ispbillingai/freeispserverbox/concept-prompts/bottombox-render-prompt.md

# FreeISP Bottom Power/Cable Box — Render Prompt (Ubiquiti M2 slanted style)

The wiring/power compartment that bolts UNDER the main enclosure: power-in/out +
internet glands, click-to-close cover (moving) over a fixed base, unused holes cap off.

## ⭐ BEST PROMPT (NanoStation M2 language — the junction-box version below MISSED it)
Photorealistic product render of a slim, elegant cable-and-power management module in
the exact design language of a Ubiquiti NanoStation Loco M2 — a clean minimalist
matte-white device, slim and gently tapered, smooth rounded edges, no visible screws on
the front. It mounts under a smart WiFi hotspot enclosure. Its signature feature is a
SNAP-OFF / SLIDE-OFF cable-management cover (the moving part) running along the lower
face that conceals all the cable routing; with the cover slid half-off it reveals a
recessed channel holding cable glands labelled "POWER IN", "POWER OUT", "INTERNET",
neat terminal blocks and a small rocker switch. Unused gland holes are capped with
flush snap-in blanking plugs. One thin green "FreeISP" accent line. Three-quarter angle
with the cover half-removed so you see BOTH the clean closed M2 look and the hidden
cable channel inside. Soft studio lighting, light-grey gradient background, ultra sharp,
4k, world-class minimalist industrial design exactly like Ubiquiti NanoStation,
professional product photography.

## (older) generic junction-box prompt — missed the slim M2 concept
Photorealistic product render of a premium weatherproof power-and-cable junction
module that mounts UNDERNEATH a smart WiFi hotspot enclosure — a compact modern unit
about 290 × 120 × 50 mm, matte light-grey ABS, in the clean industrial style of
Ubiquiti airMAX / NanoStation M2 gear. The form has a SLANTED, tapered lower face (a
subtle wedge). On the angled bottom face sit several cable glands clearly labelled
"POWER IN", "POWER OUT" and "INTERNET"; two extra unused gland holes are neatly capped
with clean removable blanking plugs (knockouts). A snap-fit CLICK-TO-CLOSE cover — the
moving part — opens on a discreet hinge to reveal the terminal/switch compartment
inside (terminal blocks + a rocker switch), with a fine flush seam line and a
weatherproof gasket where it clicks shut; the fixed base sits below it. Matte finish,
softly rounded edges, one thin green "FreeISP" accent line along the slant.
Three-quarter hero angle showing both the slant and the cover half-open, soft studio
lighting, clean light-grey gradient background, gentle reflections, ultra sharp, 4k,
world-class minimalist industrial design like Ubiquiti, professional product photography.

## VARIANTS
- CLOSED HERO: "...cover fully clicked shut, clean flush seam, all glands capped —
  show the sealed weatherproof look head-on."
- EXPLODED: "...exploded view: fixed base + glands/terminals, the click cover lifting
  off, and the snap-in blanking plugs floating out."

## MECHANISM NOTES (for turning into CAD later)
- FIXED base: holds glands, terminal blocks, switch; bolts up to the enclosure.
- MOVING cover: snap-fit lid on a living hinge; push = clicks shut (hook + catch),
  grip-pull = pops open. (Same snap-latch family as the enclosure access door.)
- Closable holes: each gland position is a knockout with a snap-in blanking plug;
  unused = capped + weatherproof.

## TIPS
- Add: "render the words exactly: POWER IN, POWER OUT, INTERNET, FreeISP."
- Generate 3-4, pick best, send to Claude to build into Fusion CAD.
