ispbillingai/freeispserverbox/concept-prompts/module-current-render-prompt.md

# FreeISP Module (current design) — Render Prompts for ChatGPT/Midjourney

Goal: photoreal render of the CURRENT module so we can describe edits, PLUS a
signature "stylish line" to stand out (clean basic form + one distinctive accent,
the way premium energy/tech brands differentiate).

## MAIN PROMPT (signature glowing accent line)
Photorealistic product render of a premium smart WiFi hotspot control module — a
compact modern device about 135 × 120 × 40 mm, matte light-grey ABS plastic with a
fine soft-touch finish, gently rounded corners and a subtle chamfered top edge. The
clean top face has: a recessed panel framed by a fine engraved seam line; an engraved
"FreeISP" wordmark near the top; a small inset 1.8-inch LCD screen displaying
"ONLINE ● PPPoE 12  Hotspot 34"; two round status LEDs glowing bright green, labelled
POWER and INTERNET; and a tiny engraved spec block in the bottom corner reading
"FIR-HS250 · 12V DC 2A". Crisp fine vertical vent slots along the sides. THE SIGNATURE
DETAIL — one single thin glowing green accent light-line running cleanly across the
front, wrapping subtly around the lower body: a distinctive minimalist light stripe
that sets the brand apart. Three-quarter hero angle, soft cinematic studio lighting,
clean light-grey gradient background, gentle reflections, shallow depth of field,
ultra sharp, 4k, hyper-detailed, world-class minimalist industrial design in the
spirit of Ubiquiti, MikroTik and premium energy-tech brands, professional product
photography.

## ACCENT-LINE VARIANTS (swap the "SIGNATURE DETAIL" sentence)
- GLOW LINE: "one single thin glowing green light-line across the front edge."
- RECESSED GROOVE: "one crisp recessed accent groove with a glossy green inlay
  wrapping the body — a moulded signature line, not lit."
- TWO-TONE SEAM: "a clean two-tone split — matte light-grey top, darker grey base,
  divided by one sharp green pinstripe."
- CORNER WRAP: "a single green accent line that wraps one rounded corner from top
  to base, like a signature ribbon."

## TIPS
- Add: "render the words exactly: FreeISP, POWER, INTERNET, ONLINE — no spelling
  mistakes."
- Colours: "matte light-grey body, bright green accents (logo, LEDs, signature line),
  glossy black screen."
- Generate 3–4, pick the best, send to Claude to translate into the Fusion CAD.
