ispbillingai/freeispserverbox/concept-prompts/module-render-prompt.md

# FreeISP Smart-Module — Image-Render Prompts (for ChatGPT / Midjourney)

Use these for BEAUTY renders only (marketing/pitch). The buildable truth is the
Fusion CAD (`fusion/`). Renders ignore exact mm — they're for the look.

## 1. HERO — the ENCLOSED module (main prompt)
# Note: the module is a SEALED router unit. The TAP pad + screen live on the
# OUTSIDE product face (the RC522 reader sits inside and reads through plastic),
# NOT on the module. So the module itself is clean/sealed.
Photorealistic product render of a premium enclosed mini WiFi router — a small
sealed modern gadget like a MikroTik hEX or Ubiquiti EdgeRouter, about
135 × 120 × 40 mm, matte light-grey ABS plastic with a fine soft-touch texture,
generously rounded corners and a subtle chamfered top edge, clean seamless
one-piece body. A small glowing green "FreeISP" logo on top, and a neat row of
tiny green status indicator LEDs. Fine crisp horizontal vent louvres along both
side walls. A clean recessed row of ports along the front edge. No screen, no
buttons — a clean sealed premium enclosure. Three-quarter hero angle, light-grey
gradient studio background, soft cinematic studio lighting, gentle reflections,
shallow depth of field, ultra sharp, 4k, hyper-detailed, world-class industrial
product design, professional product photography.

## 2. FRONT-ON (matches the CAD top view — best for comparing to Fusion)
Same module as above, photographed perfectly straight-on (flat front view), the
top panel filling the frame, even soft lighting, no perspective distortion, clean
light-grey background, 4k product photography.

## 3. EXPLODED / "holds everything" (shows it's the brain)
The same FreeISP module shown as a clean exploded view: the premium vented top
shell lifting off to reveal a neat internal carrier board with an ESP32, a small
battery, and a buck converter screwed onto standoffs, thin wiring routed tidily,
matte black internals. Studio lighting, light-grey gradient background, 4k,
engineering-beauty product shot.

## Tips
- Add: "no spelling mistakes in the text, render the words exactly: FreeISP,
  POWER, INTERNET, TAP, ONLINE".
- If colours look off, add: "colour scheme: matte light grey body, bright green
  accents (logo + LEDs), glossy black screen".
- Generate 3–4 variations, pick the best, then send it to Claude to match the CAD.
