ispbillingai/freeispserverbox/firmware/DriveProof/summary.txt

DRV STORED row=1 strong=0.000 weak=0.000
DRV STORED row=2 strong=0.000 weak=0.000
DRV STORED row=3 strong=0.000 weak=0.000
DRV STORED row=4 strong=0.000 weak=0.000
DRV STORED row=5 strong=0.000 weak=0.000
DRV STORED row=6 strong=0.000 weak=0.000
DRV SAMPLE row=1 ok=1 s=570.12,680.12,692.88,685.00 w=836.12,868.88,911.12,904.75
DRV TARGET row=2 x=240
DRV SAMPLE row=2 ok=1 s=266.25,457.00,458.38,482.75 w=380.62,411.38,658.75,666.75
DRV TARGET row=3 x=240
DRV SAMPLE row=3 ok=1 s=202.88,205.88,207.75,207.88 w=306.25,312.12,309.12,314.12
DRV TARGET row=4 x=240
DRV SAMPLE row=4 ok=1 s=373.88,376.88,397.12,426.38 w=625.12,624.75,659.62,666.38
DRV TARGET row=5 x=240
DRV SAMPLE row=5 ok=1 s=150.00,150.75,153.50,155.38 w=312.38,319.00,316.50,319.88
DRV TARGET row=6 x=240
DRV SAMPLE row=6 ok=1 s=142.00,142.00,142.00,142.25 w=219.25,230.38,332.50,339.75
DRV RUN COMPLETE
DRV STORED row=1 strong=657.031 weak=880.219
DRV STORED row=2 strong=416.094 weak=529.375
DRV STORED row=3 strong=206.094 weak=310.406
DRV STORED row=4 strong=393.562 weak=643.969
DRV STORED row=5 strong=152.406 weak=316.938
DRV STORED row=6 strong=142.062 weak=280.469
DRV TARGET row=1 x=240
