ispbillingai/freeispserverbox/firmware/ResistanceProof/summary.txt

RES TARGET row=2 x=240
RES SAMPLE row=2 ok=1 u0=2864.38 down=2815.33 u1=2819.92 up=2739.88 u2=2699.33
RES TARGET row=3 x=240
RES SAMPLE row=3 ok=1 u0=2646.08 down=2566.00 u1=2591.88 up=2594.75 u2=2589.71
RES TARGET row=4 x=240
RES SAMPLE row=4 ok=1 u0=2871.83 down=2775.38 u1=2766.46 up=2743.75 u2=2748.21
RES TARGET row=5 x=240
RES SAMPLE row=5 ok=1 u0=2805.83 down=2756.83 u1=2772.21 up=2770.42 u2=2763.04
RES TARGET row=6 x=240
RES SAMPLE row=6 ok=1 u0=3118.00 down=3104.04 u1=3115.46 up=3058.75 u2=3059.83
RES RUN COMPLETE
RES TARGET row=1 x=240
