ispbillingai/freeispserverbox/firmware/FaceUI/home-preview.png

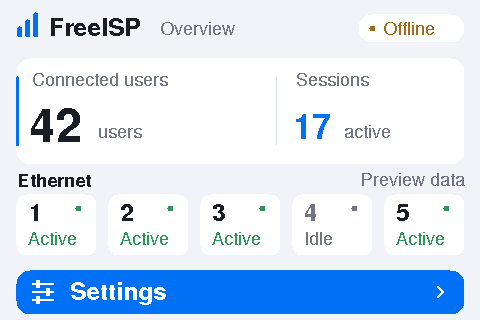
firmware/FaceUI/home-preview.png
