ispbillingai/freeispserverbox/pcb/board.png

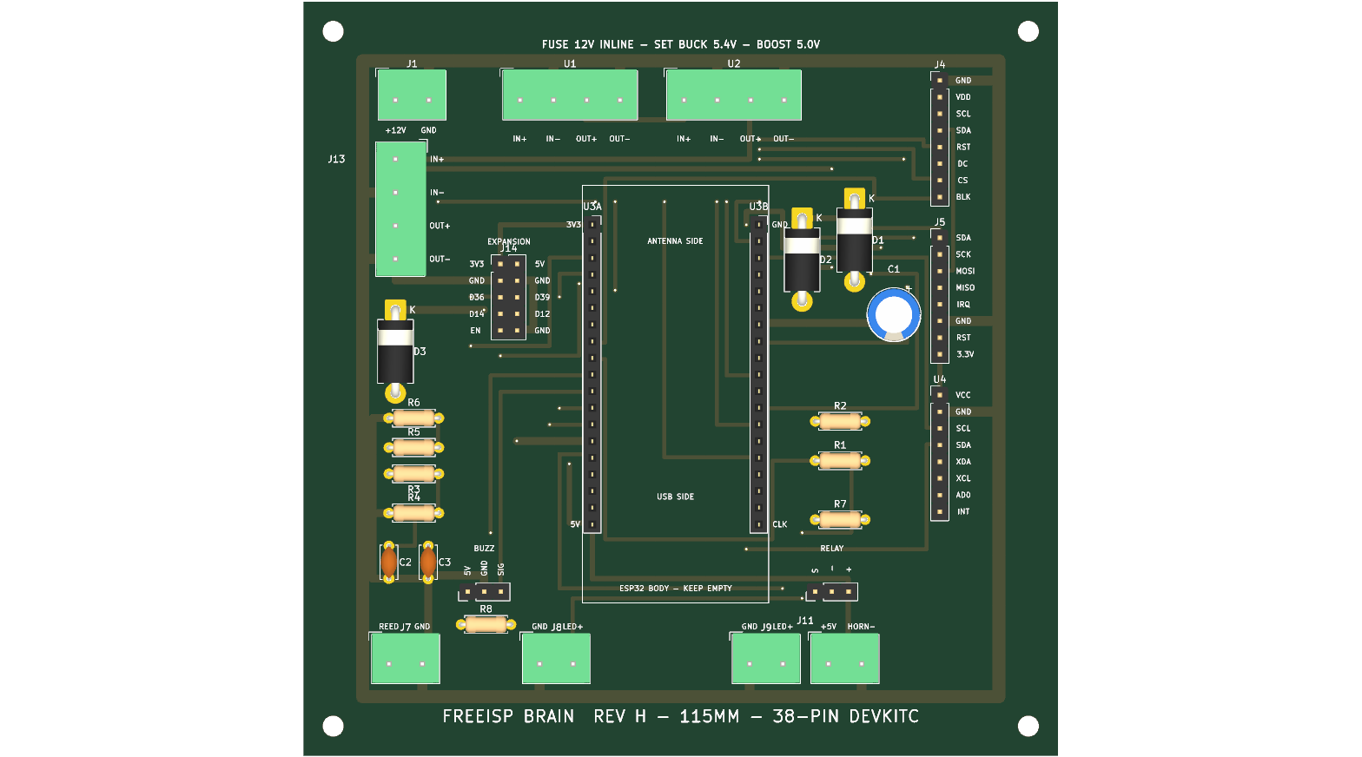
pcb/board.png
