ispbillingai/freeispserverbox/pcb/board_back.png

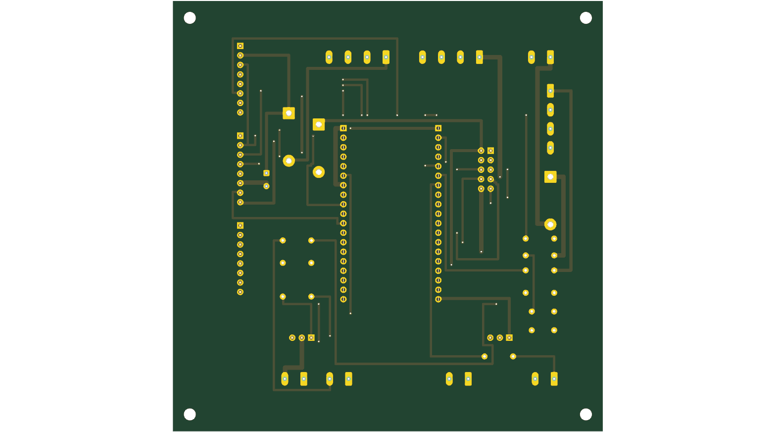
pcb/board_back.png
