ispbillingai/freeispserverbox/pcb/perfboard_layout.png

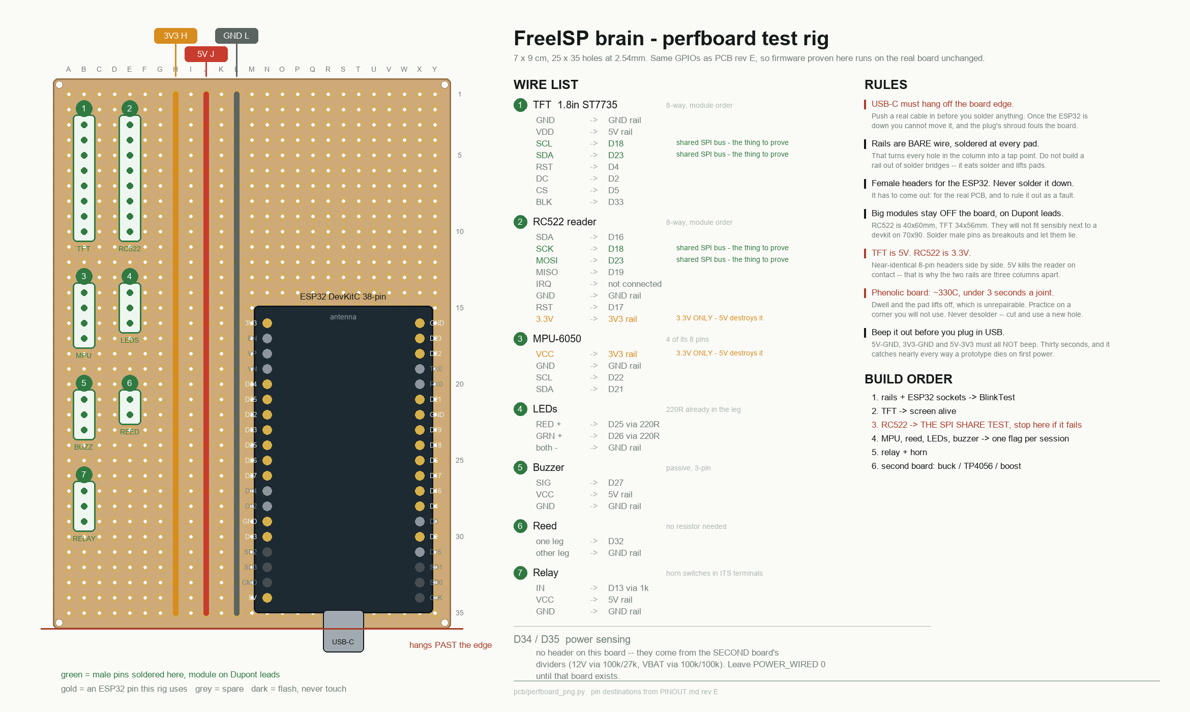
pcb/perfboard_layout.png
