ispbillingai/freeispserverbox/Test Prints/completed.stl

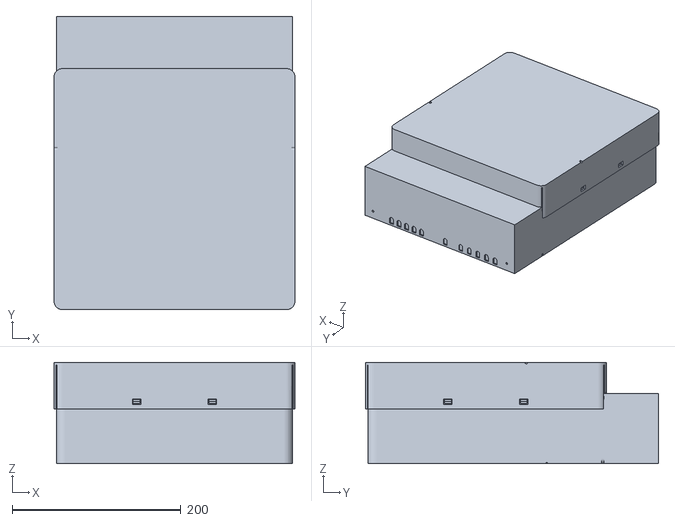
[picture p5: CAD file, 2026-08-18]
Test Prints/completed.stl
286.0 x 348.0 x 120.0
