ispbillingai/freeispserverbox/fir_module_lid.stl

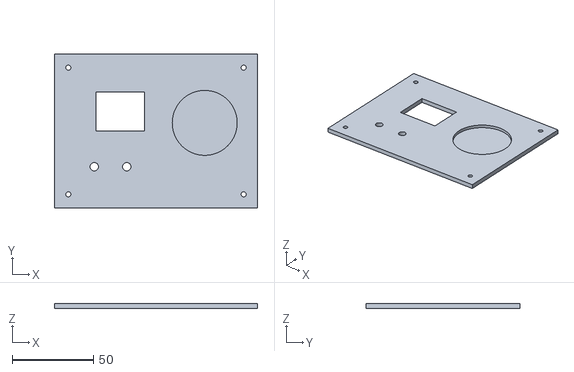
[picture p6: CAD file, 2026-07-08]
fir_module_lid.stl
125.0 x 95.0 x 3.00
