ispbillingai/freeispserverbox/Test Prints/modular final final final.stl

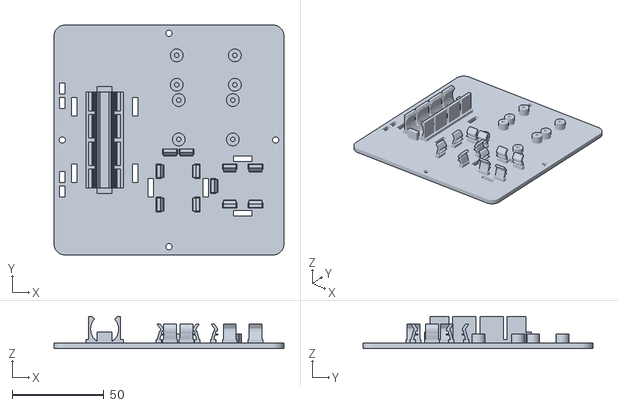
[picture p7: CAD file, 2026-08-18]
Test Prints/modular final final final.stl
125.0 x 125.0 x 17.5
