ispbillingai/freeispserverbox/fir_module_base.stl

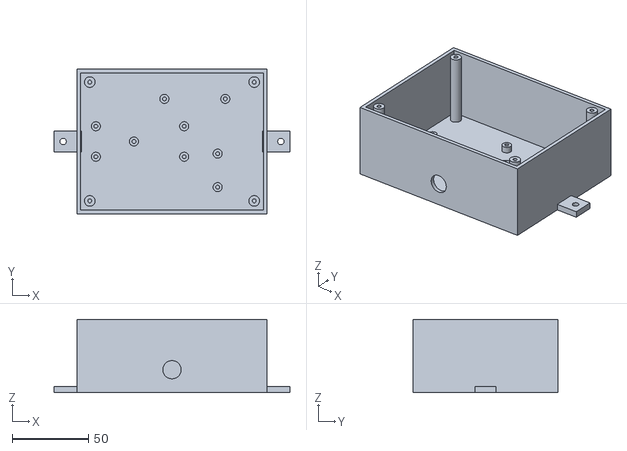
[picture p8: CAD file, 2026-07-08]
fir_module_base.stl
155.0 x 95.0 x 48.0
