ispbillingai/freeispserverbox/Test Prints/brainouter part.stl

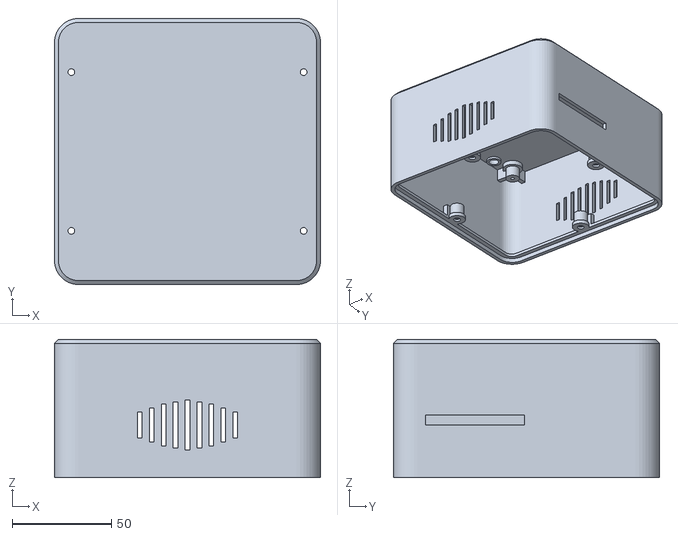
[picture p9: CAD file, 2026-08-18]
Test Prints/brainouter part.stl
134.0 x 134.0 x 69.6
