ispbillingai/freeispserverbox/Test Prints/modularplate.stl

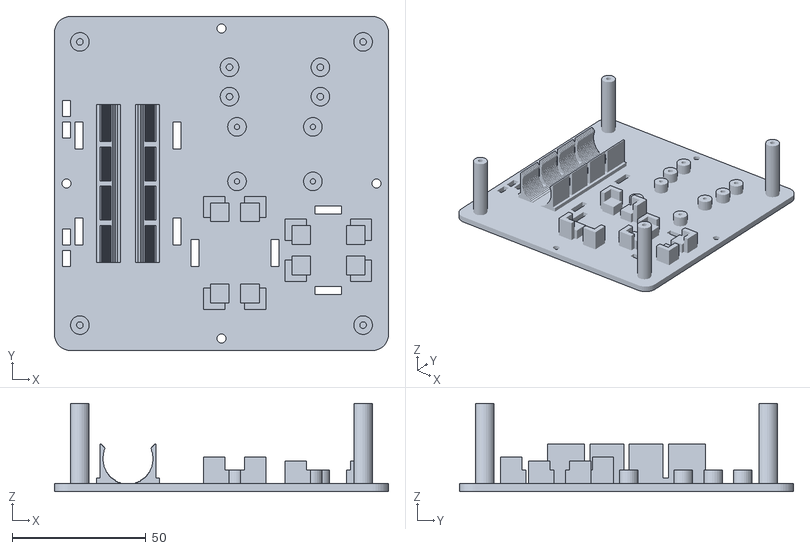
[picture p10: CAD file, 2026-08-18]
Test Prints/modularplate.stl
125.0 x 125.0 x 33.0
