ispbillingai/freeispserverbox/Test Prints/platetopfixedforfitting.stl

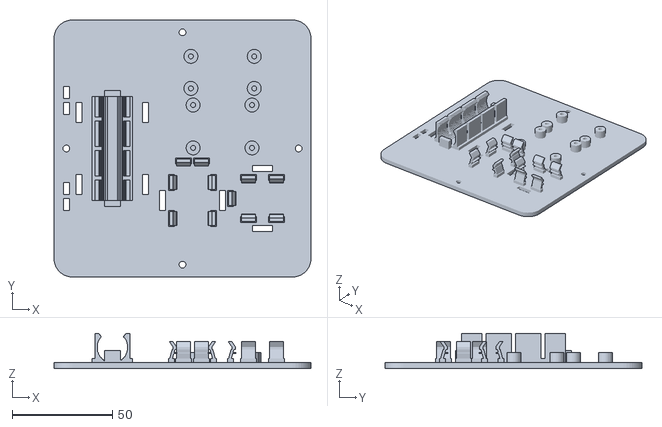
[picture p11: CAD file, 2026-08-18]
Test Prints/platetopfixedforfitting.stl
128.3 x 128.3 x 17.5
