ispbillingai/freeispserverbox/(list of files, cad)

Other CAD files:
Test Prints/final modular plate.stl
Test Prints/Freeispbrain cover plate.stl
Test Prints/completed.f3d
