ispbillingai/freeispserverbox/pcb/assembled.png

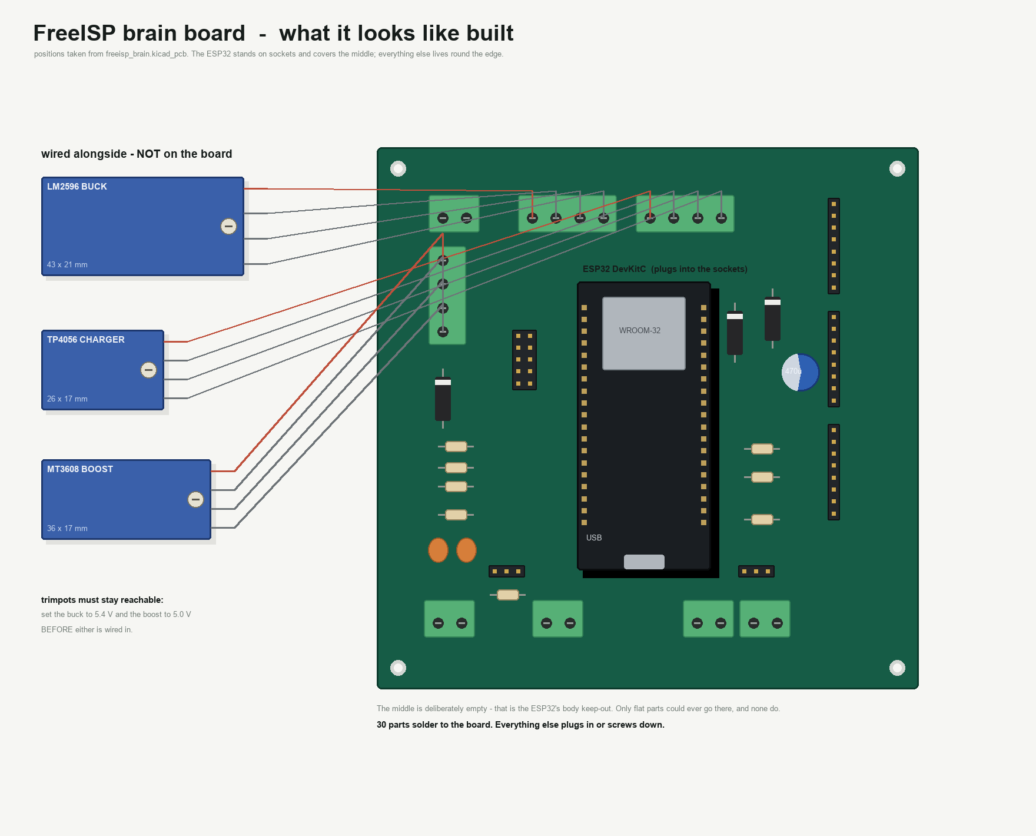
pcb/assembled.png
