ispbillingai/freeispserverbox/pcb/powerchain_wiring.png

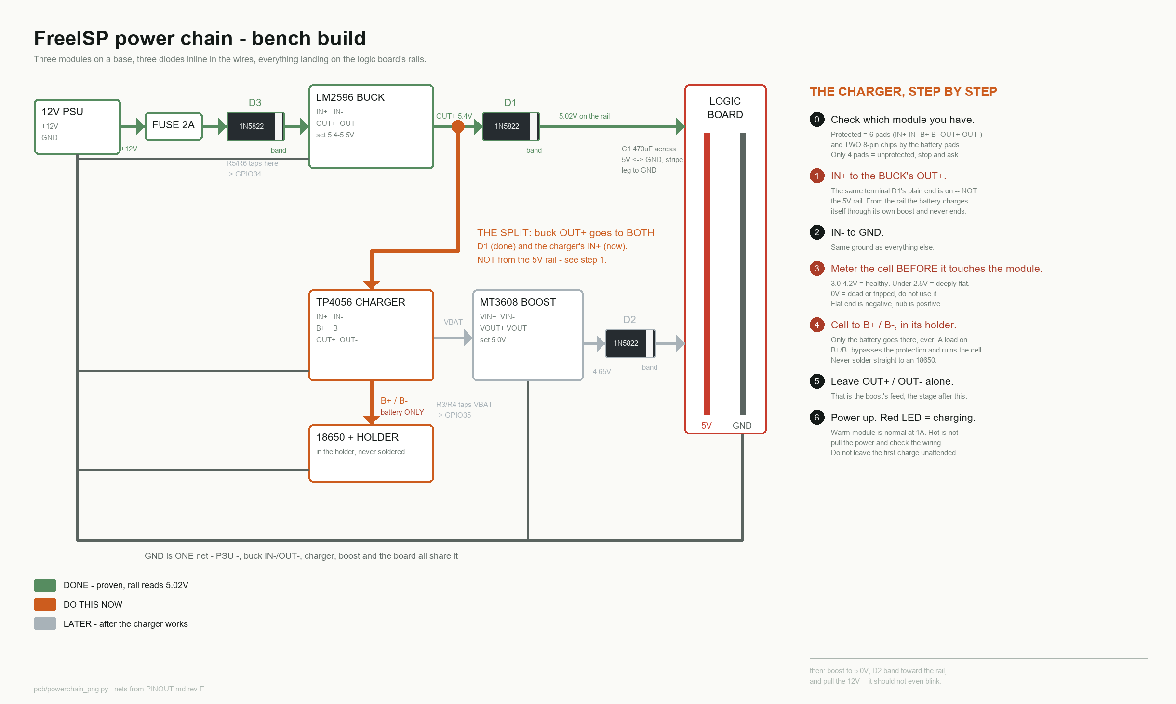
pcb/powerchain_wiring.png
