ispbillingai/freeispserverbox/pcb/wiring_diagram.png

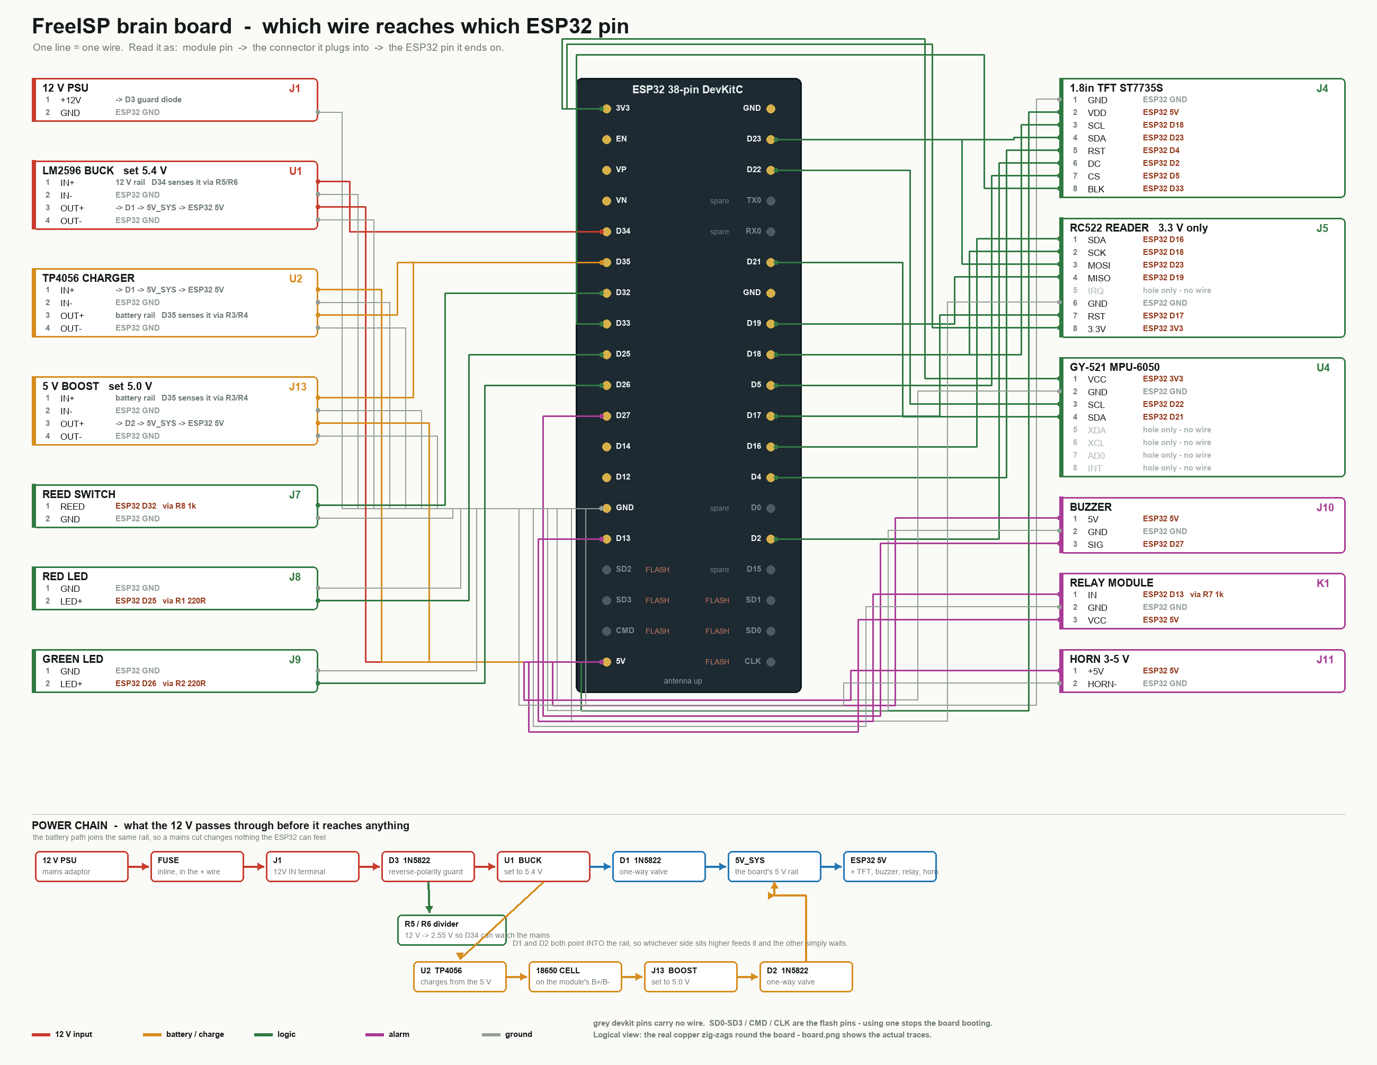
pcb/wiring_diagram.png
