ispbillingai/freeispserverbox/measurements/BOX_measurement_sheet.md

# FreeISP Box — Measurement Sheet (vernier, to 1 mm)

Fill in the blanks and send back. Start with Section A + B (MikroTik) — that's all I need
to design the bottom part. Do C–E when you can.

---------------------------------------------------------------------------
## A. MikroTik RB951 — overall body
- A1  Length (longest side, the port edge runs along this):  ______ mm
- A2  Width / depth (front-to-back):                          ______ mm
- A3  Height / thickness (how tall it sits):                  ______ mm
- A4  Port edge = a LONG side or a SHORT side?                ______

---------------------------------------------------------------------------
## B. MikroTik PORTS  ← the important one
HOW TO MEASURE (do it once, consistently):
  • Stand the 951 with the PORT FACE toward you, ports along the BOTTOM edge.
  • Pick the BOTTOM-LEFT corner of that face = your zero point (0,0).
  • For each port measure TWO numbers:
        X = sideways distance from the left corner to the CENTRE of the port
        Z = height from the bottom up to the CENTRE of the port
  • Also measure each opening's size.

(RB951Ui-2HnD usually has, left-to-right-ish: DC jack, 5x Ethernet, 1x USB, reset.)

| Port | X (mm) | Z (mm) | Opening size (mm) |
|---|---|---|---|
| DC power jack | | | Ø ______ |
| Ethernet 1 (PoE)| | | ____ x ____ |
| Ethernet 2 | | | (same as Eth1) |
| Ethernet 3 | | | |
| Ethernet 4 | | | |
| Ethernet 5 | | | |
| USB | | | ____ x ____ |
| Reset (if open) | | | |

Quick shortcut if the 5 Ethernet ports are evenly spaced:
  - X of the FIRST Ethernet centre: ______
  - centre-to-centre spacing (pitch): ______

---------------------------------------------------------------------------
## C. MikroTik mounting (underside)
- C1  Screw holes or rubber feet on the base?  (yes/no, positions): ______
- C2  Foot / standoff height:                                       ______

---------------------------------------------------------------------------
## D. Clearances (I'll suggest defaults if blank)
- D1  Gap you want around the 951 inside the box:   ______  (default 4 mm)
- D2  Wall thickness:                               ______  (default 2.5 mm)

---------------------------------------------------------------------------
## E. Box overall (decide once all parts are in — you mentioned ~300)
- E1  Internal LENGTH available:  ______
- E2  Internal WIDTH available:   ______
- E3  Internal HEIGHT available:  ______
