ispbillingai/freeispserverbox/firmware/DriveProof/calibrated-summary.txt

DRV STORED row=1 strong=0.000 weak=0.000 ratio=0.00000
DRV STORED row=2 strong=0.000 weak=0.000 ratio=0.00000
DRV STORED row=3 strong=0.000 weak=0.000 ratio=0.00000
DRV STORED row=4 strong=0.000 weak=0.000 ratio=0.00000
DRV STORED row=5 strong=0.000 weak=0.000 ratio=0.00000
DRV STORED row=6 strong=0.000 weak=0.000 ratio=0.00000
DRV SAMPLE row=1 ok=1 clipped=0 atten=0 s=747.75,762.88,781.38,787.75,804.75 w=870.25,895.12,917.62,919.38 q=1.20667,1.21859,1.23493,1.21435
DRV TARGET row=2 x=240
DRV SAMPLE row=2 ok=1 clipped=0 atten=0 s=403.38,503.38,542.75,539.12,536.62 w=490.62,644.88,648.25,652.00 q=1.09651,1.28945,1.24688,1.26442
DRV TARGET row=3 x=240
DRV SAMPLE row=3 ok=1 clipped=0 atten=0 s=559.25,558.50,538.25,473.50,476.62 w=689.38,667.88,639.62,573.88 q=1.29517,1.27321,1.32796,1.25178
DRV TARGET row=4 x=240
DRV SAMPLE row=4 ok=1 clipped=0 atten=0 s=224.00,223.12,226.88,223.88,228.75 w=299.00,300.75,303.00,306.38 q=1.37105,1.37043,1.37925,1.38998
DRV TARGET row=5 x=240
DRV SAMPLE row=5 ok=1 clipped=0 atten=0 s=483.00,484.12,490.88,491.38,491.38 w=692.38,698.00,691.50,705.12 q=1.54648,1.54763,1.51615,1.55321
DRV TARGET row=6 x=240
DRV SAMPLE row=6 ok=1 clipped=0 atten=0 s=204.00,208.00,231.62,231.50,245.50 w=322.25,327.25,358.12,370.75 q=1.62539,1.54257,1.61309,1.62469
DRV RUN COMPLETE
DRV STORED row=1 strong=776.900 weak=900.594 ratio=1.21647
DRV STORED row=2 strong=505.050 weak=608.938 ratio=1.25565
DRV STORED row=3 strong=521.225 weak=642.688 ratio=1.28419
DRV STORED row=4 strong=225.325 weak=302.281 ratio=1.37515
DRV STORED row=5 strong=488.150 weak=696.750 ratio=1.54705
DRV STORED row=6 strong=224.125 weak=344.594 ratio=1.61889
DRV TARGET row=1 x=240
