ispbillingai/freeispserverbox/pcb/fitcheck_1to1.pdf

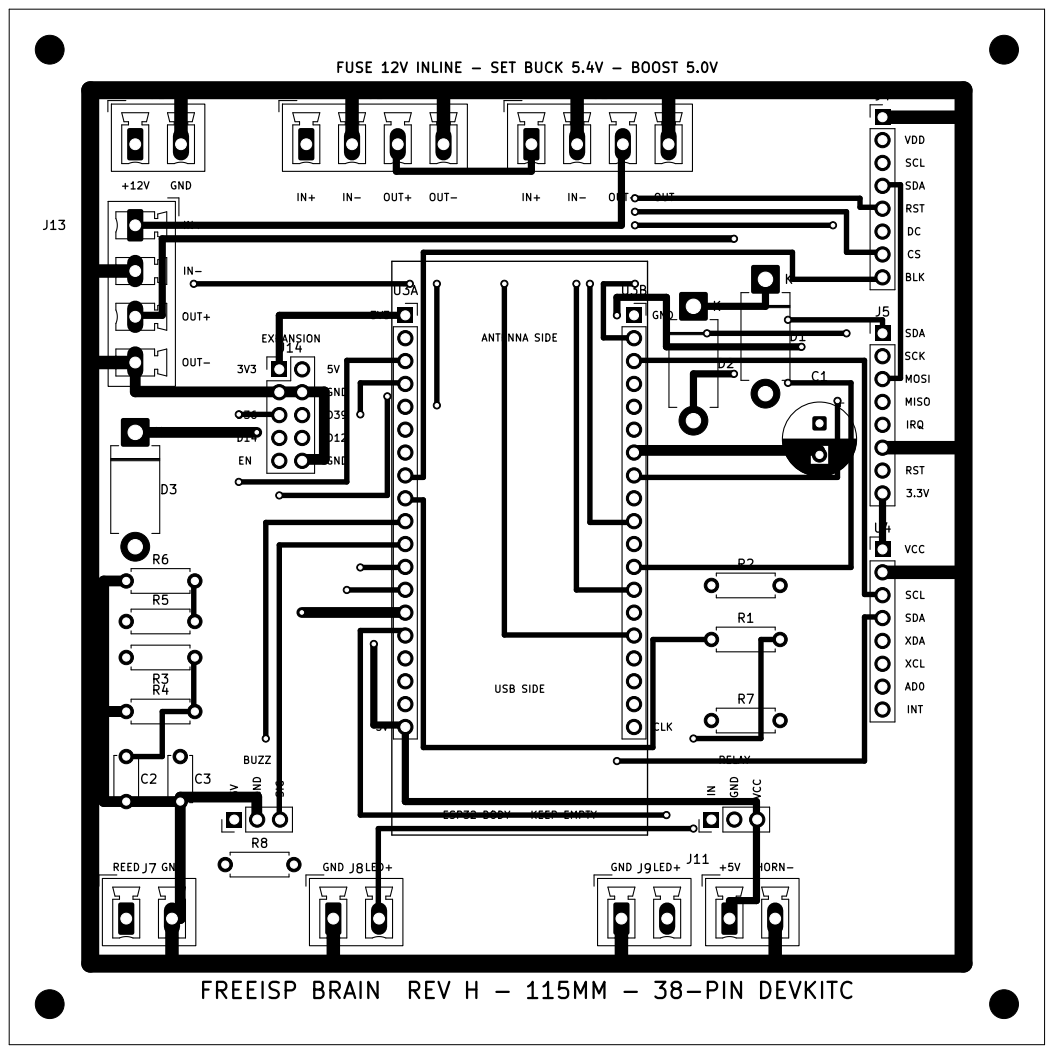
[picture p15: page 1]

VDD
SCL SDA RST DC

ANTENNA SIDE USB SIDE

SDA SCK MOSI MISO

GND
SCL SDA XDA XCL AD0

FREEISP BRAIN REV H - 115MM - 38-PIN DEVKITC
