ispbillingai/freeispserverbox/pcb/freeisp_brain.kicad_pcb

## KiCad design pcb/freeisp_brain.kicad_pcb (2026-08-12)

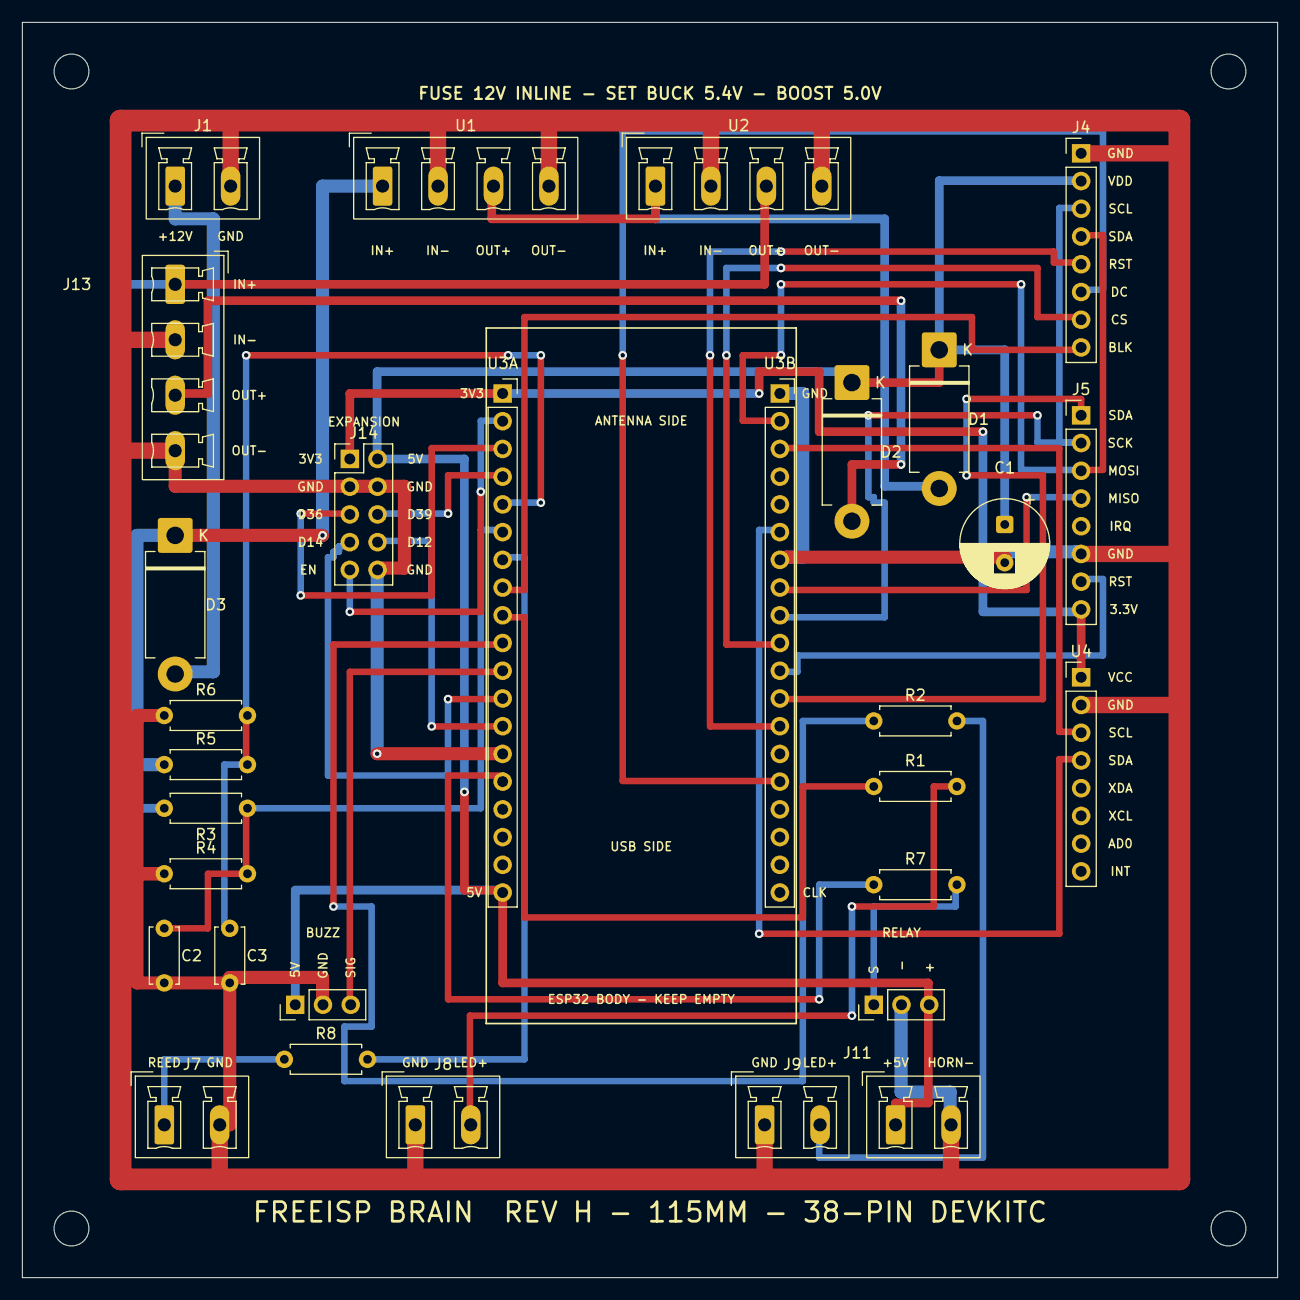
[picture p16: board freeisp_brain.kicad_pcb from above]

Board: 2 copper layers, 115.0 x 115.0 mm, 34 parts (0 on the bottom side), 35 nets.

Parts:
C1: 470u; CP_Radial_D8.0mm_P3.50mm
C2, C3: 100n; C_Disc_D5.0mm_W2.5mm_P5.00mm
D1, D2, D3: 1N5822; D_DO-201AD_P12.70mm_Horizontal
H1, H2, H3, H4: M3; MountingHole_3.2mm_M3
J1: 12V IN; PhoenixContact_MCV_1,5_2-G-5.08_1x02_P5.08mm_Vertical
J4: TFT; PinHeader_1x08_P2.54mm_Vertical
J5: RC522; PinHeader_1x08_P2.54mm_Vertical
J7: REED; PhoenixContact_MCV_1,5_2-G-5.08_1x02_P5.08mm_Vertical
J8: LED R; PhoenixContact_MCV_1,5_2-G-5.08_1x02_P5.08mm_Vertical
J9: LED G; PhoenixContact_MCV_1,5_2-G-5.08_1x02_P5.08mm_Vertical
J10: BUZZER; PinHeader_1x03_P2.54mm_Vertical
J11: HORN; PhoenixContact_MCV_1,5_2-G-5.08_1x02_P5.08mm_Vertical
J13: BOOST IN+ IN- OUT+ OUT-; PhoenixContact_MCV_1,5_4-G-5.08_1x04_P5.08mm_Vertical
J14: EXPANSION; PinHeader_2x05_P2.54mm_Vertical
K1: HORN RLY; PinHeader_1x03_P2.54mm_Vertical
R1, R2: 220R; R_Axial_DIN0207_L6.3mm_D2.5mm_P7.62mm_Horizontal
R3, R4, R5: 100k; R_Axial_DIN0207_L6.3mm_D2.5mm_P7.62mm_Horizontal
R6: 27k; R_Axial_DIN0207_L6.3mm_D2.5mm_P7.62mm_Horizontal
R7, R8: 1k; R_Axial_DIN0207_L6.3mm_D2.5mm_P7.62mm_Horizontal
U1: BUCK IN+ IN- OUT+ OUT-; PhoenixContact_MCV_1,5_4-G-5.08_1x04_P5.08mm_Vertical
U2: CHARGER IN+ IN- OUT+ OUT-; PhoenixContact_MCV_1,5_4-G-5.08_1x04_P5.08mm_Vertical
U3A: ESP32 L; PinSocket_1x19_P2.54mm_Vertical
U3B: ESP32 R; PinSocket_1x19_P2.54mm_Vertical
U4: MPU-6050; PinHeader_1x08_P2.54mm_Vertical

Connections:
+3V3: J5.8, J14.1, U3A.1, U4.1
+5V: D1.2, U1.3, U2.1
+5V_BAT: D2.2, J13.3
+5V_SYS: C1.1, D1.1, D2.1, J4.2, J10.1, J11.1, J14.2, K1.3, U3A.19
+12V: D3.1, R5.1, U1.1
+12V_IN: D3.2, J1.1
BUZZ: J10.3, U3A.11
EXP_D12: J14.8, U3A.13
EXP_D14: J14.7, U3A.12
EXP_D36: J14.5, U3A.3
EXP_D39: J14.6, U3A.4
EXP_EN: J14.9, U3A.2
GND: C1.2, C2.2, C3.2, J1.2, J4.1, J5.6, J7.2, J8.1, J9.1, J10.2, J11.2, J13.2, J13.4, J14.3, J14.4, J14.10, K1.2, R4.1, R6.1, U1.2, U1.4, U2.2, U2.4, U3A.14, U3B.1, U3B.7, U4.2
HORN_DRV: K1.1, R7.2
HORN_IN: R7.1, U3A.15
LED_G: R2.1, U3A.10
LED_G_A: J9.2, R2.2
LED_R: R1.1, U3A.9
LED_R_A: J8.2, R1.2
MISO: J5.4, U3B.8
MOSI: J4.4, J5.3, U3B.2
RC_RST: J5.7, U3B.11
RC_SS: J5.1, U3B.12
REED: R8.2, U3A.7
REED_F: J7.1, R8.1
SCK: J4.3, J5.2, U3B.9
SCL: U3B.3, U4.3
SDA: U3B.6, U4.4
SENSE_BATT: C2.1, R3.2, R4.2, U3A.6
SENSE_MAINS: C3.1, R5.2, R6.2, U3A.5
TFT_BLK: J4.8, U3A.8
TFT_CS: J4.7, U3B.10
TFT_DC: J4.6, U3B.15
TFT_RST: J4.5, U3B.13
VBAT: J13.1, R3.1, U2.3
