ispbillingai/freeispserverbox/pcb/build.py

"""Generate the FreeISP brain board as a standalone KiCad PCB.

Single copper layer, 100 x 100 mm, home-etchable. Stock KiCad footprints are
loaded from the installed library and embedded with placement + net data, so
pad geometry is KiCad's own rather than hand-rolled.

What this writes:  placement, nets, board outline, mounting holes, the
perimeter ground ring and its stubs, and the fused 12 V hops.
What it leaves:    signal routing -- that is done interactively in KiCad,
                   where the router enforces clearance properly.

    python build.py
"""

import json
import math
import os
import uuid as _uuid
import router
import sexp

FPLIB = r"F:\kicad\share\kicad\footprints"
OUT = os.path.join(os.path.dirname(os.path.abspath(__file__)), "freeisp_brain.kicad_pcb")

# board origin on the page: design (0,0) maps here
OX, OY = 60.0, 40.0
# 115mm: Francis's call ("11.5 so everything fits well and is not cramped")
# after the 38-pin devkit's body overhang showed up on the paper test.
# Leaves PCBWay's 100mm cheap tier (~$5 -> ~$15-25 for 5) -- accepted.
BW = BH = 115.0

RING = 9.0           # ground ring inset from the board edge
W_GND = 2.0          # perimeter ring, out in open copper
W_PWR = 1.5
W_HV = 2.5           # offered for the long 12 V horn run
# Stubs leave pads on 2.54 mm pitch, so they must stay narrow enough to clear
# the neighbouring pin: 1.9 mm pad + 0.6 mm clearance leaves 1.98 mm of room.
W_STUB = 1.5
# Fab rules, not etching rules. PCBWay's cheap tier does 0.15 mm; 0.25 mm is
# a comfortable margin and buys real routing room over the 0.6 mm we needed
# when the board was going to be made with chemicals in a tray.
CLEARANCE = 0.45
TRACK_MIN = 0.4

# Library pad sizes are right for a fab -- their drilling is accurate to about
# 0.05 mm, so there is nothing to compensate for. 0 means "leave as drawn".
PAD_P254 = 0
PAD_P508 = 0
PAD_RES = 0

LIB_SOCKET = "Connector_PinSocket_2.54mm"
LIB_HEADER = "Connector_PinHeader_2.54mm"
LIB_TERM = "Connector_Phoenix_MC_HighVoltage"
LIB_RES = "Resistor_THT"
LIB_DIODE = "Diode_THT"
LIB_CAP = "Capacitor_THT"
LIB_HOLE = "MountingHole"

FP_SOCKET19 = "PinSocket_1x19_P2.54mm_Vertical"
FP_TERM2 = "PhoenixContact_MCV_1,5_2-G-5.08_1x02_P5.08mm_Vertical"
FP_TERM4 = "PhoenixContact_MCV_1,5_4-G-5.08_1x04_P5.08mm_Vertical"
FP_RES = "R_Axial_DIN0207_L6.3mm_D2.5mm_P7.62mm_Horizontal"
FP_DIODE = "D_DO-201AD_P12.70mm_Horizontal"
FP_CAP_EL = "CP_Radial_D8.0mm_P3.50mm"
FP_CAP_D = "C_Disc_D5.0mm_W2.5mm_P5.00mm"
FP_HOLE = "MountingHole_3.2mm_M3"


def hdr(n):
    return f"PinHeader_1x0{n}_P2.54mm_Vertical"


# ---------------------------------------------------------------- nets
NETS = [
    "", "GND", "+5V", "+5V_BAT", "+5V_SYS", "+3V3", "+12V", "+12V_IN", "VBAT",
    "SENSE_BATT", "SENSE_MAINS", "REED", "REED_F", "LED_R", "LED_R_A", "LED_G",
    "LED_G_A", "BUZZ", "HORN_IN", "HORN_DRV", "MOSI", "MISO", "SCK", "TFT_CS",
    "TFT_DC", "TFT_RST", "TFT_BLK", "RC_SS", "RC_RST", "SDA", "SCL",
    # brought out to the expansion header for whatever comes later
    "EXP_D36", "EXP_D39", "EXP_D14", "EXP_D12", "EXP_EN",
]
NET_ID = {name: i for i, name in enumerate(NETS)}

# ---------------------------------------------------------------- parts
# ref: (lib, footprint, x, y, rot, value, {pad_number: net})
#
# ESP32 rows: 38-PIN DevKitC order (Francis counted 19 pins per side,
# 2026-07-30 -- NOT the 30-pin V1 the first draft assumed). Antenna up:
#   U3A (left):  3V3 EN VP VN 34 35 32 33 25 26 27 14 12 GND 13 SD2 SD3 CMD 5V
#   U3B (right): GND 23 22 TX0 RX0 21 GND 19 18 5 17 16 4 0 2 15 SD1 SD0 CLK
# SD0-SD3/CMD/CLK are the FLASH pins (GPIO6-11) -- they exist as holes and
# must stay unconnected forever. Row spacing DEFAULTS to 25.4mm (DevKitC
# standard) -- Francis verifies with the vernier + paper test before order.
ESP_ROW = 25.4
U3A_NETS = {
    1: "+3V3",       # 3V3 is top-LEFT on the 38-pin board
    5: "SENSE_MAINS",   # GPIO34
    6: "SENSE_BATT",    # GPIO35
    7: "REED",          # GPIO32
    8: "TFT_BLK",       # GPIO33
    9: "LED_R",         # GPIO25
    10: "LED_G",        # GPIO26
    11: "BUZZ",         # GPIO27
    14: "GND",
    15: "HORN_IN",      # GPIO13
    19: "+5V_SYS",      # 5V/VIN, bottom-left -- eats from whichever diode wins
    # --- spares brought out to J14, so a later idea needs no new board ---
    2: "EXP_EN",        # reset: a button to GND reboots the box
    3: "EXP_D36",       # VP  - input ONLY, ADC1, no internal pull-up
    4: "EXP_D39",       # VN  - input ONLY, ADC1, no internal pull-up
    12: "EXP_D14",      # a full GPIO with an internal pull-up: best for buttons
    13: "EXP_D12",      # strapping pin - must be LOW at boot
}
U3B_NETS = {
    1: "GND",
    2: "MOSI",          # GPIO23
    3: "SCL",           # GPIO22
    6: "SDA",           # GPIO21
    7: "GND",
    8: "MISO",          # GPIO19
    9: "SCK",           # GPIO18
    10: "TFT_CS",       # GPIO5
    11: "RC_RST",       # GPIO17
    12: "RC_SS",        # GPIO16
    13: "TFT_RST",      # GPIO4
    15: "TFT_DC",       # GPIO2
}

PARTS = {
    # --- power in, top row. The buck and charger are wire-pad modules, not
    # pluggable headers, so they bolt alongside and land on screw terminals.
    # Fuse the 12 V feed inline in the wire (silkscreened as a reminder).
    # +12V first to match PSU labelling (review M2). D3 downstream makes a
    # reversed hookup harmless instead of fatal to the buck.
    "J1":  (LIB_TERM, FP_TERM2, 14, 15, 0, "12V IN",
            {1: "+12V_IN", 2: "GND"}),
    "D3":  (LIB_DIODE, FP_DIODE, 14, 47, 270, "1N5822",
            {1: "+12V", 2: "+12V_IN"}),   # series reverse-polarity protection
    "U1":  (LIB_TERM, FP_TERM4, 33, 15, 0, "BUCK  IN+ IN- OUT+ OUT-",
            {1: "+12V", 2: "GND", 3: "+5V", 4: "GND"}),
    # Protected TP4056: the LOAD hangs on the module's OUT+/OUT- (behind the
    # DW01 protection FETs). The battery wires to the module's own B+/B- pads
    # directly and never touches this board. Labelling the terminal B+/B-
    # would instruct an unprotected discharge path.
    "U2":  (LIB_TERM, FP_TERM4, 58, 15, 0, "CHARGER  IN+ IN- OUT+ OUT-",
            {1: "+5V", 2: "GND", 3: "VBAT", 4: "GND"}),

    # --- backup power: step-up + the diode-OR where the two 5V rails meet.
    # Mains alive: buck 5V wins through D1 (charger tops the cell up).
    # Mains cut: boost 5V takes over through D2. No code, no switching.
    # Charger IN+ stays on the BUCK rail on purpose -- feeding it from
    # 5V_SYS would let the battery charge itself through the boost.
    # vertical down the left edge (rot 270 runs the pads downward)
    "J13": (LIB_TERM, FP_TERM4, 14, 24, 270, "BOOST  IN+ IN- OUT+ OUT-",
            {1: "VBAT", 2: "GND", 3: "+5V_BAT", 4: "GND"}),
    "D1":  (LIB_DIODE, FP_DIODE, 84, 30, 270, "1N5822",
            {1: "+5V_SYS", 2: "+5V"}),        # pad 1 = cathode (band UP)
    # vertical, right of U3B -- the 19-pin socket ate its old horizontal spot
    "D2":  (LIB_DIODE, FP_DIODE, 76, 33, 270, "1N5822",
            {1: "+5V_SYS", 2: "+5V_BAT"}),    # cathode/band UP

    # --- the brain: 38-pin DevKitC in two 19-pin sockets ---
    "U3A": (LIB_SOCKET, FP_SOCKET19, 44, 34, 0, "ESP32 L", U3A_NETS),
    "U3B": (LIB_SOCKET, FP_SOCKET19, 44 + ESP_ROW, 34, 0, "ESP32 R", U3B_NETS),

    # --- peripherals. Pin ORDER is the module's own silkscreen order, and
    # every physical pin gets a hole even where we do not use the signal.
    # TFT (blue ST7735S): GND VDD SCL SDA RST DC CS BLK
    # All three stack down the right edge. U4 was briefly in the channel
    # between the ESP32 rows -- that channel is a dead end (a pin row cannot
    # be crossed), so every trace to it had to come the long way round and
    # curl past U4's own unused pins. Six nets ended up knotted in there.
    "J4":  (LIB_HEADER, hdr(8), 97, 12, 0, "TFT",
            {1: "GND", 2: "+5V_SYS", 3: "SCK", 4: "MOSI", 5: "TFT_RST",
             6: "TFT_DC", 7: "TFT_CS", 8: "TFT_BLK"}),
    # RC522: SDA SCK MOSI MISO IRQ GND RST 3.3V  (IRQ unused but present)
    "J5":  (LIB_HEADER, hdr(8), 97, 36, 0, "RC522",
            {1: "RC_SS", 2: "SCK", 3: "MOSI", 4: "MISO",
             6: "GND", 7: "RC_RST", 8: "+3V3"}),
    # GY-521: VCC GND SCL SDA XDA XCL AD0 INT  (last four unused but present)
    "U4":  (LIB_HEADER, hdr(8), 97, 60, 0, "MPU-6050",
            {1: "+3V3", 2: "GND", 3: "SCL", 4: "SDA"}),

    # --- passives ---
    # 12V mains-presence divider lives ON the board (review C1): the +12V
    # rail, never a field wire, feeds it. 12V * 27/127 = 2.55V at GPIO34.
    "R5":  (LIB_RES, FP_RES, 13, 68, 0, "100k", {1: "+12V", 2: "SENSE_MAINS"}),
    "R6":  (LIB_RES, FP_RES, 13, 63.5, 0, "27k", {1: "GND", 2: "SENSE_MAINS"}),
    "R3":  (LIB_RES, FP_RES, 13, 72, 0, "100k", {1: "VBAT", 2: "SENSE_BATT"}),
    "R4":  (LIB_RES, FP_RES, 13, 78, 0, "100k", {1: "GND", 2: "SENSE_BATT"}),
    # x=36: clear of the 19-pin socket's courtyard, which now reaches y75.5
    "R2":  (LIB_RES, FP_RES, 78, 64, 0, "220R", {1: "LED_G", 2: "LED_G_A"}),
    "R1":  (LIB_RES, FP_RES, 78, 70, 0, "220R", {1: "LED_R", 2: "LED_R_A"}),
    "R8":  (LIB_RES, FP_RES, 24, 95, 0, "1k", {1: "REED_F", 2: "REED"}),
    "R7":  (LIB_RES, FP_RES, 78, 79, 0, "1k", {1: "HORN_IN", 2: "HORN_DRV"}),
    # ADC smoothing (100n at each divider node) + bulk on the diode-OR rail.
    # Discs sit in the channel under the ESP32 -- LOW parts only there.
    "C2":  (LIB_CAP, FP_CAP_D, 13, 83, 270, "100n", {1: "SENSE_BATT", 2: "GND"}),
    "C3":  (LIB_CAP, FP_CAP_D, 19, 83, 270, "100n", {1: "SENSE_MAINS", 2: "GND"}),
    "C1":  (LIB_CAP, FP_CAP_EL, 90, 46, 270, "470u", {1: "+5V_SYS", 2: "GND"}),

    # --- field terminals, bottom row (J12 sense header DELETED, review C1/m5:
    # both sense sources are on-board nets; a field pin invited 12V into a
    # 3.3V-max input-only GPIO) ---
    # The strip below the ESP32's USB end (x ~48-65 past y92) is KEPT EMPTY:
    # the USB plug overmold + cable must reach the soldered-in devkit for
    # reflashing. J9 moved right of the path; J10/K1 moved up beside R8/R7.
    "J7":  (LIB_TERM, FP_TERM2, 13, 101, 0, "REED", {1: "REED_F", 2: "GND"}),
    "J8":  (LIB_TERM, FP_TERM2, 36, 101, 0, "LED R", {1: "GND", 2: "LED_R_A"}),
    "J9":  (LIB_TERM, FP_TERM2, 68, 101, 0, "LED G", {1: "GND", 2: "LED_G_A"}),
    # buzzer + relay live on 5V_SYS: the alarm must sound with the mains cut.
    # Raised off the bottom row so header pins + wires clear the USB cable.
    "J10": (LIB_HEADER, hdr(3), 25, 90, 90, "BUZZER",
            {1: "+5V_SYS", 2: "GND", 3: "BUZZ"}),
    # R7 in the drive line stops the relay board's opto back-feeding GPIO13;
    # K1 now sits directly below R7 on the horn side, clear of the USB path
    "K1":  (LIB_HEADER, hdr(3), 78, 90, 90, "HORN RLY",
            {1: "HORN_DRV", 2: "GND", 3: "+5V_SYS"}),
    # Horn loop (review C2 -- the old HORN_RET pad connected to NOTHING):
    # J11 5V -> relay COM, relay NO -> horn +, horn - -> J11 HORN- -> GND.
    # Francis's horn is 3-5V, NOT 12V -- so it feeds from 5V_SYS: it keeps
    # sounding on battery after a mains cut, and can never see 12V.
    "J11": (LIB_TERM, FP_TERM2, 80, 101, 0, "HORN",
            {1: "+5V_SYS", 2: "GND"}),

    # --- EXPANSION: every spare pin plus power and ground, so a button,
    # sensor or anything else can be added later without a new board.
    # TX0/RX0 are deliberately NOT here - they are the USB serial port.
    "J14": (LIB_HEADER, "PinHeader_2x05_P2.54mm_Vertical", 30, 40, 0,
            "EXPANSION",
            {1: "+3V3",    2: "+5V_SYS",
             3: "GND",     4: "GND",
             5: "EXP_D36", 6: "EXP_D39",
             7: "EXP_D14", 8: "EXP_D12",
             9: "EXP_EN", 10: "GND"}),

    # --- mechanical ---
    "H1":  (LIB_HOLE, FP_HOLE, 4.5, 4.5, 0, "M3", {}),
    "H2":  (LIB_HOLE, FP_HOLE, 110.5, 4.5, 0, "M3", {}),
    "H3":  (LIB_HOLE, FP_HOLE, 4.5, 110.5, 0, "M3", {}),
    "H4":  (LIB_HOLE, FP_HOLE, 110.5, 110.5, 0, "M3", {}),
}


def uid():
    return sexp.q(str(_uuid.uuid4()))


def load_fp(lib, name):
    path = os.path.join(FPLIB, lib + ".pretty", name + ".kicad_mod")
    with open(path, encoding="utf-8") as fh:
        return sexp.parse(fh.read())


def set_at(node, x, y, rot=0):
    at = sexp.find(node, "at")
    vals = ["at", f"{x:.4f}", f"{y:.4f}"] + ([f"{rot:.0f}"] if rot else [])
    if at is None:
        node.insert(1, vals)
    else:
        at[:] = vals


def place(ref, spec):
    lib, name, dx, dy, rot, value, netmap = spec
    fp = load_fp(lib, name)

    # identify as a library footprint and position it on the page
    fp[1] = sexp.q(f"{lib}:{name}")
    for key in ("version", "generator", "generator_version"):
        node = sexp.find(fp, key)
        if node is not None:
            fp.remove(node)

    layer = sexp.find(fp, "layer")
    idx = fp.index(layer) + 1 if layer else 2
    fp.insert(idx, ["at", f"{OX + dx:.4f}", f"{OY + dy:.4f}"] + ([f"{rot:.0f}"] if rot else []))
    fp.insert(idx + 1, ["uuid", uid()])

    # a few reference texts land on neighbours at their library default spot;
    # these overrides are in FOOTPRINT-LOCAL coords (they rotate with the part)
    ref_at = {"D1": (6.35, -3.6), "D2": (6.35, -3.6), "J13": (0.0, 9.0),
              "J11": (-3.5, -6.6), "R3": (3.81, 2.4), "C1": (-5.2, 0.0)}.get(ref)

    # reference + value text
    for prop in sexp.find_all(fp, "property"):
        pname = sexp.unq(prop[1])
        if pname == "Reference":
            prop[2] = sexp.q(ref)
            # mounting-hole refs run off the edge; the bottom 2.54 mm headers
            # have no room -- their function headings are drawn instead
            if lib == LIB_HOLE or ref in ("J10", "J12", "K1"):
                prop.append(["hide", "yes"])
            if ref_at is not None:
                pat = sexp.find(prop, "at")
                pat[1], pat[2] = f"{ref_at[0]:.2f}", f"{ref_at[1]:.2f}"
        elif pname == "Value":
            prop[2] = sexp.q(value)
        if sexp.find(prop, "uuid") is None:
            prop.append(["uuid", uid()])

    # nets + etch-friendly pad sizes, capped by the footprint's own pitch
    if lib == LIB_RES:
        grow = PAD_RES
    elif lib == LIB_TERM:
        grow = PAD_P508
    else:
        grow = PAD_P254

    for pad in sexp.find_all(fp, "pad"):
        num = sexp.unq(pad[1])
        if pad[2] != "np_thru_hole":
            size = sexp.find(pad, "size")
            if size is not None:
                # oblong pads stay oblong -- only grow an axis, never shrink
                w, h = float(size[1]), float(size[2])
                size[1] = f"{max(w, grow):.4f}"
                size[2] = f"{max(h, grow):.4f}"
            net = netmap.get(int(num)) if num.isdigit() else None
            if net:
                pad.append(["net", str(NET_ID[net]), sexp.q(net)])
        if sexp.find(pad, "uuid") is None:
            pad.append(["uuid", uid()])

    return fp


def pad_grow(lib):
    if lib == LIB_RES:
        return PAD_RES
    if lib == LIB_TERM:
        return PAD_P508
    return PAD_P254


def pad_positions(spec):
    """Absolute pad centres in design coordinates, matching what place() emits.

    KiCad rotates a footprint counter-clockwise with Y running down, so a pad
    at local (lx, ly) lands at (px + lx.cos + ly.sin, py - lx.sin + ly.cos).
    """
    lib, name, dx, dy, rot, _value, netmap = spec
    fp = load_fp(lib, name)
    grow = pad_grow(lib)
    th = math.radians(rot)
    cos_t, sin_t = math.cos(th), math.sin(th)

    out = []
    for pad in sexp.find_all(fp, "pad"):
        if pad[2] == "np_thru_hole":
            continue
        num = sexp.unq(pad[1])
        at = sexp.find(pad, "at")
        lx, ly = float(at[1]), float(at[2])
        size = sexp.find(pad, "size")
        w = max(float(size[1]), grow)
        h = max(float(size[2]), grow)
        net = netmap.get(int(num)) if num.isdigit() else None
        out.append({
            "num": num,
            "x": dx + lx * cos_t + ly * sin_t,
            "y": dy - lx * sin_t + ly * cos_t,
            "half": max(w, h) / 2.0,
            "net": net,
        })
    return out


def seg(x1, y1, x2, y2, net, width, layer="F.Cu"):
    return [
        "segment",
        ["start", f"{OX + x1:.4f}", f"{OY + y1:.4f}"],
        ["end", f"{OX + x2:.4f}", f"{OY + y2:.4f}"],
        ["width", f"{width}"],
        ["layer", sexp.q(layer)],
        ["net", str(NET_ID[net])],
        ["uuid", uid()],
    ]


def edge(x1, y1, x2, y2):
    return [
        "gr_line",
        ["start", f"{OX + x1:.4f}", f"{OY + y1:.4f}"],
        ["end", f"{OX + x2:.4f}", f"{OY + y2:.4f}"],
        ["stroke", ["width", "0.1"], ["type", "default"]],
        ["layer", sexp.q("Edge.Cuts")],
        ["uuid", uid()],
    ]


def sline(x1, y1, x2, y2):
    return [
        "gr_line",
        ["start", f"{OX + x1:.4f}", f"{OY + y1:.4f}"],
        ["end", f"{OX + x2:.4f}", f"{OY + y2:.4f}"],
        ["stroke", ["width", "0.15"], ["type", "default"]],
        ["layer", sexp.q("F.SilkS")],
        ["uuid", uid()],
    ]


def uline(x1, y1, x2, y2, w=0.2, layer="User.Drawings"):
    return [
        "gr_line",
        ["start", f"{OX + x1:.4f}", f"{OY + y1:.4f}"],
        ["end", f"{OX + x2:.4f}", f"{OY + y2:.4f}"],
        ["stroke", ["width", f"{w}"], ["type", "default"]],
        ["layer", sexp.q(layer)],
        ["uuid", uid()],
    ]


def text(s, x, y, size=1.5, rot=0, layer="F.SilkS"):
    thick = min(0.25, size * 0.18)
    return [
        "gr_text", sexp.q(s),
        ["at", f"{OX + x:.4f}", f"{OY + y:.4f}"] + ([f"{rot}"] if rot else []),
        ["layer", sexp.q(layer)],
        ["uuid", uid()],
        ["effects", ["font", ["size", f"{size}", f"{size}"], ["thickness", f"{thick:.2f}"]]],
    ]


# Every connector pin named on the silkscreen, using the NAME PRINTED ON THE
# MODULE it wires to -- so Francis confirms board-against-part, not
# board-against-my-notes. (label, x, y, rot)
PIN_SILK = [
    # J1 12V in (below pads) -- +12V first, matching PSU convention
    ("+12V", 14, 19.6, 0), ("GND", 19.08, 19.6, 0),
    # U1 buck terminal (below pads)
    ("IN+", 33, 20.9, 0), ("IN-", 38.08, 20.9, 0),
    ("OUT+", 43.16, 20.9, 0), ("OUT-", 48.24, 20.9, 0),
    # U2 charger terminal (below pads) -- OUT pads, NOT B+/B- (protection!)
    ("IN+", 58, 20.9, 0), ("IN-", 63.08, 20.9, 0),
    ("OUT+", 68.16, 20.9, 0), ("OUT-", 73.24, 20.9, 0),
    # J13 boost terminal, vertical: labels right of each pad, clear of the
    # body silk (which reaches x=18.85 after the 270 rotation)
    ("IN+", 20.4, 24, 0), ("IN-", 20.4, 29.08, 0),
    ("OUT+", 20.8, 34.16, 0), ("OUT-", 20.8, 39.24, 0),
    # ESP32 orientation -- match these four corners to the devkit silkscreen.
    # 38-pin DevKitC: 3V3 top-left, 5V bottom-left, GND top-right, CLK
    # bottom-right (sockets anchor at (32,28); 19 pins end at y=73.72)
    ("3V3", 41.2, 34, 0), ("5V", 41.4, 79.72, 0),
    ("GND", 72.6, 34, 0), ("CLK", 72.6, 79.72, 0),
    ("ANTENNA SIDE", 56.7, 36.5, 0), ("USB SIDE", 56.7, 75.5, 0),
    # J4 TFT (right of pads; names = blue ST7735S silkscreen)
    ("GND", 100.6, 12, 0), ("VDD", 100.6, 14.54, 0), ("SCL", 100.6, 17.08, 0),
    ("SDA", 100.6, 19.62, 0), ("RST", 100.6, 22.16, 0), ("DC", 100.5, 24.70, 0),
    ("CS", 100.5, 27.24, 0), ("BLK", 100.6, 29.78, 0),
    # J5 RC522
    ("SDA", 100.6, 36, 0), ("SCK", 100.6, 38.54, 0), ("MOSI", 100.9, 41.08, 0),
    ("MISO", 100.9, 43.62, 0), ("IRQ", 100.6, 46.16, 0), ("GND", 100.6, 48.70, 0),
    ("RST", 100.6, 51.24, 0), ("3.3V", 100.9, 53.78, 0),
    # U4 GY-521 MPU-6050
    ("VCC", 100.6, 60, 0), ("GND", 100.6, 62.54, 0), ("SCL", 100.6, 65.08, 0),
    ("SDA", 100.6, 67.62, 0), ("XDA", 100.6, 70.16, 0), ("XCL", 100.6, 72.70, 0),
    ("AD0", 100.6, 75.24, 0), ("INT", 100.6, 77.78, 0),
    # bottom row terminals: body silk climbs to y=81.15 (measured from the
    # footprint), so labels sit at 80.3
    ("REED", 13, 95.3, 0), ("GND", 18.08, 95.3, 0),
    ("GND", 36, 95.3, 0), ("LED+", 41.08, 95.3, 0),
    ("GND", 68, 95.3, 0), ("LED+", 73.08, 95.3, 0),
    ("+5V", 80, 95.3, 0), ("HORN-", 85.08, 95.3, 0),
    # function headings for the ref-hidden buzzer/relay headers (now up
    # beside R8 and R7, out of the USB cable path)
    ("BUZZ", 27.54, 83.4, 0), ("RELAY", 80.54, 83.4, 0),
    # J14 expansion: odd pins label to the left, even pins to the right
    ("3V3", 26.4, 40, 0), ("5V", 36.0, 40, 0),
    ("GND", 26.4, 42.54, 0), ("GND", 36.4, 42.54, 0),
    ("D36", 26.4, 45.08, 0), ("D39", 36.4, 45.08, 0),
    ("D14", 26.4, 47.62, 0), ("D12", 36.4, 47.62, 0),
    ("EN", 26.2, 50.16, 0), ("GND", 36.4, 50.16, 0),
    ("EXPANSION", 31.3, 36.6, 0),
    # buzzer/relay headers, vertical labels (2.54 pitch too tight horizontal)
    ("5V", 25, 86.8, 90), ("GND", 27.54, 86.4, 90), ("SIG", 30.08, 86.6, 90),
    # Francis's relay (Tongling JQC-3FF-S-Z) prints S + - , not IN GND VCC.
    # The silk exists to be held next to the module and matched word for word,
    # so it follows the module in hand rather than the generic naming.
    ("S", 78, 86.8, 90), ("-", 80.54, 86.4, 90), ("+", 83.08, 86.6, 90),
]


# Routed power is kept modest: these rails carry a relay coil and a buzzer,
# not the horn, so 0.8 mm is ample and leaves lanes for the signals.
NET_WIDTH = {
    "GND": 1.2, "+5V": 0.8, "+5V_BAT": 0.8, "+5V_SYS": 0.8, "+3V3": 0.8,
    "+12V": 1.2, "+12V_IN": 1.2, "VBAT": 0.8,
}
W_SIGNAL = 0.6


def _key(x, y):
    return (round(x * 100), round(y * 100))


def _on_segment(px, py, x1, y1, x2, y2, tol=0.15):
    return router.Router._seg_dist(px, py, x1, y1, x2, y2) <= tol


def auto_route(tracks, strategy, priority=frozenset()):
    """Route every net that is not already connected.

    Two etched layers: F.Cu is tried first, and anything that cannot get
    through falls to B.Cu. Both are real copper and obstruct each other.
    All pads are through-hole, so a connection can live entirely on either
    layer and no vias are needed.
    """
    # Every pad is an obstacle, including the ESP32 pins we do not use --
    # an unconnected pin is still copper and a track across it is a short.
    all_pads = []
    for ref in sorted(PARTS):
        for p in pad_positions(PARTS[ref]):
            p["ref"] = ref
            all_pads.append(p)
    pads = [p for p in all_pads if p["net"]]

    rt = router.Router(BW, BH)
    for p in all_pads:
        rt.add_pad(p["x"], p["y"], p["half"], p["net"])
    for t in tracks:
        rt.add_track(t["x1"], t["y1"], t["x2"], t["y2"], t["w"], t["net"],
                     t["layer"])

    # ---- union-find seeded with what the base copper already joins ----
    parent = {}

    def find(k):
        parent.setdefault(k, k)
        while parent[k] != k:
            parent[k] = parent[parent[k]]
            k = parent[k]
        return k

    def union(a, b):
        ra, rb = find(a), find(b)
        if ra != rb:
            parent[ra] = rb

    def seed():
        parent.clear()
        for t in tracks:
            union(_key(t["x1"], t["y1"]), _key(t["x2"], t["y2"]))
        # a stub landing mid-ring shares copper with it
        for t in tracks:
            for px, py in ((t["x1"], t["y1"]), (t["x2"], t["y2"])):
                for u in tracks:
                    if u is t or u["net"] != t["net"]:
                        continue
                    if _on_segment(px, py, u["x1"], u["y1"], u["x2"], u["y2"]):
                        union(_key(px, py), _key(u["x1"], u["y1"]))
        for p in pads:
            for t in tracks:
                if t["net"] != p["net"]:
                    continue
                if _on_segment(p["x"], p["y"], t["x1"], t["y1"], t["x2"], t["y2"]):
                    union(_key(p["x"], p["y"]), _key(t["x1"], t["y1"]))

    by_net = {}
    for p in pads:
        by_net.setdefault(p["net"], []).append(p)

    edges = []
    for net, group in by_net.items():
        if len(group) < 2:
            continue
        pts = [(p["x"], p["y"]) for p in group]
        for i, j in router.mst_edges(pts):
            span = abs(pts[i][0] - pts[j][0]) + abs(pts[i][1] - pts[j][1])
            edges.append((span, net, group[i], group[j]))

    # Routing order changes the result a lot and no heuristic wins every time,
    # so build() tries each and keeps whichever needs the fewest links.
    if strategy == "short":
        edges.sort(key=lambda e: e[0])
    elif strategy == "long":
        edges.sort(key=lambda e: -e[0])
    else:  # power rails first, then shortest
        edges.sort(key=lambda e: (e[1] not in NET_WIDTH, e[0]))
    # nets that failed a previous round jump the queue before congestion forms
    if priority:
        edges.sort(key=lambda e: e[1] not in priority)

    vias = []
    failed = []
    for _span, net, pa, pb in edges:
        seed()
        a = (pa["x"], pa["y"])
        b = (pb["x"], pb["y"])
        if find(_key(*a)) == find(_key(*b)):
            continue

        width = NET_WIDTH.get(net, W_SIGNAL)
        path = rt.route(net, a, b, width / 2.0)
        if path is None:
            failed.append((net, pa["ref"], pb["ref"]))
            continue

        for k in range(len(path) - 1):
            x1, y1, l1 = path[k]
            x2, y2, l2 = path[k + 1]
            if l1 != l2:
                # the path stays put and changes layer: that is a via
                vias.append({"x": x1, "y": y1, "net": net})
                rt.add_pad(x1, y1, router.VIA_D / 2.0, net)
                continue
            tracks.append({"x1": x1, "y1": y1, "x2": x2, "y2": y2,
                           "w": width, "net": net, "layer": l1})
            rt.add_track(x1, y1, x2, y2, width, net, l1)

    return vias, failed


def write_project():
    """Project file carrying the home-etching design rules, so DRC checks
    against 0.6 mm rather than KiCad's 0.2 mm fab defaults."""
    pro = {
        "board": {
            "design_settings": {
                "rules": {
                    "min_clearance": CLEARANCE,
                    "min_track_width": TRACK_MIN,
                    # 0.3 mm drill / 0.25 mm hole-to-hole sits inside every
                    # fab's cheap tier; the old 0.8 was a hand-drilling limit.
                    "min_through_hole_diameter": 0.3,
                    "min_hole_to_hole": 0.25,
                    "min_copper_edge_clearance": 0.5,
                    "min_text_height": 0.8,
                    "min_text_thickness": 0.08,
                },
                "track_widths": [0.0, TRACK_MIN, W_PWR, W_GND, W_HV],
            },
        },
        "net_settings": {
            "classes": [{
                "name": "Default",
                "clearance": CLEARANCE,
                "track_width": TRACK_MIN,
                "via_diameter": 0.8,
                "via_drill": 0.4,
                "priority": 2147483647,
            }],
        },
        "meta": {"filename": "freeisp_brain.kicad_pro", "version": 3},
    }
    path = OUT.replace(".kicad_pcb", ".kicad_pro")
    with open(path, "w", encoding="utf-8") as fh:
        json.dump(pro, fh, indent=2)
    print(f"wrote {path}")

    # Both layers are etched now, so the wire-link exemption is gone.
    dru = OUT.replace(".kicad_pcb", ".kicad_dru")
    if os.path.exists(dru):
        os.remove(dru)


def build():
    pcb = [
        "kicad_pcb",
        ["version", "20241229"],
        ["generator", sexp.q("freeisp-build.py")],
        ["generator_version", sexp.q("9.0")],
        ["general", ["thickness", "1.6"], ["legacy_teardrops", "no"]],
        ["paper", sexp.q("A4")],
        ["layers",
         ["0", sexp.q("F.Cu"), "signal"],
         ["2", sexp.q("B.Cu"), "signal"],
         ["5", sexp.q("F.SilkS"), "user", sexp.q("F.Silkscreen")],
         ["7", sexp.q("B.SilkS"), "user", sexp.q("B.Silkscreen")],
         ["1", sexp.q("F.Mask"), "user"],
         ["3", sexp.q("B.Mask"), "user"],
         ["9", sexp.q("F.Adhes"), "user", sexp.q("F.Adhesive")],
         ["11", sexp.q("B.Adhes"), "user", sexp.q("B.Adhesive")],
         ["13", sexp.q("F.Paste"), "user"],
         ["15", sexp.q("B.Paste"), "user"],
         ["17", sexp.q("Dwgs.User"), "user", sexp.q("User.Drawings")],
         ["45", sexp.q("User.1"), "user"],
         ["19", sexp.q("Cmts.User"), "user", sexp.q("User.Comments")],
         ["21", sexp.q("Eco1.User"), "user", sexp.q("User.Eco1")],
         ["23", sexp.q("Eco2.User"), "user", sexp.q("User.Eco2")],
         ["25", sexp.q("Edge.Cuts"), "user"],
         ["27", sexp.q("Margin"), "user"],
         ["31", sexp.q("F.CrtYd"), "user", sexp.q("F.Courtyard")],
         ["29", sexp.q("B.CrtYd"), "user", sexp.q("B.Courtyard")],
         ["35", sexp.q("F.Fab"), "user"],
         ["33", sexp.q("B.Fab"), "user"],
         ],
        ["setup",
         ["pad_to_mask_clearance", "0.05"],
         ["allow_soldermask_bridges_in_footprints", "no"],
         ],
    ]

    for i, name in enumerate(NETS):
        pcb.append(["net", str(i), sexp.q(name)])

    for ref in sorted(PARTS):
        pcb.append(place(ref, PARTS[ref]))

    # board outline
    lo, hi = 0.0, BW
    pcb += [edge(lo, lo, hi, lo), edge(hi, lo, hi, hi),
            edge(hi, hi, lo, hi), edge(lo, hi, lo, lo)]

    # ---- base copper: laid out by hand, then handed to the router as fixed ----
    tracks = []

    def base(x1, y1, x2, y2, net, width):
        tracks.append({"x1": x1, "y1": y1, "x2": x2, "y2": y2,
                       "w": width, "net": net, "layer": "F.Cu"})

    a, b = RING, BW - RING
    for s in [(a, a, b, a), (b, a, b, b), (b, b, a, b), (a, b, a, a)]:
        base(*s, "GND", W_GND)

    # ground stubs: top row up, bottom row down, right headers across
    for x in (19.08, 38.08, 48.24, 63.08, 73.24):
        base(x, 15, x, a, "GND", W_STUB)
    for x in (18.08, 36, 68, 85.08):
        base(x, 101, x, b, "GND", W_STUB)
    for y in (12, 48.70, 62.54):        # J4 pin1, J5 pin6, U4 pin2
        base(97, y, b, y, "GND", W_STUB)
    for y in (29.08, 39.24):            # J13 boost IN-/OUT- to the left ring
        base(14, y, a, y, "GND", W_STUB)
    # (the old J1->buck 12V hop is gone: the feed now goes through D3)

    base_tracks = list(tracks)
    n_base = len(tracks)

    best = None
    for strategy in ("power", "short", "long"):
        pri = frozenset()
        for attempt in range(7):
            trial = [dict(t) for t in base_tracks]
            vias, failed = auto_route(trial, strategy, pri)
            score = len(failed) * 1000 + len(vias)
            print(f"  strategy {strategy:<6} try {attempt + 1} -> "
                  f"{len(vias)} vias, {len(failed)} unrouted")
            if best is None or score < best[0]:
                best = (score, trial, vias, failed, strategy)
            if not failed:
                break
            new_pri = pri | {net for net, _a, _b in failed}
            if new_pri == pri:
                break
            pri = new_pri
        if best[3] == []:
            break

    _, tracks, vias, failed, strategy = best
    print(f"  using '{strategy}'")

    for t in tracks:
        pcb.append(seg(t["x1"], t["y1"], t["x2"], t["y2"],
                       t["net"], t["w"], t["layer"]))
    for v in vias:
        pcb.append([
            "via",
            ["at", f"{OX + v['x']:.4f}", f"{OY + v['y']:.4f}"],
            ["size", f"{router.VIA_D}"],
            ["drill", f"{router.VIA_DRILL}"],
            ["layers", sexp.q("F.Cu"), sexp.q("B.Cu")],
            ["net", str(NET_ID[v["net"]])],
            ["uuid", uid()],
        ])

    # ---- silkscreen ----
    # Kept clear of the part silk: the ring gap at the bottom is the only
    # open strip wide enough for text.
    pcb.append(text("FREEISP BRAIN  REV H - 115MM - 38-PIN DEVKITC", 57.5, 109, 1.8))
    # The two set-points ARE the diode-OR priority mechanism: buck 0.4V above
    # boost means D1 always wins on mains and D2 is cleanly reverse-biased.
    # Printed on the board so the values cannot get lost in a document.
    pcb.append(text("FUSE 12V INLINE - SET BUCK 5.4V - BOOST 5.0V", 57.5, 6.5, 1.1))
    for s, lx, ly, rot in PIN_SILK:
        pcb.append(text(s, lx, ly, 0.8, rot))

    # ---- PRINT CALIBRATION, on User.Drawings so it is never fabricated ----
    # A scaled print puts the first few pins in their holes and then drifts:
    # 1% over the 45.72mm pin row is 0.46mm, which misses by pin 19.
    U = "Dwgs.User"
    RY = 124.0
    pcb.append(uline(7.5, RY, 107.5, RY, 0.35, U))
    for i in range(11):
        x = 7.5 + i * 10
        h = 3.2 if i % 5 == 0 else 1.8
        pcb.append(uline(x, RY, x, RY - h, 0.3, U))
        if i % 5 == 0:
            pcb.append(text(f"{i * 10}", x, RY - h - 2.4, 2.2, 0, U))
    pcb.append(text("100.00 mm  -  MEASURE THIS LINE FIRST", 57.5, RY + 5.0, 2.6, 0, U))
    pcb.append(text("not exactly 100 mm? the printer scaled the page - reprint at "
                    "100% / Actual Size, scaling OFF", 57.5, RY + 9.4, 1.9, 0, U))

    # the two dimensions the ESP32 actually depends on
    pcb.append(uline(26, 34, 26, 79.72, 0.3, U))
    for yy in (34, 79.72):
        pcb.append(uline(24.6, yy, 27.4, yy, 0.3, U))
    pcb.append(text("45.72 mm  pin 1 to pin 19", 23.4, 56.9, 2.0, 90, U))
    pcb.append(uline(44, 24.5, 69.4, 24.5, 0.3, U))
    for xx in (44, 69.4):
        pcb.append(uline(xx, 23.1, xx, 25.9, 0.3, U))
    pcb.append(text("25.40 mm  row to row", 56.7, 22.2, 2.0, 0, U))

    # ---- devkit BODY outline: the board is bigger than its pins. Overhangs
    # are estimates off the paper-test photo (antenna ~7mm, USB end ~12mm
    # incl. the Type-C) -- VERIFY on the printed sheet. Nothing taller than
    # the 8.5mm socket seat may live inside this rectangle.
    bx0, bx1 = 42.5, 70.9
    by0, by1 = 34 - 6.0, 79.72 + 12.0
    for s in [(bx0, by0, bx1, by0), (bx1, by0, bx1, by1),
              (bx1, by1, bx0, by1), (bx0, by1, bx0, by0)]:
        pcb.append(sline(*s))
    pcb.append(text("ESP32 BODY - KEEP EMPTY", 56.7, 89.5, 0.8))

    with open(OUT, "w", encoding="utf-8") as fh:
        fh.write(sexp.dumps(pcb) + "\n")

    print(f"wrote {OUT}")
    print(f"  {len(PARTS)} footprints, {len(NETS) - 1} nets")
    print(f"  {n_base} base segments, {len(tracks) - n_base} routed segments")
    print(f"  {len(vias)} vias")
    if failed:
        print(f"  !! {len(failed)} UNROUTED:")
        for net, ra, rb in failed:
            print(f"      {net:<12} {ra} -> {rb}")
    write_project()


if __name__ == "__main__":
    build()
