ispbillingai/freeispserverbox/firmware/ReedTest/ReedTest.ino

/*
  ReedTest.ino — prove the door sensor, and work out which kind it is.

  Reed switches come both ways round: most close their contacts when the
  magnet comes near (normally-open), but some open them instead. Get it
  backwards and the box thinks the door is hanging open while it is shut.
  Rather than guess, this WATCHES the pin and you tell it once which
  state is "door closed". It then prints the exact config line to use.

  Buzzer + MPU can stay wired, they are ignored here. No screen, no WiFi.

  ------------------------------------------------------------------
  WIRING
  ------------------------------------------------------------------
  BARE GLASS REED (two wires, no PCB) - the usual kind:
      one leg -> GPIO 32
      other leg -> GND
      No resistor. The ESP32's internal pull-up does the work.

  3-PIN REED MODULE (small PCB with an LED on it):
      VCC -> 3V3      GND -> GND      DO (or OUT) -> GPIO 32

  NO REED YET? A plain jumper wire works as a fake door:
      wire in = door CLOSED, pull it out = door OPEN.

  BUZZER (optional, for feedback without a screen):
      I/O -> GPIO 27,  VCC -> 5V,  GND -> GND
  ------------------------------------------------------------------

  HOW TO USE IT
  1. Upload, open Serial Monitor @115200.
  2. It prints the live pin state as you move the magnet. Watch it flip.
  3. Hold the magnet where it will sit when the DOOR IS SHUT, then type
     'c' + Enter. That is the calibration - it now knows which way round
     your sensor is, and prints the line for the real firmware.
  4. After that: take the magnet away and it rings IMMEDIATELY and
     CONTINUOUSLY - no grace, no gaps - until the magnet comes back.

  THE SOUND: the two notes alternate with NO silence between them, so it
  is one unbroken wail rather than beep-beep-beep. Want a single flat
  tone instead? Set SOLID_TONE to 1 below.

  NOTE: the real firmware still gives you a 15s grace chirp before it
  screams (GRACE_MS in LiveDashboardNext), so you can open the box
  yourself without waking the street. This bench sketch is deliberately
  instant so you do not have to wait around to hear it.
*/

#define PIN_REED  32
#define PIN_BUZZ  27

const uint32_t DEBOUNCE_MS = 60;

// 0 = alternating two-note wail (louder to the ear, harder to ignore)
// 1 = one flat unbroken tone at TONE_B_HZ
#define SOLID_TONE 0

const uint32_t SWAP_MS   = 300;     // how fast the two notes alternate
const uint16_t TONE_A_HZ = 2000;
const uint16_t TONE_B_HZ = 4250;    // this buzzer's loudest note

// Pre-set for a normally-open reed (the bare glass kind): magnet near
// closes the contacts, which the internal pull-up shows as LOW. That is
// the FreeISP case - lid on = magnet near = LOW = closed. No calibration
// needed. Press 'c' only if you ever fit a reed that works the other way.
int      closedLevel = LOW;
int      lastRaw     = -1;
int      stableRaw   = -1;
uint32_t changedAt   = 0;
bool     doorOpen    = false;
bool     seenLow = false, seenHigh = false;

uint32_t swapAt = 0;
bool     sirenAlt = false;

void quiet() {
  noTone(PIN_BUZZ);
  pinMode(PIN_BUZZ, OUTPUT);
  digitalWrite(PIN_BUZZ, LOW);
}

// start ringing NOW and never stop until quiet() is called
void ringOn() {
#if SOLID_TONE
  tone(PIN_BUZZ, TONE_B_HZ);        // one flat unbroken note
#else
  sirenAlt = !sirenAlt;
  tone(PIN_BUZZ, sirenAlt ? TONE_A_HZ : TONE_B_HZ);
#endif
  swapAt = millis();
}

void chirp(uint16_t hz, uint16_t ms) {
  tone(PIN_BUZZ, hz);
  delay(ms);
  quiet();
}

void showCalibration() {
  Serial.println();
  Serial.println("**********************************************");
  Serial.printf ("  CALIBRATED: door CLOSED = pin reads %s\n",
                 closedLevel == LOW ? "LOW" : "HIGH");
  Serial.println();
  Serial.println("  Put this in LiveDashboardNext.ino:");
  Serial.printf ("     #define REED_CLOSED_LEVEL  %s\n",
                 closedLevel == LOW ? "LOW" : "HIGH");
  if (closedLevel == LOW)
    Serial.println("  (that is already the default - nothing to change)");
  else
    Serial.println("  (the default is LOW, so this one DOES need changing)");
  Serial.println("**********************************************");
  Serial.println();
  Serial.println("Now take the magnet away to trigger the alarm.");
  Serial.println();
}

void setup() {
  Serial.begin(115200);
  delay(300);
  Serial.println();
  Serial.println("==========================================");
  Serial.println(" ReedTest - which way round is your reed?");
  Serial.printf ("  reed on GPIO %d, buzzer on GPIO %d\n", PIN_REED, PIN_BUZZ);
  Serial.println("==========================================");
  Serial.println();
  Serial.println("Assuming: magnet NEAR (lid ON)  = pin LOW  = CLOSED");
  Serial.println("          magnet GONE (lid OFF) = pin HIGH = OPEN -> RINGS");
  Serial.println("Take the magnet away and it should ring straight away.");
  Serial.println("('c' + Enter re-calibrates, only needed for an odd reed)");
  Serial.println();

  pinMode(PIN_BUZZ, OUTPUT);
  quiet();
  pinMode(PIN_REED, INPUT_PULLUP);

  lastRaw = stableRaw = digitalRead(PIN_REED);
  changedAt = millis();
  doorOpen = (stableRaw != closedLevel);
  Serial.printf("start: pin reads %s -> lid is %s\n",
                stableRaw == LOW ? "LOW" : "HIGH",
                doorOpen ? "OFF (ringing)" : "ON (quiet)");
  if (doorOpen) ringOn();          // boots straight into the alarm if open
}

void loop() {
  uint32_t now = millis();

  // ---- calibrate on demand ----
  if (Serial.available()) {
    char c = Serial.read();
    if (c == 'c' || c == 'C') {
      closedLevel = stableRaw;
      doorOpen = false;
      quiet();
      showCalibration();
      chirp(TONE_B_HZ, 120);
    }
  }

  // ---- debounce the pin ----
  int raw = digitalRead(PIN_REED);
  if (raw != lastRaw) {
    lastRaw = raw;
    changedAt = now;
  } else if (now - changedAt > DEBOUNCE_MS && raw != stableRaw) {
    stableRaw = raw;
    if (raw == LOW) seenLow = true; else seenHigh = true;

    Serial.printf("[%6lus] pin -> %s\n", now / 1000, raw == LOW ? "LOW " : "HIGH");

    bool nowOpen = (raw != closedLevel);
    if (nowOpen != doorOpen) {
      doorOpen = nowOpen;
      if (doorOpen) {
        ringOn();                       // instant, no grace
        Serial.println("   !! LID OFF - RINGING (will not stop until it is back)");
      } else {
        quiet();
        Serial.println("   OK LID ON - quiet, box secure");
      }
    }
  }

  if (closedLevel < 0 || !doorOpen) return;

  // ---- keep it ringing. The sound NEVER stops while the door is open:
  // we only swap which note is playing, we never go silent between them.
#if !SOLID_TONE
  if (now - swapAt >= SWAP_MS) {
    swapAt = now;
    sirenAlt = !sirenAlt;
    tone(PIN_BUZZ, sirenAlt ? TONE_A_HZ : TONE_B_HZ);
  }
#endif
}
