ispbillingai/freeispserverbox/(commit log)

2026-07-08 Initial commit: FreeISP box CAD scripts, firmware, and BenchAlarm step 1
    - fusion/: all Fusion 360 enclosure scripts (shell v19, bottom lid, cover, checks)
    - firmware/: all bench bring-up sketches incl. working DemoDashboard
    - firmware/BenchAlarm: NEW step-1 build sketch = screen + reed switch + LEDs + buzzer
    - Test Prints/, measurements, project plan
    [Module base.f3d, Module base.stl, Overhang.stl, box.stl, finaldownplate.stl, finalfir_modulegadget.stl, fir_module_base.stl, fir_module_lid.stl]
2026-07-08 Add LiveDashboard: WiFi + real MikroTik REST data on screen, no new wiring
    - STATUS page: WiFi state/IP/RSSI + router link health + plain-English errors
    - PORTS page: real ether1-5 up/down + live rx/tx Mbps from RouterOS v7 REST
    - TRAFFIC page: scrolling DL/UL graph of ether1
    - secrets.example.h template (real secrets.h is gitignored)
    - WIFI_PS_NONE fix for MikroTik AP doze-drop; WiFi self-heal reconnect
    [LiveDashboard.ino, secrets.example.h]
2026-07-08 LiveDashboard: scan and list all visible WiFi networks before connecting
    Diagnoses the no-attempt-in-router-log failure: prints every SSID with
    channel, signal and security type, and flags the target if missing.
    [HelloScreen.ino, LiveDashboard.ino]
2026-07-08 LiveDashboard: support open networks + allow WPA1 APs
    Scan revealed the router broadcasts WPA1-only, which core 3.x refuses
    by default (setMinSecurity fix). Empty WIFI_PASS now joins as open.
    [HelloScreen.ino, LiveDashboard.ino]
2026-07-08 LiveDashboard: REST poll via GET + timeouts + reply-peek diagnostics
    Read timeouts on /rest with the hotspot active: switch POST print to
    documented GET with proplist, 3s connect / 8s read timeout, and log
    elapsed ms plus the first 120 chars of any non-200 reply (a hotspot
    login page becomes visible instead of a silent timeout).
2026-07-08 LiveDashboard: log ESP32 MAC on connect (for hotspot bypass binding)
    [HelloScreen.ino, LiveDashboard.ino]
2026-07-08 LiveDashboard: MT_HOST auto mode - poll the WiFi gateway router
    ESP32 got 192.168.89.x from its AP while polling hard-coded
    192.168.88.1 on another subnet. auto resolves to WiFi.gatewayIP()
    so the box always talks to the router it is actually connected to.
    Logs now name the polled host.
    [LiveDashboard.ino, secrets.example.h]
2026-07-08 LiveDashboard v2: full live dashboard - users, ports, traffic, system
    - HOME: hotspot active-users count (big), router UP/DOWN, RouterOS uptime
    - PORTS: real ether1-5 up/down + live Mbps (unchanged)
    - TRAFFIC: scrolling DL/UL graph, 160-pt history
    - SYSTEM: CPU bar, memory bar, board + version, box IP/RSSI
    - shared restGet() with timeouts, reply-peek logging, staggered polling
2026-07-08 LiveDashboard: auto-scaling graph Y-axis + separate hotspot/pppoe counts
    - TRAFFIC: left axis shows top/half/0 in Mbps; scale snaps to friendly
    steps (1/2/5/10/20/50/100...) and grows/shrinks with on-screen peak
    - HOME: two big counters - HOTSPOT (cyan) and PPPOE (green) actives,
    from /rest/ip/hotspot/active and /rest/ppp/active
    [HelloScreen.ino, LiveDashboard.ino]
2026-07-08 LiveDashboard: remote screen on/off via router system note
    First remote command channel, zero server: box polls
    /rest/system/note every 3s; note "screen=off"/"screen=on" toggles
    panel sleep + backlight (TFT_BLK on GPIO 33 if BLK wire is moved).
    Data polling continues while dark.
2026-07-28 LiveDashboard v3: door alarm merged into the one main program
    - reed GPIO32, red LED 25, green LED 26, buzzer 27; boot self-test
    (both LEDs + chirp) verifies each newly wired part
    - local-first alarm: red ALARM banner + red LED + beeping siren the
    instant the door opens, before any network talk; overrides screen-off
    - new SECURITY page (door state, open count, siren)
    - door change fires an instant heartbeat; box.php fleet table gains
    door + opens columns (OPEN shown red)
    - alarm polling runs every loop pass, never blocked by REST calls
    [LiveDashboard.ino]
2026-07-28 ALARM_WIRED switch (default 0) + archive known-good v2
    Uploading v3 with no reed wired booted into the ALARM banner and
    looked like the dashboard broke. ALARM_WIRED=0 now compiles out all
    alarm hardware paths - identical behavior to the proven v2 - until
    the parts are physically wired. Known-good v2 archived under
    firmware/KnownGood/ for quick rollback.
2026-07-28 Alarm configuration block + graded alarm state machine (LiveDashboardNext only)
    The sacred LiveDashboard.ino is untouched (verified identical to
    firmware/KnownGood). All of this lands in LiveDashboardNext.ino and is
    still compiled out by default (ALARM_WIRED 0).
    One ALARM CONFIG block at the top now holds every alarm setting:
    ALARM_WIRED, ALARM_ARMED_AT_BOOT, REED_CLOSED_LEVEL,
    BUZZER_ACTIVE_HIGH, DEBOUNCE_MS, GRACE_MS, CHIRP_ON/GAP_MS,
    BEEP_MS, SIREN_MAX_MS, ALARM_BEAT_ON_CHANGE
    Behaviour that config now drives:
    - state machine SECURE / GRACE / SIREN / SILENT instead of one beep flag
    - 15s grace chirp before the full siren (time to close it or disarm)
    - siren auto-stops after 3 min;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
    [LiveDashboardNext.ino]
2026-07-28 BuzzTest: 20-line sketch to prove the buzzer and identify which type it is
    Francis has a 3-pin blue buzzer module and needs to hear it before the
    alarm goes any further. The full dashboard can't test it (ALARM_WIRED 0
    compiles the buzzer out, and flipping to 1 needs the reed wired first),
    so this is a standalone bench tool - no screen, no WiFi, no reed.
    Runs three tests in a loop on GPIO 27 and names each on serial:
    A - pin HIGH -> active buzzer, BUZZER_ACTIVE_HIGH 1
    B - pin LOW -> active-low module, BUZZER_ACTIVE_HIGH 0
    C - 2kHz tone -> passive buzzer, needs a tone not a level
    Whichever test makes noise tells us how to set the alarm config, in one
    bench round-trip instead of g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
    [BuzzTest.ino]
2026-07-28 Passive buzzer support: drive the alarm with tone(), two-note siren
    BuzzTest on the bench: tests A and B (steady HIGH / steady LOW) gave one
    click and then silence, test C (2kHz tone) sang. That is a PASSIVE buzzer
    - no oscillator inside, so a DC level only moves the disc once.
    - new BUZZER_PASSIVE flag (1 = tone(), 0 = level for active buzzers AND
    for the 12V horn on a relay later - a relay cannot take a tone)
    - buzz() is still the single place that knows how noise is made; the
    state machine never changed
    - being passive means we choose the pitch, so: grace chirps at 2500Hz,
    and the siren ALTERNATES 2000/3100Hz so it wails like an alarm instead
    of beeping like a microwave
    - noTone(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
    [LiveDashboardNext.ino]
2026-07-28 SirenTest: sweep to find the buzzer's resonant peak, then wail on it
    Francis asked for the loudest possible wail for testing. A passive piezo
    has a resonant frequency where it is far louder for the same voltage, and
    every buzzer's peak differs - so this sweeps 1000-5000Hz in 250Hz steps,
    holding and naming each note on serial, and his ears pick the winner.
    Part 2 then demos the finished alarm sound at the current presets: the
    two-tone yelp and a rising sweep siren.
    Once he reports the loudest frequency, TONE_SIREN_A_HZ / TONE_SIREN_B_HZ
    in LiveDashboardNext get set to it.
    Also documents the non-code volume wins: VCC on 5V instead of 3V3, get
    the buzzer out of the breadboard, and never cov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
    [SirenTest.ino]
2026-07-28 Siren tuned to the bench buzzer: wail 2000Hz / 4250Hz
    Bench sweep result: 4250Hz was clearly loudest = this buzzer's resonant
    peak. So the siren's high note sits on it and the low note stays 2000Hz -
    the gap between them is what makes it wail rather than beep. The grace
    chirp deliberately uses the quiet 2000Hz note; a warning should not be as
    violent as the alarm itself.
    Applied to both LiveDashboardNext (the real alarm) and SirenTest (so the
    demo now plays the final sound).
    Compile-verified.
    [LiveDashboardNext.ino, SirenTest.ino]
2026-07-28 Motion sensing: MPU-6050 "torn off the wall" -> instant siren
    Implements the plan Section 8 line "armed + torn off mount / violent
    motion -> SIREN instantly (skip grace)". Behind MOTION_WIRED 0, same
    wired-flag rule as the alarm, so his uploads cannot regress.
    No library. The MPU-6050 is talked to directly over I2C - all we need is
    which way is down and how hard it is being shaken, which is six bytes out
    of one register. Nothing for him to install, nothing to go stale.
    Two independent triggers, both skipping the grace period:
    - JOLT: |acceleration - 1.0g| > 0.35g = a real impact
    - TILT: hanging more than 25 deg off the baseline it learned at boot, and
    still there 1.5s later, so a knock o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
    [LiveDashboardNext.ino]
2026-07-28 MotionTest: MPU-6050 + buzzer on the bench, no screen or WiFi
    He has pulled the TFT off to work on just the buzzer and the motion
    sensor, so this is the isolated bench version - same sensor code, same
    0.35g / 25deg / 1.5s thresholds and the same 2000/4250Hz wail as
    LiveDashboardNext, but standalone.
    Prints g and tilt about 3x a second so the thresholds can be judged
    against real handling instead of guessed. Wails 4s on a trigger, says
    which trigger fired and the numbers that did it, then re-learns.
    'l' + Enter on the Serial Monitor re-learns the baseline, matching the
    motion=learn command in the real firmware.
    Also spells out in the no-sensor error that unsoldered header pins look
    exactly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
    [MotionTest.ino]
2026-07-29 Note for the final build: motion siren runs 2 min, stoppable online
    Francis's decisions, recorded in the alarm config block where whoever
    builds it will look:
    - a MOTION alarm gets its OWN timer and sounds 2 minutes continuously,
    separate from the door siren's 3 min. Being torn off the wall earns a
    longer alarm than a lid being lifted. Implementation named in the note
    (MOTION_SIREN_MS, used by pollBuzzer when alarmReason is MOTION).
    - it must be stoppable online. That half already works - siren=off from
    the server or the router note silences any alarm, motion included. The
    note records the real limit: server commands ride the heartbeat, so a
    remote stop lands within HEART_MS (20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
2026-07-29 ReedTest: prove the door sensor and detect which way round it is
    Last bench part before ALARM_WIRED 1. Reed switches come normally-open
    and normally-closed, and his may be a bare glass tube or a 3-pin module -
    whichever it is decides REED_CLOSED_LEVEL, and getting it backwards means
    the box reads a shut door as open and alarms at boot. That exact mistake
    already burned him once, so this measures instead of guessing.
    Watches the pin live; he holds the magnet where a SHUT door would hold it
    and types 'c'; it captures that level and prints the exact #define to use,
    saying whether it differs from the current default.
    After calibrating it behaves like the real door alarm - grace chirp then
    the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
    [ReedTest.ino]
2026-07-29 ReedTest: door open now rings instantly and continuously until shut
    Francis asked for it to ring continuously on open. Two changes:
    - no grace on the bench: the magnet leaving starts the siren immediately
    - the sound never breaks. The two notes alternate every 300ms but we only
    SWAP the tone, never go silent between them, so it is one unbroken wail
    instead of beep-silence-beep. SOLID_TONE 1 gives a single flat note at
    4250Hz instead, if he prefers that.
    It rings until the magnet comes back - no timeout on the bench, so he can
    hear exactly what it sounds like sustained.
    The real firmware keeps its 15s grace chirp on purpose so he can open his
    own box without waking the street; that s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
    [ReedTest.ino]
2026-07-29 ReedTest: no calibration step - it just works out of the box
    Francis's lid lifts off completely, so there is nothing to calibrate:
    magnet near = lid on, magnet gone = lid off. His reed is the bare glass
    normally-open type, so magnet-near reads LOW - which is already
    REED_CLOSED_LEVEL LOW in the firmware. Nothing to change there.
    But the sketch REFUSED to alarm until calibrated, so he could not hear
    it at all. That was my flaw, not his. Now:
    - closedLevel is pre-set to LOW for a normally-open reed
    - it works the moment it boots, no serial input needed
    - it also reads the lid state AT BOOT and starts ringing immediately if
    the lid is already off, instead of waiting for a transition
    - messa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
2026-07-29 CardTest: prove the RC522 and collect his card UIDs
    Next of the bought-but-unwired parts. Before any card-disarm logic can
    exist we need the actual UIDs of his cards and keyfobs, because the box
    will only obey numbers on its list - that IS the security.
    Reads any card presented and prints the UID in a paste-ready form, plus
    the card type. Ignores a card left sitting on the reader (2s repeat
    guard) so the log stays readable. Chirps the loud 4250Hz twice on a read
    so he gets feedback without a screen.
    Boot check reads VersionReg and explains that 0x00/0xFF means "no reply"
    - wiring or unsoldered header - rather than a dead chip, which is the
    mistake that cost two days on the TFT.
    Wiring sha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
    [CardTest.ino]
2026-07-29 CardTest: move RC522 to GPIO 16/17, away from the GPIO 12 trap
    He hit an endless "invalid header: 0xffffffff" boot loop right after
    wiring the RC522, and pushed back that the pins should not be the cause.
    He is right that 13/14 are electrically fine - no strapping function.
    But they neighbour GPIO 12, and GPIO 12 held HIGH at boot tells the ESP32
    its flash runs at 1.8V. The flash then stops answering and the bootloader
    loops on exactly that message. One jumper in the wrong row does it, and
    the failure appeared the moment a new module went onto those rows.
    Rather than argue the odds, moved SS to 16 and RST to 17 - nowhere near
    that cluster, so the mistake becomes impossible. Both are free o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
    [CardTest.ino]
2026-07-29 CardDisarm: reed + card + buzzer - lid off rings, card silences it
    Exactly the test he asked for, and the first time the anti-theft story
    works end to end: take the magnet away and it rings continuously, tap a
    card and it stops.
    The important part is that the card does NOT switch the alarm off
    forever - it buys a QUIET PERIOD. A technician gets time to work and the
    box re-arms itself with nobody having to remember. That is his 1-hour
    rule; the bench build uses 30s so the expiry can actually be watched, and
    if the lid is still off when it expires the siren comes back.
    Putting the lid back on ends the quiet period early - shutting the box
    means you are done.
    ACCEPT_ANY_CARD 1 for now since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
    [CardDisarm.ino]
2026-07-29 CardDisarm: max antenna gain + RF field watchdog
    Reader reports version 0x92 so SPI is perfect, but no card is ever seen.
    That combination points at the radio, not the wiring: clone RC522s
    frequently boot with receiver gain at minimum, so the chip answers us
    happily while its field is too weak to wake a card.
    - PCD_SetAntennaGain(RxGain_max) plus an antenna off/on kick at startup
    - every 3s, read TxControlReg and report whether the RF field is actually
    on, turning it back on if a flaky clone has dropped it
    The 3s line also gives him proof it is still polling, instead of silence
    that could mean anything.
    Compile-verified.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
    [CardDisarm.ino]
2026-07-29 CardDisarm: card reading works - record first UID, quieten the watchdog
    Antenna gain was the fix. Confirmed on the bench: reader was reporting
    version 0x92 the whole time while seeing no cards, because the clone
    booted with receiver gain at minimum. Lesson worth keeping: on these
    boards "reader alive" and "reader working" are different things, and the
    version register cannot tell them apart.
    - first real card recorded: 67 91 8F 63
    - the 3s reader chatter now only speaks up when the RF field has actually
    dropped, and re-asserts gain when it does. A log that talks constantly
    hides the lines that matter.
    Still ACCEPT_ANY_CARD 1 until he has tapped the rest of his cards.
    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
    [CardDisarm.ino]
2026-07-29 CardDisarm: recover from a card the reader cannot finish reading
    Francis found a real one: after presenting an unrelated card, his OWN
    card stopped working until reboot. On a deployed box that strands a
    technician at site with a screaming alarm and a card that does nothing.
    Cause: PICC_IsNewCardPresent() succeeds but PICC_ReadCardSerial() fails
    for a card of a different family (or one moved away mid-read), and the
    old code returned immediately - leaving the RC522 stuck mid-conversation
    so every subsequent card, including the right one, was ignored.
    Fix: always close the conversation on failure (PICC_HaltA +
    PCD_StopCrypto1), and after 3 consecutive failures do a full PCD_Init
    with gain and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
    [CardDisarm.ino]
2026-07-29 CardDisarm: add the white card to the list, label which UID is which
    Not a bug - the whitelist doing its job. 67 91 8F 63 is the blue KEYFOB
    (the one recorded earlier); F3 97 01 3A is the white CARD, which had
    never been listed, so it was correctly REJECTED while the siren kept
    going. It "worked the first time" only because ACCEPT_ANY_CARD was still
    1 back then.
    Both kit credentials are now listed and labelled, since a bare hex string
    tells nobody which physical thing it is - and that matters the day one
    needs revoking.
    Incidentally this also exercised the recovery fix: two rejected reads
    followed by a good one, with the reader still responding.
    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
    [CardDisarm.ino]
2026-07-29 CardDisarm: box learns its own 2 cards, stored in flash - one firmware for all
    The boxes are SOLD OVERSEAS and each ships with its own 2 cards. That
    kills the compiled-in list: customer A's card must never open customer
    B's box, and a firmware per box does not scale past a handful.
    So the cards move out of the program and into the ESP32's own NVS flash:
    - ONE binary flashes EVERY box. No per-box build, no config file.
    - A box with no cards stored boots into ENROL mode and pairs the first
    CARDS_PER_BOX (2) cards tapped, beeping to confirm each and playing a
    distinct two-note flourish when the box is paired and armed.
    - The pairing survives power cuts, reboots and firmware updates.
    - MAX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
    [CardDisarm.ino]
2026-07-29 Final-build note: customer can switch alarms off entirely from their account
    Francis's decision. Some sites do not want an alarm at all, so the account
    needs a real on/off per box, not just a silence-this-event button.
    alarm=disarm already does the job and persists as a state, so the work is
    server-side. Note records the two things that will bite if missed:
    1. the box must remember "disarmed" across a reboot (NVS) - otherwise a
    power cut silently re-arms a box the customer deliberately switched off
    2. the dashboard must show DISARMED loudly - a customer who forgets they
    turned it off will report the alarm as broken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
    [LiveDashboardNext.ino]
2026-07-29 Final-build note: the disarmed state must be visible, with time left and a count
    Francis: the screen should show the disarmed/quiet state and how many
    times it has happened when an event occurs.
    Recorded as: a card tap, an account switch or a remote siren=off must all
    be VISIBLE rather than silent -
    - SECURITY page shows DISARMED / QUIET with the remaining time counting
    down, so anyone looking knows it is off and for how much longer. A box
    that LOOKS armed but is not is the worst possible state.
    - a count of disarms sits next to the existing "times opened", so a box
    being silenced over and over is obvious at a glance
    - both ride the heartbeat, so the account shows the same thing and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
2026-07-29 Note: the card quiet period must silence MOTION too, not just the door
    Francis: the card should also disarm the MPU, because a tap means a
    technician is there.
    He is right and it would have been a real field bug. Someone who taps a
    card is about to handle the box - open it, move it, pull cables. A quiet
    period covering only the reed would let the motion sensor fire the moment
    they lean on it, and the card would look broken.
    Recorded alongside the planned CARD_QUIET_MS: while quiet runs, pollMotion
    must not raise an alarm either, and the tilt baseline should be re-learned
    when the quiet ENDS, since the box may legitimately be at a new angle by
    then. alarmArmed already suppresses both; the c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
    [LiveDashboardNext.ino]
2026-07-30 KiCad brain board: generated, placed, ground-routed, DRC clean
    Single-layer 100x100mm carrier for the ESP32 and everything in the module.
    build.py loads stock KiCad footprints from the installed library and embeds
    them with placement and net data, so pad geometry is KiCad's own rather than
    hand-rolled. It also writes the project file carrying the home-etching design
    rules, so DRC checks against 0.6mm instead of KiCad's 0.2mm fab defaults.
    Already done: placement, 27 nets, board outline, 4x M3 mounting holes, the
    perimeter ground ring, stubs to every ground pin, and the fused 12V hops.
    Left to do in KiCad: the 24 signal traces, plus the wire links they need.
    Verified with kicad-cli: 0 DRC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
    [freeisp_brain.kicad_pcb]
2026-07-30 Route the brain board: 0 DRC errors, 0 unconnected
    router.py is a grid maze router with real clearance inflation - every
    obstacle is grown by (my_half + clearance + their_half) and any cell whose
    centre falls inside is blocked, so KiCad's DRC agrees with it.
    It routes F.Cu first and falls back to a wire link where the single layer
    genuinely cannot get through. Three orderings are tried (power-first,
    shortest-first, longest-first) and whichever needs fewest links wins;
    shortest-first currently wins at 19 links and 190 etched segments.
    B.Cu is never etched - tracks there are insulated wires soldered across the
    component side. Because such wires cross freely, links are not obstacles to
    each o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
    [freeisp_brain.kicad_pcb]
2026-07-30 Ignore KiCad lock files
2026-07-30 Two layers: 0 errors, 0 unconnected, 17 vias, no wire links
    Francis chose two layers - same price at PCBWay and it removes the 19 hand
    soldered wires entirely. The router now searches (cell, layer, heading) with
    a via penalty, so a path can change layer mid-route instead of being stuck on
    one side. Through-hole pads already join the layers, so a path may start and
    end on either without a via.
    Real footprint errors found and fixed - DRC checks geometry, not whether a
    footprint matches a part, so all of these passed clean before:
    - J5 RC522 had 7 pins. The module has 8; IRQ is unused but still has a leg.
    - U4 MPU-6050 had 4 pins. The GY-521 has 8.
    - J4 TFT had VCC and GND swapped against the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
    [freeisp_brain.kicad_pcb]
2026-07-30 Backup power on the board: boost terminal + 1N5822 diode-OR, rev D
    Francis asked for the step-down, the step-up and the diodes that join them
    all accounted for on the board. Done:
    - J13 BOOST terminal (IN+ IN- OUT+ OUT-): battery -> 5V step-up module,
    bolted alongside like the buck and charger.
    - D1/D2 1N5822 Schottky diode-OR where the two 5V rails meet. Mains alive:
    buck wins through D1. Mains cut: boost takes over through D2. The
    changeover is physics, not code.
    - New 5V_SYS net after the diodes feeds ESP32 VIN, TFT, buzzer and horn
    relay - everything that must keep working when a thief cuts the power.
    - Charger IN+ deliberately stays on the buck rail: fed from 5V_SYS the
    batte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
    [freeisp_brain.kicad_pcb]
2026-07-30 Triple-verified sweep: audit.py + DRC + renders, every pin named on silk
    Francis asked for a full sweep with everything confirmed three times and
    every pin named so he can verify. Three independent checks, all passing:
    1. audit.py (NEW) - parses the board file KiCad reads, not the generator's
    own data, so a generator bug cannot hide itself. Checks every pair of
    different-net copper for crossings/clearance ("wires intermarrying") and
    that every net's pads form one connected island. CLEAN on both.
    2. kicad-cli DRC: 0 errors, 0 unconnected.
    3. Front + back renders inspected; pin map cross-checked against the bench-
    proven firmware defines (all 16 pins match LiveDashboardNext/CardDi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
    [freeisp_brain.kicad_pcb]
2026-07-30 Rev E: fix both critical review findings + all majors, re-verified clean
    Francis caught C1 himself and demanded an independent reviewer; the review
    (fresh-eyes agent, adversarial brief) confirmed it and found C2:
    C1 J12 "MAINS" was a bare field pin wired straight into GPIO34 (3.3V max,
    input-only, no clamp) - a factory-printed invitation to destroy the
    chip. FIXED: J12 deleted entirely. Mains presence is sensed on-board
    from the +12V rail through R5/R6 (100k/27k -> 2.55V) + C3 100n. No
    terminal above 3.3V can reach a GPIO any more.
    C2 J11's horn return (HORN_RET) was a single-pad net connected to NOTHING
    - the horn could never sound, and both my audit (skips <2-pad ne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
    [freeisp_brain.kicad_pcb]
2026-07-30 Horn moved to 5V_SYS: works on battery, can never see 12V
    Francis checked his actual horn: it is a 3-5V type, not the 12V unit in the
    old BOM. That resolves the reviewer's battery-mode concern the right way
    round - as built, J11 would have fed the 3-5V horn raw 12V and destroyed
    it on first trigger.
    J11 pin 1 is now +5V_SYS (silk "+5V"): the horn rides the diode-OR rail,
    so it keeps sounding on battery after a mains cut, and 12V can no longer
    reach it. The 12V net now feeds only the buck and the sense divider.
    PINOUT updated: explicit note that the PCB does not switch the horn (K1 is
    control pins only; the relay module's COM/NO screw terminals do the
    switching - Francis's reading, confirme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
    [freeisp_brain.kicad_pcb]
2026-07-30 Charger terminal is OUT+/OUT- not B+/B-; set-points on silk; silk clean
    From Francis's wiring verdict, one item was a board error not an assembly
    note: the protected TP4056's load must hang on OUT+/OUT- (behind the DW01
    FETs). The U2 terminal was silk-labelled B+/B- - instructing an unprotected
    discharge path. Relabelled OUT+/OUT-; the 18650 wires straight to the
    module's own B+/B- pads and never touches the board. Nets unchanged.
    Also:
    - Buck/boost set-points now printed on the board's top edge ("SET BUCK
    5.4V - BOOST 5.0V") - the 0.4V offset IS the diode-OR priority mechanism
    Francis asked about, and the values can no longer get lost in a doc.
    - J11 reference moved out of the U4/HORN-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
    [freeisp_brain.kicad_pcb]
2026-07-30 trace.py: functional netlist verification against first-principles intent
    Third check alongside audit.py (geometry) and DRC (rules): the EXPECTED
    table is written from the firmware pin defines and the modules' own
    pinouts - deliberately NOT imported from build.py - so the board file and
    the intent are independent sources that must agree.
    Verifies all 30 nets pad-for-pad (97 connections) and that 13 pins that
    must be empty ARE empty (TX0/RX0, strapping GPIO12, RC522 IRQ, MPU
    XDA/XCL/AD0/INT...). Current board: TRACE PASS on every one.
2026-07-30 Rev F: the real board is the 38-pin DevKitC, not the 30-pin V1
    Francis counted his devkit: 19 pins per side. The whole board was drawn for
    the 30-pin DevKit V1 - caught by asking the question BEFORE ordering, which
    is exactly what the paper-test gate exists for. His photo of the board
    sitting on the rev-D print also confirms the standard DevKitC pin order
    (GND 23 22 TX RX 21 GND 19 18 5... readable on the module silkscreen).
    Changes:
    - Sockets are 1x19 (48.3mm), anchored at y=28; pin maps U3A/U3B fully
    remapped to the DevKitC order. Same GPIOs, new positions: 3V3 is now
    top-LEFT, 5V bottom-left, GND top-right.
    - Six FLASH pins (SD0-SD3, CMD, CLK = GPIO6-11) now exist as holes and are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
    [freeisp_brain.kicad_pcb]
2026-07-30 Rev G: 115x115mm per Francis + devkit body keep-out on silk
    His "11.5" was the board size - 11.5cm, so everything fits without
    cramping around the 38-pin devkit's body overhang seen on the paper test.
    Bottom row dropped to y=101 and the peripheral headers moved to x=97, so
    the USB/Type-C overhang now has ~15mm of clear air before the first tall
    part. The devkit's true body (with estimated 6mm antenna / 12mm USB
    overhangs - verify on paper) is drawn on the silkscreen as an "ESP32 BODY
    - LOW PARTS ONLY" box; only flat parts (discs, resistors) live inside it.
    Row spacing: not yet measured, Francis delegated the call - staying at
    25.4mm (DevKitC standard, consistent with his photo). The paper t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
    [freeisp_brain.kicad_pcb]
2026-07-30 Rev H: ESP32 keep-out emptied, block moved right into the free space
    Francis's call, both parts of it:
    - NOTHING under the devkit body. The keep-out box is now genuinely empty;
    C2/C3 moved beside their own dividers on the left, R8 next to the reed
    terminal it protects, R1/R2/R7 into a column on the right.
    - The ESP32 block moved RIGHT (not left - he corrected me, the space is on
    the right) and down, so the board area is actually used.
    - D1/D2/C1 regrouped as a power corner right of U3B.
    Cost, accepted: 19 -> 25 vias, since traces now route around the keep-out
    instead of under it. Vias are free at a fab; a resistor pressed against the
    devkit's underside is not.
    Router improvement that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
    [freeisp_brain.kicad_pcb]
2026-07-30 wiring_diagram.png: external hookup sheet generated from the fab file
    Francis wants to eyeball every incoming wire before releasing the board for
    printing. wiring_png.py parses freeisp_brain.kicad_pcb - the same file that
    goes to PCBWay - so the pin names and nets on the sheet cannot drift from
    what is actually manufactured. Regenerate it after any build.py change.
    Board in the middle with the devkit and its keep-out drawn; every external
    module around it, each pin numbered, named as the MODULE prints it, and
    mapped to the net it lands on. Unused pins (RC522 IRQ, MPU XDA/XCL/AD0/INT)
    are explicitly greyed "not connected" so a missing wire never looks like an
    omission. Colour = what the wire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
    [wiring_png.py]
2026-07-30 Wiring diagram: show the actual ESP32 pin each wire reaches
    Francis asked why J4/U4 carry names like GND/VDD/SCL while the ESP32 shows
    numbers - the diagram stopped at the net name and never closed the loop to
    the GPIO. Two naming systems, no bridge between them.
    Now each row reads: pin no. | name PRINTED ON THE MODULE | net | ESP32 pin,
    so "TFT pin 3 SCL -> SCK -> ESP32 D18" is one line. Devkit pin names come
    from the board file's pad-to-net data, not a hand table.
    Also draws the devkit with all 38 of its real pin names (3V3 EN VP VN D34..
    / GND D23 D22 TX0..), gold where a wire lands and grey where none does, so
    the 15 empty pins are visibly deliberate. Nets that never touch a GPIO now
    e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
2026-07-30 Wiring diagram: one line per wire, landing on its real hole
    Francis: "i need to see which wire is entering into which pin". The bundled
    version showed one line per connector; this draws every wire separately and
    ends it on the actual pad, using the real pad coordinates from
    freeisp_brain.kicad_pcb (footprint placement + rotation applied), so the
    board in the middle is to scale and a line cannot point at the wrong hole.
    Each connector is outlined and named on the board itself, so a wire can be
    followed from the module, across, to the labelled connector it enters. Every
    other pad is drawn too - small dots for the parts already soldered on - so
    nothing looks missing. Rows with a hole but no wi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
    [wiring_png.py]
2026-07-30 Wiring diagram: logical view, module pin straight to its ESP32 pin
    Francis: "you were unable to connect to the actual esp32 pin". Correct - the
    lines stopped at the connector. My first fix drew the real copper paths and
    was unreadable spaghetti, which is honestly what PCB routing looks like, so
    that was the wrong tool for a diagram whose job is clarity.
    Redrawn as a LOGICAL view: the devkit sits in the middle with all 38 pins
    named, and each wire runs as one clean line from the module pin to the exact
    ESP32 pin it ends on. board.png still shows the true copper.
    Every unused devkit pin is greyed and says why - "spare", or "FLASH" in red
    for SD0-SD3/CMD/CLK, where a wire would stop the board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
    [wiring_png.py]
2026-07-30 Clearance 0.25 -> 0.45mm; confirm no pad has foreign copper on it
    Francis circled an ESP32 pad where two things appeared to enter. Checked it
    properly rather than by eye: counted every track terminating on every ESP32
    pad and compared nets.
    Result: NO pad anywhere has copper of a different net touching it. The only
    pad carrying more than one track is a GND pin (three tracks, all GND - the
    ring meeting its stub, which is correct). What looks like a second wire
    entering is a trace PASSING BY - SENSE_BATT on top and LED_R underneath run
    alongside that pin column.
    Raised clearance to 0.45mm since it turned out free: same 249 segments, same
    25 vias, so pure manufacturing margin. Honest note: it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
    [freeisp_brain.kicad_pcb]
2026-07-30 Wiring diagram bug: cross-column wires never reached their pin
    Francis: "why doesn't it have a pin at 5?" - because the drawing was wrong,
    not the board. Every wire from a right-hand module was terminated at the
    RIGHT edge of the chip, but several of those pins live on the LEFT column:
    relay IN -> D13, buzzer SIG -> D27, TFT BLK -> D33, and all the 5V / 3V3
    feeds. Those lines ended in mid-air beside the wrong pins.
    Fixed: when the target pin is on the opposite column the line now routes
    round the chip - whichever end is nearer - and arrives on the side the pin
    is actually on, with a dot marking the landing.
    Also stopped needless trips: GND, 5V and 3V3 appear on BOTH columns, so a
    wire now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
    [wiring_png.py]
2026-07-30 Wiring diagram: add the POWER CHAIN strip
    Francis asked to see the power supply as a journey - "definitely it's 12 V
    and then it goes through something before reaching the board" - rather than
    as rows in a table.
    New band across the bottom follows the 12 V the whole way:
    12 V PSU -> inline FUSE -> J1 -> D3 guard -> U1 BUCK 5.4 V -> D1 -> 5V_SYS
    -> ESP32 5 V (and TFT, buzzer, relay, horn)
    with the two branches drawn where they really join: R5/R6 tapping the 12 V
    so D34 can watch the mains, and the battery path (TP4056 -> 18650 -> boost
    5.0 V -> D2) merging into the SAME 5V_SYS rail. Notes why the two diodes
    both point into the rail, so the higher side feeds it and the other waits -
    which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
    [wiring_png.py]
2026-07-30 Print calibration on the fit-check sheet: ruler + the two key dimensions
    Francis's paper test had ~6 pins landing then the rest drifting off, and he
    measured the printed outline at 9.56cm where the board was 10.00cm - his
    printer shrank the page to 95.6%. Over the 45.72mm pin row that is 2.0mm of
    accumulated error, which is exactly the symptom.
    Verified the design is not at fault: every pad gap on all five connectors is
    exactly 2.54000mm, ESP32 pin1->pin19 spans 45.7200mm, rows are 25.4000mm
    apart, outline is 115.000mm square.
    Added to the fit-check plot, on Dwgs.User so the fab never makes it:
    - a 100mm ruler with 10mm ticks, labelled "MEASURE THIS LINE FIRST"
    - the ESP32's two critical d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
    [freeisp_brain.kicad_pcb]
2026-07-30 export_gerbers.py: PCBWay-ready zip, with a guard against stray artwork
    Exports F.Cu, B.Cu, both silkscreens, both masks, Edge.Cuts plus separate
    PTH/NPTH Excellon drills, and zips them.
    The guard matters: Dwgs.User is deliberately NOT exported, because the
    print-calibration ruler lives there and must never be etched onto a real
    board. The script then re-reads every generated .gbr, extracts the actual
    draw coordinates and fails the run if anything falls outside the 115mm
    outline - so a future layer mistake cannot quietly reach the fab.
    This run: outline 115.000 x 115.000mm, 143 plated holes, 4 unplated (the M3
    mounts), no off-board content, 12 files, 57 kB.
    gerbers/ is gitignored - regene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
    [export_gerbers.py]
2026-07-30 J14 expansion header: every spare pin brought out for later
    Francis's call, and a good one - cheap now, impossible after the boards are
    made: "we can always have extra pins, something can come up... for example
    we can decide to add buttons, you never know, so we can always reprogram
    later and have a provision."
    2x5 header beside the ESP32 carrying 3V3, 5V_SYS, three GNDs and the five
    usable spare pins: D36 and D39 (input-only, ADC1), D14 (full GPIO with an
    internal pull-up - the right pin for a button), D12 (works, but a strapping
    pin) and EN (reset button to ground).
    TX0/RX0 stay off it deliberately - they are the USB serial port, and loading
    them breaks programming and the serial monitor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
    [freeisp_brain.kicad_pcb]
2026-07-30 export_gerbers.py: prove every pad is drilled, not just that files exist
    Francis: "I hope the gerber files has the latest expansion". Verified all ten
    J14 pads are present - drilled in the Excellon file and with copper drawn at
    them on both layers - and then made that check permanent rather than a
    one-off answer.
    The script now reads every pad out of the board file, applies footprint
    placement and rotation, and confirms a matching hole exists in the drill
    output (negating Y, which is the drill/gerber convention). A stale export is
    the nastiest silent failure available here: the zip looks complete, the file
    count is right, and a whole connector is simply absent. Now it fails the run.
    This e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
    [export_gerbers.py]
2026-07-30 Drop drill maps from the fab package
    PCBWay's Gerber viewer filed two of our files under "other: drawing" and
    "unknown". Traced them: the "drawing" pair are the *-drl_map.gbr drill maps
    - human-readable legends of drill symbols and a size table, not fabrication
    data. "unknown" is the .gbrjob X2 metadata, which is standard and harmless.
    Removed the drill maps. They add nothing a fab needs and introduce exactly
    the ambiguity you do not want an operator resolving by guesswork - a drill
    map mistaken for artwork would etch a legend table onto the board.
    Package is now the classic unambiguous set: 7 gerbers (2 copper, 2 silk,
    2 mask, outline) + 2 Excellon drills + the job file. 45 kB, 10 files.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
    [export_gerbers.py]
2026-07-31 bom.py: BOM + CPL, and the line between soldered and plugged-in parts
    Francis asked whether PCBWay assembly could source everything including the
    ESP32. It cannot, and the reason is structural: the ESP32, TFT, RC522, MPU,
    relay, buzzer, buck, charger and boost all PLUG IN. The board carries their
    sockets and terminals, so an assembly quote covers the empty connectors and
    passives only - 30 through-hole parts - and never touches a module.
    BOM.csv lists exactly those 30 in 19 shop-friendly lines (screw terminals
    with their 5.08mm pitch, sockets described as cut from a 40-pin strip,
    Schottky alternates named). CPL.csv is the centroid file in PCBWay's format,
    board-relative with the origin at t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
    [BOM.csv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]
2026-07-31 assembled.png: what the board looks like once it is built
    Francis wanted to see it populated before ordering. Part bodies and
    positions are read from freeisp_brain.kicad_pcb, so this is the real layout
    rather than an impression: green screw terminals, black headers with gold
    pins, the resistors and diodes with their cathode bands, the 470uF can, and
    the ESP32 standing on its sockets over the middle of the board.
    The three wire-in modules are drawn beside it at true size (LM2596 43x21,
    TP4056 26x17, MT3608 36x17) with wires running to their terminals, since
    that is how the assembly actually sits - none of them touch the PCB.
    Also makes his observation visible: the middle is empty by design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
2026-07-31 FIR_ModulePlate redrawn as an electronics tray for the real PCB
    The old plate was 130x115 carrying five loose boards on standoffs - ESP32,
    buck, charger, MPU, battery. Obsolete: there is now a real 115x115mm PCB
    which already carries the ESP32, the MPU and every passive. A 115mm board
    cannot fit a 130x115 plate with anything beside it, so this is a redraw, not
    an edit.
    Now a flat 150x180 tray holding: the PCB on 4 posts at its true 106mm M3
    pattern (6mm tall, to clear the through-hole solder joints underneath), and
    the four things that never touch the PCB - LM2596 buck and TP4056 charger
    above it, 5V boost and the 18650 holder down the left. Each module sits
    beside the terminal it feeds, so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
2026-07-31 Tray down to 125x125: the modules go UNDER the PCB, not beside it
    Francis, on the 150x180 first draft: "this is too big actually a whole
    180mm?" - he was right, and the draft was lazy. Spreading four modules out
    sideways when they only need 26% of the area under a 115x115 board is pure
    wasted plate.
    Raising the PCB on 26mm posts puts all four in space that was already empty:
    battery down the left, buck top-right, boost and charger along the bottom.
    Nothing clashes, nothing fouls a PCB post. Tray is now 125x125 - 42% less
    area than the draft, and barely bigger than the board it carries.
    The trade is height: 52mm to the top of the ESP32, and the buck/boost
    trimpots are now under the board, s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
2026-07-31 Wire up the parts the board already had but the firmware ignored
    Rev E put four things on the brain board that no code ever touched. The
    horn could not sound, the card reader did not exist, and the box could
    not tell you it had lost mains. That is fixed.
    - HORN RELAY (GPIO13): the loud one, on its own pin. Steady for the whole
    siren while the buzzer keeps the rhythm - a relay clacking 600 times in
    three minutes buys nothing, and a continuous horn is louder. Silent
    during the grace period, because a polite warning is not a 100dB horn.
    The old "set BUZZER_PASSIVE to 0 for the horn" note was stale advice
    from before the relay had its own pin; doing that would have killed the
    buzzer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
    [HelloScreen.ino, LiveDashboardNext.ino, secrets.example.h]
2026-07-31 perfboard_layout.png: where every part goes on the 7x9cm test rig
    Drawn for "easy to fix", not for looks - it is a throwaway rig for proving
    the parts work together before the real boards land, not a small copy of
    rev E. The PCB is 115x115; this board is 70x90 and cannot hold that
    layout, and hand-copying it would be a day of soldering thrown away.
    Pin destinations are lifted from PINOUT.md rev E on purpose, so firmware
    proven on the rig runs on the real board unchanged.
    What the drawing settles:
    - three bare-wire rails down columns H (3V3), J (5V) and L (GND), soldered
    at every pad so any hole in the column becomes a tap point
    - the ESP32 placed so the USB-C connector hangs PAST the boa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
    [perfboard_png.py]
2026-08-01 bom.py: the boost is no longer TO BUY, but it is undersized
    Francis has 2x MT3608. They are the right kind of part for J13 and fine for
    bench work, so the "TO BUY" was stale.
    Recording the caveat with it rather than just ticking it off: the MT3608's
    2A is a SWITCH rating. From a 3.7V cell that is roughly 1A out at 5V, and on
    battery this module carries the ESP32's WiFi bursts, the TFT, the relay coil
    AND the sounding horn at the same time. PINOUT.md asks for a genuine >=2A
    step-up for exactly that reason. Expect the rail to sag when the horn fires
    on battery, and budget a bigger boost before the real build.
    [bom.py]
2026-08-02 powerchain_wiring.png: the bench power chain, staged
    The PCB drawings show the finished board. This one is for what Francis is
    actually building right now: three modules on a base, three diodes inline in
    the wires, everything landing on the logic board's 5V and GND rails. Same
    nets as rev E, built with heatshrink instead of copper.
    Colour-coded by stage so the drawing says where he is rather than just what
    the design is: the mains half is DONE (12V through the buck and D1, rail
    measured at 5.02V), the charger and cell are NOW, the boost and D2 and the
    sense dividers are LATER.
    The thing the drawing exists to make unmissable is THE SPLIT: the buck's
    OUT+ feeds two places, D1 and the charger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
2026-08-02 Note the battery-percentage screen, with the four ways it lies
    Francis wants a percentage on the screen instead of raw volts - it is what
    anyone standing at the box understands, and it belongs in the heartbeat so
    the account can say "this box is on 40% battery".
    Recording it next to the power code with the traps, because the obvious
    implementation is wrong in four separate ways: a Li-ion cell sits between
    3.6 and 3.8V for over half its capacity so a linear map sticks at 50% for
    hours then falls off a cliff; voltage sags under load so reading it while
    the horn sounds makes a healthy cell look flat; the TP4056 lifts the cell
    to 4.2V so it reads full while charging; and raw ADC noise makes the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
    [HelloScreen.ino, LiveDashboardNext.ino]
2026-08-05 CardTest: force the antenna gain, or it never reads a card
    CardTest reported "reader is alive" from the version register and then read
    nothing, ever. That reads as broken wiring and is not - it is the same clone
    behaviour already worked around in CardDisarm and in the dashboard firmware:
    the RC522 boots with its receiver turned right down, so SPI answers
    perfectly while the RF field is too weak to wake a card lying on the pad.
    Alive is not working. The version register only proves the SPI wiring; it
    says nothing about whether the radio can reach a card.
    Added the same three lines the other two sketches already had - gain to max,
    then antenna off/on so the new setting takes - plus a log lin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
    [CardTest.ino]
2026-08-12 PCB: clear the USB cable path below the soldered-in ESP32
    J10 buzzer and K1 relay headers move up beside R8/R7, J9 slides
    right into K1's old spot (its body sat under the plug overmold),
    J11 nudges 2mm right. Stubs + silk follow. DRC clean, audit pass,
    gerbers + renders + BOM/CPL regenerated.
    [freeisp_brain.kicad_pcb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]
2026-08-12 HelloScreen: the ALARM banner rotates instead of freezing the screen
    Door open + armed used to lock the red banner on until the door
    closed, hiding every dashboard page. The banner is now an extra
    page in the 5s rotation while the alarm is raised, with a live
    state + elapsed timer on it. Alarm sound/LED/heartbeat unchanged.
2026-08-12 README: the silk names parts for the designer, not the builder
    Assembling rev H, "K1" meant nothing at the bench -- the header that
    matters is the one printed RELAY. Record the rename list for the next
    revision, and put the rail voltage on the two identical 8-pin headers so
    TFT (5V) and RC522 (3V3) cannot be swapped by eye.
2026-08-12 Relay header silk reads S + - , the words on Francis's actual relay
    His Tongling JQC-3FF-S-Z prints S + - . The board printed IN GND VCC,
    so matching the module meant translating in your head at the bench --
    exactly what the silk exists to avoid. The pins and nets are unchanged;
    only the three words moved to the ones on the part in hand.
    Gerbers re-exported. DRC still 0 errors, 0 unconnected.
    [freeisp_brain.kicad_pcb]
2026-08-12 POWER_WIRED=1: the rev-H board is assembled, let GPIO34/35 speak
    The dividers have been copper since rev E and firmware since the same
    review -- only this flag kept the ADCs silent. Compiled at 90% flash.
    Copied to HelloScreen (the sketch Francis uploads from).
2026-08-12 Bench round 2: motion on, card quiet 5 min, router stops narrating
    - MOTION_WIRED=1: the MPU is plugged into the rev-H board's U4
    - CARD_QUIET_MS 1h -> 5min (Francis's call: service window, not a nap)
    - REST_REPEAT_MS 60s -> 30min: his bench router deliberately blocks the
    box, so a line a minute per fetcher was four lines a minute of known
    news drowning the monitor. STATUS still shows ROUTER !! + fail count.
    Compiled at 90% flash. Copied to HelloScreen.
    [HelloScreen.ino, LiveDashboardNext.ino]
2026-08-12 Restore HelloScreen: it was ahead, and I copied the older file over it
    HelloScreen is the sketch Francis uploads, so it had run ahead of
    LiveDashboardNext -- ALARM_WIRED=1, RFID_WIRED=1, and the alarm banner
    that rotates instead of freezing the screen. Copying LiveDashboardNext
    onto it reverted all three: the box came up reporting no reed and no
    reader on hardware that has both.
    Rebuilt from 7906027 (the last good HelloScreen) and re-applied the four
    bench changes on top. LiveDashboardNext now copied FROM HelloScreen, so
    the two match with HelloScreen as the source of truth.
    Both compile at 91% flash.
    [HelloScreen.ino, LiveDashboardNext.ino]
2026-08-12 An unreachable router was eating card taps: back off, don't hammer
    CardTest reads both of Francis's cards instantly; the dashboard would
    not pair the second one. The reader was never the problem -- the loop
    was. restGet BLOCKS for up to 8s per call and four fetchers poll every
    2-10s, so with the router deliberately blocked on his bench the box
    spent more time stuck in socket timeouts than running. pollCards() only
    runs between those calls, so a tap landing in the gap is never seen.
    Two changes, both about keeping loop() free:
    - timeouts 3s/8s -> 1.5s/2.5s. This shares a thread with the reed and
    the reader; a router slower than that is down as far as the box cares
    - after 3 consecuti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
    [LiveDashboardNext.ino]
2026-08-13 HelloScreen: HORN_WIRED 1 - the relay is wired, enable GPIO13
    The horn stayed silent through every alarm because the flag was
    still 0, so setup() never made the pin an output and horn() was
    compiled out. Relay polarity still needs confirming with siren=test.
2026-08-13 live-3.2: the ten hardening fixes from the six-dimension review
    Every fix was independently confirmed against the code by the review's
    verify pass. In one release because they interlock:
    - motion rollover: line-1002 unsigned compare silently killed jolt+tilt
    after 49.7 days uptime; now the signed idiom the file already preaches
    - task watchdog: 30s panic-reboot; a wedged loop() was a dead alarm on a
    wall that still looked armed. Fed once per loop pass, released for OTA
    - stale note replay: the router note ran EVERY 3s forever, so one
    forgotten note="siren=off" silenced every future alarm within 3s of
    raising. Now executed once, on change
    - motion alarm clearable: card quiet expiring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
    [HelloScreen.ino, LiveDashboardNext.ino]
2026-08-13 ModulePlate rev B: per-module mounting + wire tunnels + relay
    Buck (2 holes) and relay (4 holes, newly on the tray) get raised
    screw bosses; boost and TP4056 (no holes) get corner pedestals +
    brackets + zip tie. Everything but the 18650 stands 5mm up so the
    harness runs underneath. Two extra ties go over the cell itself.
    Tie posts all move to -X; +X stays clear for the J4/J5 ribbons.
    Posts 26->30 (box cavity +4mm). Hole positions are GUESSES - vernier.
2026-08-13 ModulePlate rev C: measured relay + 18650, cradle, drop-in fit
    Relay is 34x26 (terminals overhang to 46, kept in free air on +X).
    Brackets get 0.7mm/side - modules sit in, the tie holds them.
    The 18650 holder (59x18 measured) gets a three-sided snug cradle,
    wire end open, plus the two over-cell ties so nothing can fall.
2026-08-13 ModulePlate rev D: half-round saddle for a BARE cell, no holder
    Francis is using the cell alone, not a plastic holder, so the
    rectangular pocket was wrong - it would touch a round cell on two
    edges only. Now a half-round saddle beds it along its whole length,
    cut as 32 slices sized at their wider edge so it can never bind.
    Both ends open: + button one end, can the other, leads leave both.
    Channel is exactly half-deep, so it drops in; the two ties hold it.
2026-08-13 PINOUT: document the master switch - a DPST, not a single pole
    Two sources merge at the diode-OR, so breaking the 12V only looks
    like a mains cut and the battery takes over. The switch has to
    break BOTH OUT+ leads (buck and boost) - both are existing screw
    terminal wires, so no board change. Mount it inside the alarmed
    door: an outside switch is the thiefs off button for the alarm.
2026-08-13 ModulePlate rev E: the cell CLIPS in instead of resting in a half-pipe
    Francis caught it on the render - rev D was exactly half-deep, so
    nothing held the cell until the ties went on and it could lift
    straight out. The walls now carry 3mm past the centre line, closing
    the mouth to 17.6mm against an 18mm cell. To keep that a push and
    not a fight the walls are thinned to 1.5mm above the centre so they
    flex the 0.2mm each that is needed, and a flared funnel on top
    guides the cell in rather than catching its edge.
2026-08-13 ModulePlate rev F: saddle closes to 74%, buck bolts are diagonal
    Francis measured the buck holes ~35-36mm DIAGONALLY apart, so the
    stacked pair was wrong. Four bosses are drawn at (+-17, +-5.5) -
    diagonal 35.7 - because a 180-degree turn maps each diagonal onto
    itself, so picking the wrong one could not be recovered; two take
    screws, two just support.
    The saddle now wraps 4mm past centre (74% enclosed) instead of 3.
    That is 1.2mm of interference, which only stays a light push
    because the walls are slotted into four fingers a side: 11.3mm
    free length bending 0.6mm = 0.85% strain, well inside PETG.
2026-08-13 live-3.4: horn back on, screen controllable from the panel, modern chrome
    HORN_WIRED back to 1. Francis set it in 02d25b4 because the relay is
    actually wired, and my live-3.2 sync copied LiveDashboardNext over
    HelloScreen and silently reverted it -- the same clobber as before, so
    the horn stayed dead through every alarm. The flag now carries a comment
    saying not to reset it, and the sync direction is recorded in memory.
    REMOTE SCREEN CONTROL. The screen is the product's face, so the owner
    tunes it from the fleet page like a phone. New commands, all persisted
    in NVS and all mirrored back in the heartbeat so the panel shows what
    the box is really doing:
    page=0..4 hold one page page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
    [HelloScreen.ino, LiveDashboardNext.ino]
2026-08-13 live-4.0: an update that cannot brick the box, and three features to sell it
    ANTI-BRICK OTA. ESP32 flash holds two app slots; a pull update writes the
    spare and leaves the old build intact. Now the box uses that. Before
    flashing it sets "pending" in NVS, and the new build boots ON TRIAL: it
    has 3 minutes to get a heartbeat ACCEPTED by the server -- which proves
    radio, TLS, JSON, credentials and server all work in this build. Succeed
    and the flag clears. Fail, or crash-loop through 3 boots without ever
    getting there, and the box flips esp_ota_set_boot_partition back to the
    build it came from and reboots into it. A firmware that cannot phone home
    is indistinguishable from a brick to the person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
    [HelloScreen.ino, LiveDashboardNext.ino]
2026-08-13 ModulePlate rev G: fix two blockers a render could never show
    A five-lens audit with adversarial verification raised 51 findings;
    16 survived refutation. Two were blockers:
    1. Every corner bracket was a FLOATING body. The pedestal outer face
    and the bracket inner face both landed at cx +- (w/2 + SLACK) -
    flush to the micron, zero shared volume AND zero shared area - so
    the JOIN had nothing to fuse to and the Ls hung 5mm above bare
    plate. Boost and TP4056 had no lateral retention at all. The
    brackets now grow from the plate face, RAISE + wall tall.
    2. Every PCB post pilot was a SEALED void: cut PLATE_TOP..+29.5
    inside a post spanning PLATE_TOP..+30, capping it with 0.5mm o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
2026-08-13 ModulePlate rev H: engrave the module names into the plate
    Two modules bosses look identical in a render - Francis could not
    tell the bucks four from the relays four, and the diagonals are
    35.7 vs 35.0mm so even measuring does not separate them. The plate
    now says which is which, and carries the 5.4V / 5.0V set-points
    like the PCB silkscreen does. Each label sits inside its own
    module footprint, verified clear of every boss, bracket and slot.
    Every label is independently try/except guarded - a Fusion build
    that cannot do sketch text loses a name, never the tray.
2026-08-13 live-4.1: report the page on the glass, run every queued command at once
    Two fixes the bench found the moment the remote was used for real.
    The box never said which page it was displaying, so the panel's mirror
    rotated on its own browser timer and showed TRAFFIC while the box was
    held on PORTS. It now reports `page` every beat and the mirror follows
    the glass instead of guessing.
    And the server could only hand back one command per heartbeat, so a
    control that queues its command plus poll=fast needed two beats -- 40
    seconds -- to take effect. That single fact is what made the remote feel
    broken. 4.1 reads a `cmds` array and runs all of them in one reply, and
    still understands the old single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
    [HelloScreen.ino, LiveDashboardNext.ino]
2026-08-13 Keep the backlight PWM out of the buzzer's way
    The box is crash-looping with PANIC, and only ever while the siren is
    sounding -- it boots, the siren resumes, and it panics within seconds.
    Two things are new in 4.0 and both run only during a siren: the backlight
    moved to LEDC PWM, and HORN_WIRED went 0->1. This addresses the first.
    tone() also allocates LEDC channels and re-allocates on every call, and a
    motion siren calls it every 120ms; letting both pick channels dynamically
    means they can land on the same one. The backlight is now pinned to
    channel 7 with ledcAttachChannel, and applyBright() refuses to touch the
    LEDC peripheral while a tone is playing.
    Defensive, not confirmed: the seria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
    [HelloScreen.ino, LiveDashboardNext.ino]
2026-08-14 ModulePlate rev I: measured fits, and the boards press in now
    - cell corrected to 14.5x52 (a 14500, not an 18650): saddle re-tuned
    to a real 0.64mm press fit, plus an end stop with a lead notch so it
    cannot slide out lengthwise
    - relay holes spread 0.5mm outward both ways (were tight on the part)
    - buck re-measured 43.2x21.4, holes recomputed from Francis's
    edge-to-circumference measurements (assumes 3.0mm board holes)
    - TP4056 envelope 28.2 long (includes the side extrusion) and gets a
    self-locking emboss: the board clicks under it before it rests
    - boost VIN+/VOUT+ ends compressed 1.5mm total
    - all corner brackets grow stepped wedge grip bands: wide mouth, then
    the face steps pas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
2026-08-14 ModulePlate: a wedge that actually looks like a wedge
    Francis called it out on the render - the two offset grip bands read
    as straight walls. The bracket inner faces now taper continuously:
    a staircase of thin slices from the plain face at the top lip down
    to full reach at the seat, every step ledge facing up so the
    flat-printed plate still has zero overhang.
2026-08-14 ModulePlate rev J: real snap fingers, and a saddle that closes
    Francis on the rev-I render: the walls are straight, there is no
    emboss, no wedge at all, and the thickness is big making it rigid -
    you can't even push something in.
    He was right on every count. The L-corners are deleted: a right angle
    is a stiffener, so no taper cut into one could ever flex, and the
    taper I had cut was a 0.2mm staircase invisible at any scale.
    Each 'corners' module now gets four free-standing 1.3mm flex fingers,
    one per side, shaped the way he described - a mouth that flares 1.8mm
    open at the top, funnels the board down, and an emboss that juts
    0.55mm past the board edge so the board shoves it aside and it sp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
2026-08-14 ModulePlate rev Q: eight wedges on the boost, and a funnel that fits
    Boost goes from four wedges to eight, two per side, as Francis asked.
    One 7mm band was holding a 36mm edge, which lets the board pivot about
    that single point; two bands 18mm apart cannot.
    Cell funnel fixed. It was driven from a 13.5mm top opening, which made
    the widest point of the funnel 1.0mm NARROWER than the 14.5mm cell -
    so there was no lead-in at all: the cell landed on the funnel's sharp
    outer rim and each wall had to spread 0.5mm before it could even
    enter. The throat is now the design input at 10.5mm, so the closure
    Francis wanted is untouched, and the funnel is derived to always open
    1.0mm clear of the cell. Ram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
2026-08-14 Put the cell entrance back to 13.5mm, as specified
    Francis asked for a 13.5mm entrance on a 14.5mm cell. I overrode it to
    15.5 on the reasoning that a lead-in must be wider than the part it
    guides, and he rejected that - correctly. The cell is a round rigid
    cylinder, so its own curvature is the wedge: it rides its own radius
    apart on the way in, needing 0.5mm of spread per wall against the
    2.0mm those same walls already give at the throat. The narrow entrance
    is the retention, not an obstacle to it.
    Comment now says not to open it up again, and why.
    Boost's eight wedges and the finger-fusing check stay.
2026-08-16 Bolt the horn to the cap, and give the switch's plug somewhere to go
    The horn stops being a preview. FIR_Shell now cuts the real mount into the
    deep cap: three 6.5mm through-holes on the measured 50/50/38.5 triangle, each
    with a 14mm pad embedded 0.5mm into the roof so a bolt pulls against 6mm of
    material instead of 3mm, plus a 12.5mm PG7 gland at 43mm radius - under the
    104mm body, clear of the 69mm flange, dropping its lead beside the brain case
    rather than onto it. The cap prints roof-down and is flipped left/right on
    assembly, so the horn's X is mirrored exactly once; the four brain bosses
    never caught that because their pattern is symmetric.
    The Tenda's DC jack is on its right-hand end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
2026-08-16 Bring the horn inside: shift the brain case 47mm and let the sound out the front
    The horn was modelled as a 104mm drum standing upright on the cap. It is a
    flared siren horn on a swivel foot lying on its side - owner-measured 102 x 105
    x 102 with the tightening bolts off the back - so every clearance computed
    against the old shape was void. Rebuilt around the real part, inside the box
    where he wants it.
    It does not fit as the box was laid out. Searched the cavity against every
    device and every piece of tub hardware, all three orientations, on a 0.5mm
    grid: there is no 102 x 120 x 102 void anywhere. The brain case hangs across
    the middle from Z36.6 down, leaving 70mm of full-height width bes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
2026-08-16 Move the switch clear of its own plug, and close the vents again
    ShellCheck died on its last line: the horn rework left HORN_CY in the final
    messageBox after the constant was gone. The model built perfectly and then
    threw. My harness called the build_* functions directly and never ran run(),
    so it never touched that line - it now executes the real run() entry point for
    every script in both trees, which is the only check that would have caught it.
    The switch moves inboard as asked, so the barrel plug goes in from the side:
    POE_CX -85 -> -71, giving its jack face 25.0mm of air instead of 11.0. That
    also means its position finally belongs in one place. POE_CX, the envelope, the
    68.8 x 11.5 por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
2026-08-16 Assembly diagnosis: fix the two real faults it found
    Full pre-assembly audit computed from the built geometry: every screw vs the
    hole it must find, thread engagement per joint, driver access per step,
    install sweeps, service access, and an honest inventory of every opening in
    the outer envelope.
    All fastener patterns align - BottomLid's six M3 land on tub pilots through
    the mirror mapping, the cap's six side holes hit the Z72 wall pilots, the
    mirrored cap bosses coincide with the case roof holes, cover lock screws hit
    the shelf bosses. Two real faults surfaced and are fixed:
    - The horn's M4x10 would have run 1mm past its pilot, leaving 1mm of floor
    under the tip. Pads are now 6mm with 7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
2026-08-16 Horn foot: two reachable bolts and a peg; water scope settled as top-tight
    The foot triangle flips apex-forward. The two base holes land 13mm behind the
    horn body on the extension side, where a driver comes straight down with the
    horn still on its bracket; the apex hole, under the body where no tool fits,
    drops over a printed 5.5mm locating peg with a stepped lead-in tip. Peg takes
    shear, bolts clamp, and the take-the-horn-off-its-bracket assembly step is
    gone. Contract validation now fails if either real bolt ever ends up under
    the body again.
    Water requirement scoped by the owner: top rain must never reach the
    components, bottom drips are fine. Traced and verified from the geometry -
    cont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
2026-08-16 Lid closure: 8 screws on three sides; horn keeps all three bolts via a sled
    The owner's complaint was the lid fastening, and he was right twice over.
    First, the back wall: the cap was held by six side screws and nothing but a
    crush rib across the back. A back pair at X+-115 (clear of the adapter bank
    at |103| and above the keyhole slots) makes it eight screws on all three
    closed sides, screwing through the skirt into 12mm wall bosses exactly like
    the side pairs. Verified: all 8 cap holes land on their tub pilots, including
    through the assembly flip.
    Second, the horn peg. He rejected trading a bolt for a peg, and the model
    agrees with him: the bracket arm and rear tightening bolts hang over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
2026-08-16 Draw the horn as the flared bell it is, not a box
    Owner-measured taper: D74 at the rear, D76 mid, D83 at three-quarters, D102
    only at the mouth, on a ~29mm stand. The contract carries the profile and
    ShellCheck now draws stepped cylinders along the axis, with clearances
    computed from the real flare. The box-envelope scares dissolve: 14mm at the
    mid wall-boss row where the box claimed 1mm, real contact risk only at the
    mouth ring. The mouth is still 102, so the 47mm brain-case shift stands.
2026-08-16 The cap clicks home: six detents snap into skirt windows, then 8 screws lock
    The owner asked the right question: nothing held the cap between resting it
    on the tub and driving the screws. Now six stepped bumps on the tub's outer
    walls (two per side at Y+-45, two on the back at X+-45, 1.2mm proud with a
    half-proud upper step as the printable ramp and a flat catch underside) snap
    into 10 x 6.5mm through-windows in the cap skirt. Push the cap straight down,
    the skirt flexes 0.7mm over the bumps for the last few millimetres, and it
    clicks - the cap then holds itself while the 8 screws are driven at leisure.
    All 12 bump bands verified inside their 6 windows through the assembly flip,
    clear of scr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
2026-08-16 ShellCheck v38: shells-only inspection mode
    SHELLS_ONLY = True builds just the four printed shells - tub, deep cap,
    BottomLid, CurvedLid - plus the screw-axis and click-point markers, with no
    devices, horn, brain stack or cables. The owner wants to inspect the
    enclosure and its closures without the clutter; one flag brings the full
    all-up model back.
2026-08-16 ShellCheck v39: four shells and nothing else
    The marker pins added last round stick out past the shells by design, which
    reads as loose bars floating beside the box - exactly the clutter the
    shells-only view was asked for. SHOW_SCREW_MARKERS now defaults False, so the
    view is the tub, the cap, the BottomLid and the CurvedLid, full stop. The
    real clearance holes and pilots are in the printed parts regardless; the
    markers were only ever a visualisation aid and come back with one flag.
2026-08-16 The PORTS page becomes the router face: five sockets, plugged or empty
    A column of dots and names told you the link state; it did not SHOW it.
    Now page 2 draws the thing itself - a faceplate carrying five RJ45
    sockets, each with a metal shell, a keyed mouth with the latch slot
    under it, eight contacts and a link LED above.
    A cable that is in fills the mouth with the plug body and lights the
    contacts gold, with the LED steady green, winking amber while traffic
    moves. An empty socket is a black hole with dull bronze pins and a dark
    LED. Nobody has to be told which is which, and it reads from across a
    shop.
    Under the plate the same rx/tx numbers as before, two columns, so
    nothing that was on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
2026-08-16 Add HANDOVER.md: full write-up for whoever picks up the CAD next
    Records what the box is, every confirmed measurement, the decisions and the
    reasoning behind them, the approaches already tried and rejected, the two
    coordinate traps that have each caused real bugs, the offline verification
    harness, and the open problems - fastening legibility and wall mounting
    first, both raised by the owner and both real.
2026-08-18 Visible screw seats on every closure; wall plate + cleat replaces the keyholes
    - All 8 cap screws (now 4 per side wall, back pair moved to Y-118 so every
    screw is drivable on a wall-hung box) sit in 12mm counterbored pads.
    - BottomLid 6 screws get the same pads; head land grows 0.8 -> 1.9mm.
    - CurvedLid lock screws get dished seats (prints face-down, no proud pad).
    - Keyholes deleted. New FIR_WallPlate: 45-deg French cleat, pocketed wall
    screws, crest anti-pull wall, two under-floor arms locked by M4x10 driven
    from INSIDE the box (cap on = unreachable = anti-theft).
    - HEAT_SET_INSERTS one-flag decision in the contract, raised in every popup.
    - tools/fusion_offline_check.py: offline stu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
2026-08-18 Two-AI review round 2: selective inserts, cover end stop + key + 4 tabs, coupons
    - Per-closure insert flags (CAP/COVER_LOCK/BOTTOM_LID) replace the global
    HEAT_SET_INSERTS; insert bore is a placeholder until a real insert is bought.
    - Cover lock boss widened 7->10mm, screws moved X+-125 -> +-122 (insert-ready,
    2.1mm clear of the channel rib); bosses now end FLUSH at the cover inner
    face = hard end stop the screws clamp against.
    - 249mm tongue -> four 25mm locator tabs at X-90/-30/+30/+90; ONE shared
    COVER_RAIL_CLR=0.3 kills the declared-0.4/used-0.3 conflict (reviewer catch).
    - Anti-rattle nubs (0.15mm bite, last 5mm of travel) in both channels.
    - ORIENTATION KEY: rail block + channe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
2026-08-18 Reed + magnet tamper sensing for the front closure; fix D12 pad vs cover wall
    - CurvedLid v4: 16x16 pad on the inner front face at shell X+15 with a
    D12.05 press pocket for the measured D12.1 magnet, hidden 1.2mm behind
    the face. Magnet thickness ASSUMED 3.0mm - flagged in every popup.
    - BottomLid v4: 3.2 x 2.0 recessed reed groove in the shelf, head-on in the
    magnet's slide path (closed distance ~10.6mm), plus a D4 wire hole into
    the box between the router frame and the port row.
    - Caught and fixed: the D12 seat pads at +-132 clipped the CurvedLid end
    walls by 0.5mm - now D10, with a harness check for the whole class.
    - ShellCheck reports the reed..magnet distance and the bench-te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
2026-08-18 Top-cap tamper pair; magnet thickness measured 4.7mm
    - Contract: MAGNET_TH 3.0 (assumed) -> 4.7 (measured); cover pad deepened to
    6.5mm proud so the pocket holds the real disc; front pair now 10.3mm.
    - FIR_Shell v33: magnet pillar hanging from the cap roof to Z75 at assembled
    (X-60, Y125) with a downward-opening D12.05 press pocket (clean vertical
    bore in the roof-down print; X mirrored once - flip trap respected), plus
    a recessed reed groove in the tub top rail's front face; seated distance
    10.4mm, descending pillar passes 0.5mm in front of the recessed reed.
    - Validation + harness cover both pairs: 120 checks green, both trees.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
2026-08-18 Indoor variant: 3.5" TFT roof window + seat and 2 LED holes behind one flag
    - INDOOR_SCREEN=True cuts a 76x51 view window and an 86.5x57 x 1mm module
    seat into the cap roof at assembled (X+25, Y+108), plus 5mm green/red LED
    holes at (78,100)/(78,116). False restores the sealed weatherproof roof.
    - Screen dims are ASSUMED typical UNO-shield numbers (SCREEN_MEASURED=False)
    and flagged in the popup - measure the Landzo board before printing.
    - Indoor cap is NOT top-rain-tight (owner decision); ShellCheck's rain note
    now states whichever is true for the active variant.
    - Seat validated clear of brain case plan/bosses/magnet pillar; roof arrow
    moved to X-90; all roof features go through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
2026-08-18 Add FIR_PlaneProbe: one-run calibration of Fusion sketch-plane conventions
    The floating pads/bar in Francis's renders vs a green offline harness point
    at a yZ-plane axis-mapping mismatch between real Fusion and the stub. The
    probe builds 7 labeled bodies whose positions reveal the true yZ/xZ mappings,
    normals, and offset-start behaviour. Side-screw and cleat-bar geometry is
    SUSPECT until the probe screenshot comes back.
2026-08-18 Fix the yZ-plane convention: side screws, seat pads and cleat bar now land correctly
    Fusion's yZConstructionPlane maps sketch-X to world Z and sketch-Y to world Y
    (probe-verified; FIR_ModuleGadget's field-proven helpers had documented this
    all along). Every cyl_x/poly_x feature had been misplaced in real Fusion
    since v29 - Francis's 'I cannot find the screws' was literally true, on every
    version, while the offline harness passed because its stub modelled the
    assumption instead of reality.
    - cyl_x/poly_x helpers in FIR_Shell, FIR_WallPlate, FIR_ShellCheck,
    FIR_BottomLid now swap (cz, cy) at sketch time.
    - The stub's yZ mapping mirrors real Fusion; world-space assertions held
    unchanged th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
2026-08-18 PlaneProbe v2: measure and PRINT the plane conventions instead of eyeballing
    v1 asked a human to judge body positions from a render; that judgement was
    wrong and moved the cap seat pads to the floor. v2 reads each test body's
    real bounding box back from Fusion and prints the numbers, so the convention
    is measured, not interpreted.
    Also: ShellCheck PRESENTATION now defaults True (opaque + fastener markers)
    so the owner only has to press Run, with a harness pass covering the shipped
    default config.
2026-08-18 Fix ALL sketch-plane conventions from measured probe data
    tools/plane_probe_result.txt (Fusion's own numbers):
    xY: U=+X V=+Y extrude=+Z (as assumed - why 95% of the box was fine)
    xZ: U=+X V=-Z extrude=+Y (Z FLIPPED)
    yZ: U=-Z V=+Y extrude=+X (Z FLIPPED and axes swapped)
    Both non-xY planes flip Z. The previous guess fixed Y and left Z negative,
    which is literally why the cap seat pads sat under the box ('the buttons are
    all down'). The xZ finding is new and worse: the tub's six FRONT lid-seat
    pilots had been mirrored to -Z, i.e. below the floor, since that seat was
    written - the BottomLid screws had nothing to bite.
    - cyl_x/poly_x (yZ) and cyl_y/box_y/poly_y/yport (xZ) fixe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
2026-08-18 Four cap screws (two per side), integral mounting flanges, centred screen
    - Cap closure: 8 screws -> 4, two per side wall at Y+-85 (owner: 'two sides
    each, not four'). 170mm clamping base, clear of the detents, strap lugs and
    corner radius; the back edge keeps its two snap detents.
    - Wall mount redesigned for the third time, now to the commercial-enclosure
    standard: four INTEGRAL FLANGES on the tub's back corners (Z14/Z54, 24mm
    proud of each side wall) with 5.5mm holes in 2mm levelling slots for M5/#10
    anchors at X+-152. Back faces at Y-144 clear the cap skirt and the back
    detents, so the box rests on the ears; tops at Z62 stay under the skirt.
    No fastener enters the box. FIR_W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
    [Freeispbrain cover plate.stl, Module base.f3d, Module base.stl, Overhang.stl, box.stl, brainouter part.stl, completed.f3d, completed.stl]
2026-08-18 Panel-style wall mount (floor on the wall) + delete the horn curb
    Owner clarified the mounting orientation: the box is a WALL PANEL. Its
    280x280 FLOOR lies flat against the wall and the box stands 120mm out, so the
    cap - screen and LEDs - faces the room. Model +Z therefore points OUT of the
    wall, not up, and the wall contact face is the floor underside at Z0. Every
    previous mount assumed the box hung off its BACK wall, which is why none of
    them could mount anything.
    - Four floor-plane tabs at Y+-90 on both sides, projecting 24mm past the side
    walls, undersides coplanar with the floor; M5/#10 anchors at X+-152 in 2mm
    levelling slots; each gusseted 12mm up the side wall against the peel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
2026-08-18 Record internal retention as settled for the wall orientation
    Owner confirms the cradle snaps, extension-strip lips and adapter strap were
    designed for the panel orientation and hold their parts trapped in shear by
    intent. The scripts now state this as a decision instead of flagging it as an
    open risk, so nobody redesigns retention for a floor-standing box.
2026-08-18 Mount fits the Ender 3 Plus: six thick counterbored anchors through the floor
    The projecting tabs made the tub 328mm wide - unprintable on a 300x300 bed,
    and the slicer would have been the first to say so. Nothing may now grow
    outside the 280 footprint.
    - Six M5 anchors THROUGH the floor at X+-129, Y-125/-20/+105 (how back-panel
    enclosures are normally fixed). Each sits in a D22 pad that grows into the
    side wall, head counterbored flush so nothing stands proud inside.
    - Pad thickness is per-anchor and as thick as the part above allows: 3.5mm
    (6.5mm of floor, 4mm under the head) at five anchors, 2.0mm at the one
    under the MikroTik (underside Z6.5). Six screws, not four, for the peel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
2026-08-19 The box hangs: two wall rails, floor keyholes, outside-only fixings
    Owner picked the separate-plate route because the box must come off the wall
    without being opened or gutted, and asked that the floor still print dead
    flat on the bed.
    - NEW FIR_WallRails: two 274x55x5 rails instead of one 274-square plate (that
    would have been a ~250g warp-prone print). Top rail carries two studs
    (D9 shaft, D16 head, 3.4mm standoff) plus a 14mm upstand with two M4
    anti-lift holes; bottom rail is a plain spacer 231mm below that keeps the
    box square. Three countersunk M5 wall screws each.
    - Tub: two keyhole slots at X+-129, locked Y-125 / entry Y-105, with local
    floor thickening and a counterbore o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
2026-08-19 Simplest possible wall mount: two keyholes in the floor, like a router
    Owner: 'just go for the simpler mount, the one in extensions or even in the
    951 where there is a hole and we just fit our box in.'
    - Two keyholes in the tub floor, 258mm apart: round entry passes a screw head
    up to ~11mm, box drops 15mm, the 5.5mm slot traps the head. Two wall screws
    and nothing else - FIR_WallRails and FIR_WallPlate are both deleted, and the
    harness now fails if any bracket/plate/rail part reappears.
    - Each head hides in a 16mm pocket cut 3.5mm into the floor's OUTER face, so
    the box lies flat on the wall; 3.0mm of floor carries the load (local pad
    takes the floor to 6.5mm there).
    - The flat-f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
2026-08-19 Blind keyholes: the mount is now closed, nothing passes through the floor
    Owner: 'it should not be pass through inside, it should badge or something so
    that no water can enter via that - it should be closed.'
    - The keyhole is a BLIND undercut. The screw head ends up buried inside the
    floor's own thickness: 2.0mm outer skin (carries the box; the entry hole
    and the 5.5mm shank slot are cut only through this), 3.5mm head channel,
    and a 2.0mm inner skin that is NEVER cut. No screw and no water path
    enters the sealed volume. Local pad takes the floor to 7.5mm there.
    - ShellCheck draws the wall screws stopping inside the floor, so the render
    matches reality: nothing crosses into the box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
2026-08-19 Curve the front cover from the roof down, hiding the busy middle seam
    Owner: 'make it curved actually, from the top - cover the roof - down to the
    bottom; it will reduce the confusion at the middle, there is a lot going on
    there.' He is right: the cover top, the BottomLid groove/tongue and the cap
    front wall all stack around Z83.
    - FIR_CurvedLid v5 grows a curved shoulder off the top of its front panel: a
    quarter ellipse, tangent-vertical leaving the panel and tangent-horizontal
    landing under the cap roof, from (Y205,Z83) to (Y143.5,Z117) - flush with
    the roof line and 0.5mm clear of the cap skirt. The front now reads as one
    surface and every fussy joint sits behind the curve.
    - Bui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
2026-08-19 Seamless cover-to-cap joint: flush surfaces, one 0.3mm shadow line
    Owner wants the Ubiquiti look - 'you won't know there is a joining'. The
    shoulder previously stopped under the roof edge, leaving a 3mm step plus a
    gap (his close-up showed exactly that).
    - The shoulder now rises to Z120, FLUSH with the roof's outer surface, and
    its tip butts the roof edge at Y143.3 with a single 0.3mm shadow line.
    Flush planes + hairline gap + clearance hidden behind the surface = the
    commercial seamless joint.
    - Numbers moved to the contract (COVER_SHOULDER_*); validate() enforces the
    flush plane (Z120 +-0.05) and a 0.2..0.6mm hairline.
    - ASSEMBLY ORDER: the cover slides on LAST, after the cap - dr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
2026-08-19 PROJECT_STATE: print-ready status block - order, hardware, open items, final decisions
2026-08-19 One script per part: FIR_TopLid split out; horn bolts direct; cover-only tamper
    Owner, 19 Aug: 'give me FIR bottom lid, FIR top lid, FIR curved lid' - one
    printable part per script; 'why is there a horn sled - just two buttons to
    tighten the horn on'; and the magnet senses the curved lid, not the top lid.
    - NEW FIR_TopLid: the deep cap alone (seated screws, detent windows, chamfer,
    brain bosses, indoor screen window + LEDs), builds at the origin. FIR_Shell
    v43 now builds ONLY the tub; harness asserts exactly one body.
    - Horn: sled and cage retired. Two 14mm floor pads under the foot's REAR
    holes, M4x10 direct, apex hole unused (owner decision). Foot plane stays
    Z9, so every horn cle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
2026-08-20 TftShieldID: first-contact sketch for the 3.5in parallel TFT shield
    ID-register read + all-pixels-on aliveness flash + resistive touch
    plate probe, over 15 dupont wires from the expansion board.
2026-08-20 TftShieldID: remap to reachable sockets only (J4+J5+U4+J14)
    Bottom-row headers are blocked on the mounted board; the four
    connectors Francis can reach expose exactly the 13 GPIOs needed.
2026-08-20 TftShieldID: keep Francis's existing 11 wires, slot the 4 missing lines
    D7/RD/WR/RS move to the free holes (J4 CS, J4 DC, J14 D14, J14 D12);
    the already-wired J4 BLK=CS and J4 RST=RST stay exactly as placed.
    [TftShieldID.ino]
2026-08-20 ILI9486 confirmed; TftShieldDemo: real driver + measured-plate touch
    ID run came back 66 00 94 86. Touch plates measured on LCD_D0+LCD_RS
    and LCD_D3+LCD_D4, so RD/D4 swap wires to give D4 an ADC pin. Demo:
    LUT-driven par8 ILI9486 driver on Adafruit_GFX, color bars, paint
    area, three tap buttons (RIGHT sits in the weak third on purpose).
    [TftShieldDemo.ino, TftShieldID.ino]
2026-08-20 Touch sense plate is cracked into two islands - listen on both ends
    Session 1 (sense on LCD_D0/GPIO16) heard only the left side; the next
    build (sense on LCD_RS/GPIO12) heard only the right. One hairline
    crease = two islands, each reaching one end wire. Pull up both ends,
    report p16/p12 separately on glass + serial.
    [TftShieldDemo.ino]
2026-08-20 Software ohm-meter on the film paths; LCD_D4 joint is the new suspect
    Right-side press pulls BOTH sense ends low, so the sense sheet is not
    cracked. Every failing configuration shares the LCD_D4 line, twice
    re-plugged; decay timing now shows each path's health on the glass.
    [TftShieldDemo.ino]
2026-08-20 No-wires-touched isolation: chip ID readback + press-assisted Y probe
    Per Francis: prove the jumpers in software. The ILI9486 shares the
    suspect lines, so a clean 0x9486 readback exonerates GPIO->pin for
    every wire; k19/k2 show which Y end still reaches the sheet when a
    press bridges it to the grounded X plate.
2026-08-20 Touch fixed in code alone: never sense on GPIO2 (onboard LED clamps it)
    The regression was one pin. The first working run had LCD_D4 on GPIO21;
    the RD/D4 swap moved it to GPIO2, which carries the devkit blue LED.
    That clamp is what faked tY=5000 open and killed rawX - not a broken
    joint or a cracked film. Drive GPIO2, sense only on GPIO12: the exact
    path that tracked a finger on day one. Single axis + press, marker bar
    and three live zones on the glass. No rewiring.
    [TftShieldDemo.ino]
2026-08-20 Touch mapping: invert direction and learn the window from the swipe
    Right pressed read as left (raw counts down going right) and the fixed
    300..3700 guess squashed the real range into half the bar. Now the
    window starts inverted and the first edge-to-edge swipe defines it;
    the glass says SWIPE EDGE TO EDGE until the span is trustworthy.
    [TftShieldDemo.ino]
2026-08-20 Guided 3-tap calibration: learn the film signature per button
    The raw curve flattens left of mid-glass, so window mapping cannot
    work. Hold-tap RIGHT, MID, LEFT once; presses then classify by the
    nearest learned value. Learned centers shown on glass, with an OVLP
    warning when two buttons are electrically indistinguishable.
2026-08-20 Use the DOCUMENTED MCUFRIEND touch pins - the probe had them wrong
    Library docs: these shields carry the film on A1/A2/D6/D7 = LCD_WR,
    LCD_RS, LCD_D6, LCD_D7. My probe reported LCD_D0 + LCD_D3/D4, so we
    were driving plain data lines and reading a phantom gradient - the
    real cause of the non-linear flattening at mid-glass.
    Both analog reads land on ADC pins with the existing wiring, so full
    2D touch needs no rewiring. CS is raised during touch reads so the
    borrowed WR line cannot latch garbage into the controller. Adds a
    3-tap calibration that also resolves axis swap and direction.
    [TftShieldDemo.ino]
2026-08-20 BigUI: the FreeISP touch face on the 3.5in screen
    Creality-style front end on the proven ILI9486 + touch stack: a
    dashboard home (headline numbers, router pill, five drawn RJ45
    sockets) in HelloScreen palette, then finger-driven menus - WiFi scan
    with signal bars, on-screen keyboard, join, info, recalibrate.
    WiFi credentials go to NVS "freeisp" (wifi_ssid/wifi_pass) so the main
    firmware can read them - no more recompiling to change network. Touch
    calibration is stored too, so the 3 taps happen once in the product's
    life.
    Documents the ADC2 constraint: the radio is dropped while the keyboard
    is open, menus are full-width rows, and the PCB-rev fix (LCD_RS->GPIO32,
    LCD_WR->GPIO33) is written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
    [BigUI.ino]
2026-08-20 BigUI: boot straight to the dashboard; catch a stuck touch panel
    No calibration chore on first boot - factory defaults are built in and
    Settings keeps a Calibrate row for the odd panel. Adds a touch trace
    (z1 rises AND z2 falls on a real press; z1 alone cannot tell a press
    from a stuck line) and a boot check that says so on the glass instead
    of silently swallowing every tap.
    [BigUI.ino]
2026-08-20 Diagnose the touch panel properly: both plates read OPEN
    Measured, not guessed. Idle ADC on both sense pins rails high, which
    looks identical to a hard press - so the earlier "stuck pressed"
    reading was wrong. Testing the plates directly (pull one end up,
    drive the other low) shows X and Y plates BOTH open: the film is not
    reaching the board at all, while the display is perfect, because the
    film shares the LCD header pins.
    Also proves the ADC2/radio conflict on the bench: with the radio up
    both sense pins read 0, and recover when it is shut down.
    Replaces the misleading stuck-touch screen with a live plate readout
    so the ribbon can be re-seated and watched until it says OK.
    Co-Authored-By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
    [BigUI.ino]
2026-08-20 The panel was fine - linking WiFi is what killed the touch reads
    TftShieldDemo drives this exact film perfectly. The only structural
    difference is that BigUI links WiFi, and both touch sense pins
    (GPIO12, GPIO14) are ADC2, which the radio owns. Measured: radio up
    -> both read 0; otherwise -> both rail at 4095. Neither is a real
    reading, which is why every tap looked like a stuck press and why the
    plate test called a healthy film "open". Wrong conclusion, twice; the
    hardware was never at fault.
    Drops the misleading stuck/plate screens, bakes in the vertical
    calibration measured off the real film, and adds TOUCH_VERTICAL_ONLY:
    full-width bands and rows driven by the one axis we can rescue ont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
    [BigUI.ino]
2026-08-20 Keep idle-high signals off GPIO12: it is the MTDI strapping pin
    My half-fix instruction put LCD_CS on GPIO12, which idles HIGH. GPIO12
    is sampled at reset to pick the flash voltage, so a high there makes
    the chip refuse to program - exactly the upload failures that followed
    the rewire, and precisely what pcb/PINOUT.md warns about.
    GPIO12 now carries LCD_RD (nothing pulls it up, so the pin falls to its
    own pulldown at reset) and LCD_CS moves to GPIO21. Touch pins are
    unchanged: sense stays on GPIO33/ADC1 so it survives WiFi.
    Also routes the RS strobe through the high-bank GPIO register, since a
    1UL<<33 into the low-bank register silently does nothing.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
    [BigUI.ino]
2026-08-20 Touch: this panel's pressure reading runs backwards
    Measured: the sense line rails at 4095 untouched and FALLS to about
    620 under the stylus. Every press test in this sketch asked for a rise
    above a threshold, so the panel read as permanently pressed and every
    real tap vanished inside it. Press is now "clearly below the resting
    level", and the resting level is measured at boot instead of assumed.
    Verified on the board: idle 4095 against a 3295 threshold now reports
    idle, and a stylus press reports pressed.
2026-08-20 Fix streaked fills (bus timing) and re-calibrate after the rewire
    Large fills were shot through with horizontal noise while text looked
    fine: over 15cm of dupont the data lines settle slower than the WR
    strobe, so big runs latched half-old bytes. Give the data setup time
    and the strobe real width.
    Touch could not land because the baked-in numbers were measured with
    the sense line on GPIO12; it is on GPIO33 now, a different ADC with a
    different scale. Adds a two-tap vertical calibration (full-width bars,
    hittable however wrong the current numbers are), stored in NVS and
    printed so the result can become the factory default.
    [BigUI.ino]
2026-08-20 Isolate the touch fault: panel proven good, big sketches read frozen
    TouchProof.ino (minimal, no WiFi) reads 0 idle and ~830 pressed on the
    fitted wiring - re-confirmed as a control after every change. The panel,
    the film and the rewire are all good.
    Every larger sketch reads a frozen 4095 from the same pin using the same
    copied functions. Ruled out by measurement, not theory: WiFi (FaceUI
    links none and still fails), ADC2 interference (removed), legacy-vs-new
    ADC driver (aborts at boot, reverted), explicit ADC attachment, ADC
    warm-up, and paint-before-read ordering.
    Left in place for the bisect: TouchProofWifi (the same sketch plus the
    WiFi include, which still reads correctly) and FaceUI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
    [BigUI.ino, FaceUI.ino, TouchProof.ino, TouchProofWifi.ino]
2026-08-20 FOUND IT: touch reads must not be taken back to back
    The sense node stays charged from the previous conversion, so a tight
    loop of pressure reads returns a frozen 4095 - identical to a dead
    panel, which is what sent every earlier diagnosis wrong. TouchProof.ino
    only ever worked because its loop happens to interleave a Y-plate read
    and a screen draw between pressure reads.
    Interleave a zRead (and let the lines settle) before every yRead, and
    during warm-up. Result on the bench: idle z drops from a frozen 4095 to
    a true 0, and presses register.
    [FaceUI.ino]
2026-08-20 Cable-notch skins: one layer (0.2mm) - they were hard to cut out at 0.55
2026-08-20 Cable-notch skins to 0.1mm - the lightest, effectively pre-opened
2026-08-20 Knockout cable notches: outline perforated through, blank on two 0.35mm hinges
    Owner: 'foil style... not a real layer, for easy removing to add a cable.'
    Electrical-box style punch-outs: each notch outline is slotted right through
    the wall (0.7mm perforation), the full-thickness blank stays on two 1.6mm
    hinge tabs of 0.35mm - push with a fingertip and it pops out clean. Unused
    notches stay closed and solid. Harness counts every slot and hinge.
2026-08-21 Front-corner coupon set: test the busy bottom-end stack before any big print
    Owner: printing the whole tub and lid to test fit would be a waste - give me
    the tail end of the bottom side of both.
    - FIR_FitCoupons v2 adds pair 4: 65-70mm front-corner slices of the TUB
    (side wall + wall end face + top rail + both lid-seat bosses with pilots +
    the Y85 cap-screw boss/pilot) and of the TOP LID (skirt with seat pad,
    counterbore and screw hole at Z72, shortened front wall, roof edge,
    lead-in chamfer).
    - Pair 3b (cover slice) now includes the curved shoulder segment + end cap,
    so the 0.3mm seamless landing on 4b's roof edge is part of the test.
    - Full miniature assembly: screw 3a onto 4a,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
2026-08-21 FIR_TailSlices: the REAL tub and top lid, cut to their bottom-end strip
    Owner: 'print the whole box then slice the last tenth - as easy as that, not
    just parts.' So no hand-drawn coupons: this script runs the ACTUAL FIR_Shell
    and FIR_TopLid builders, then cuts away everything except shell Y>=70 - the
    last ~70mm where the whole front closure lives. What prints IS the real
    geometry.
    - Tub tail keeps all six BottomLid bosses, both Y85 cap bosses, the top
    rail, wall end faces and the switch cradle; cap tail keeps the seat pads,
    screen window + LED holes, front wall, chamfer and the roof edge.
    - Test: screw the REAL BottomLid on (six screws), slide the REAL CurvedLid
    home, drop the cap tai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
2026-08-21 Tail slices become small corner blocks, one body per print
    Even smaller (owner): the slices now keep only the busy corner - shell
    X>=60, Y>=70, about 80x70mm each - and each is a separate body exported and
    printed on its own. The cap block keeps its local -X corner so the assembly
    flip lands it on the same corner the tub block keeps; the two mate exactly.
    Fixed the cutter half-extent bug the harness probes caught (material
    survived between Y35 and Y70). All green, both trees.
2026-08-31 Cover self-click: rail detents so the sliding lid holds without its screws
    Francis printed the BottomLid and found what the source admitted: the rails
    were only a guide - nothing retained the cover until the two lock screws, so
    it slid straight back off. Same complaint the cap had, same cure.
    Each rail grows a stepped bump on its outboard face (0.8mm catch band toward
    the plate, 0.4mm lead-in toward the shelf front, lid z14-20, clear of the
    orientation key). Each of the cover's outboard channel ribs gets an 8mm gap
    at cover z47-55. Only the short rib tail behind the gap ever touches the
    bump - the slide stays free until the last ~14mm, rides up 0.5mm, and clicks
    into the gap at full seat. T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
2026-08-31 Joints that snapped now bend: ramped hooks, straps, feet, gussets
    Francis reports printed joints snapping and breaking off. The physics backs
    him completely: the cradle snap hooks were square 4mm-curl blocks with no
    lead-in ramp, so clicking a device in forced each 2.5mm post to bend the
    full 4mm - about 1.4% strain at a root made of stacked FDM layers. PETG
    layer bonds do not take that. They snapped as designed.
    The fingers are now designed for the material they print in. Hook curl
    drops to 1.8mm with a half-curl ramp band on top, so the device wedges the
    finger open gradually and peak root strain lands near 0.6%. A 1.2mm strap
    ties each hook down its post's outer face, converting the hook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
2026-08-31 The wobbly rail was standing on a wobbly floor: 8mm shelf spine
    Francis's photo shows the BottomLid rail flexing. The rail itself was never
    the weak part - it stands on a shelf that is a bare 3mm wall, 65mm tall as
    printed, and the whole foundation wobbles. Gussets at two points were not
    going to fix a 280mm wall.
    A 5mm doubler slab now sits on the shelf top, turning the wall into an 8mm
    spine everywhere the sliding cover never touches: its edges stop 0.6mm short
    of the channel-rib sweep at |x|=129.1, it splits around the magnet-pad and
    reed-wire corridor at -25..-5, and it ends at z50, clear of the lock bosses
    and the reed slot. Because it welds to the shelf top AND the plate face, it
    doub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
2026-08-31 TailSlices are now the two LIDS' last-eighth end strips
    Francis: the tail test prints should be the roof lid and the bottom lid,
    cut at the tail end - the last eighth of both. The old pair sliced the tub
    and the cap, but the tub is already printed in full and the BottomLid print
    carries the old weak-joint geometry, so the two parts worth slicing are the
    two lids.
    TAIL 1 is the real FIR_BottomLid cut to lid-local x<=-105 (35mm): the rail
    with its new detent bumps, the shelf-spine edge, the +-111 gusset, the
    orientation key, the lock boss and two of the six face screws - the exact
    end he photographed wobbling, in its strengthened form. TAIL 2 is the real
    FIR_TopLid cut to local x<=-109: that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
2026-08-31 TailSlices v4: the seam pair - the up and down of the one curved-lid joint
    Francis circled the strip in the top view where the CurvedLid's shoulder
    lands on the TopLid's roof edge and said: this is the only part I want, one
    piece or two - the up and down. That joint is the only place the curved lid
    touches the roof, and it is exactly the joint a narrow coupon cannot prove:
    a curve that mates at one end and gapes at the other from FDM bow only shows
    itself at full width.
    TAIL UP is the real TopLid cut to cap-local y>=105 - the roof edge, front
    wall and chamfer, 38mm deep, printing roof-down flat. TAIL DOWN is the real
    CurvedLid cut to cover-local y>=20 - the upper face band, top wall, locato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
2026-08-31 TailSlices v5: 20mm of both lids + the shoulder - the whole triple joint
    Owner refinement mid-flight: "just like 20mm of the last part, both the
    bottom and top, so that I can fit together and also try fitting the curved
    one." That is the complete front-closure joint: the cap's front wall rides
    0.5mm above the BottomLid's build-out, the curved lid's locator tabs drop
    into the BottomLid's groove, and its shoulder lands flush on the cap's roof
    edge with the 0.3mm hairline.
    Three full-width strips now: TAIL TOP (roof lid, cap y>=123 - 20mm of roof
    edge plus front wall), TAIL BOTTOM (bottom lid, y>=63 - the build-out with
    the full-width tab groove, clip tabs and all four y72 face screws), and
    TA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
2026-08-31 TAIL BOTTOM flips to the end with the standing walls
    Francis, looking at the strips: "it's not there - where are the things that
    are standing up, the walls, the vertical ones?" He wants to slide his curved
    lid onto something, and the flat 4-screw bar from the lid's TOP edge was the
    wrong end for that. The bottom lid's working end is the other one: the 68mm
    shelf with its new 8mm spine, both rails with their detent bumps, the
    orientation key and both lock bosses with the hard end stop.
    TAIL BOTTOM is now the real FIR_BottomLid cut to lid-local y<=20: a 20mm
    plate band carrying every standing wall of the slide interface, full 280
    width. The cut runs through the port openings, which is cosmeti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
2026-08-31 TailSlices v7: strips of the BIG BOXES his printed lids bolt to
    Francis, holding his printed BottomLid: "I already have this piece - where
    the piece will be BOLTING, that is the issue. The parts we are slicing come
    from the two main big boxes, just 20mm of them." He owns both lids in
    plastic; every strip so far sliced the lids again. What he needs is the
    OTHER side of each joint.
    TAIL TUB is the real FIR_Shell tub cut to shell y>=112: the floor edge,
    both wall stubs, the top rail and ALL SIX BottomLid seat bosses with their
    pilots - the piece his printed port face screws onto, six real screws into
    real bosses. TAIL ROOF is the real FIR_TopLid front strip (y>=123): the
    roof edge his printed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
2026-08-31 Lid-seat bosses reinforced: he pointed at all six and said they will break
    He is right, and the numbers agree: the four rail bosses hung off the 3mm
    top rail by a 9x4mm neck - 27mm2 of printed cross-section taking the full
    push and torque of a driven screw. The wall pair was five times stronger
    and still bare.
    Fix in the one place that feeds everything (build_lid_seat in FIR_Shell, so
    the main tub AND the TAIL TUB test strip both get it): the top rail grows
    downward to 16mm tall so every boss welds to it over its full height -
    triple the neck - and each boss gets a stepped under-gusset carrying the
    screwing push down into the rail like a bracket. The wall pair gets the
    same gussets onto the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
2026-08-31 Two pieces, on the bed, each one whole
    His slicer screenshot: the exported strips landed scattered across the
    plate because the bodies were parked at big model offsets, and grouped
    imports could not be oriented independently. Both bodies now sit flat near
    the origin - TAIL TUB centred, TAIL ROOF just behind it - so each STL lands
    on the bed where it belongs. The popup now says it plainly: export ONE BODY
    AT A TIME, two files, two independent pieces to orient freely.
    Also hardened the geometry for meshing: the reinforced rail extension now
    runs 1.5mm INTO each side wall instead of kissing it face-to-face, so the
    strip can never export as separable shells. Harness probes updated to the
    new po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
2026-08-31 FaceUI grows up: calibration remembered in NVS, every band tappable
    The two-tap vertical calibration now saves to NVS (fresh vcal_* keys --
    everything stored before the rewires was junk) and is skipped on boot
    when the stored pair passes the same validator that accepts it, so the
    box asks once, ever. The cal screen shows the live z number while you
    press, and a railed tap is rejected on the spot instead of mis-mapping
    the whole session.
    Every y from 0-319 now lands on exactly one target on every screen:
    BACK owns the header gutter, the Info row soaks up the bottom strip,
    the dead 44-51 band is gone, and every tap flashes. A press held past
    the escape timeout no longer re-fires its row every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
    [FaceUI.ino]
2026-08-31 Calibration his way: 3 crosshair targets, hold-to-capture, prove-then-save
    Francis called both faults on the bench: SETTINGS would not open, and
    "you would have had points on corners and the middle that I touch".
    Done exactly that. Three staggered crosshair targets (top-left, centre,
    bottom-right), each press-and-HOLD -- up to 7 median rounds across the
    hold, median-of-medians as the anchor -- so one soft dab can no longer
    tilt the whole map the way it did the 2-bar version (770/401, span so
    thin the bottom of the glass was squeezed shut).
    The middle anchor turns the map piecewise: two segments hinged at
    y=160, signed math, both directions. And the map is only SAVED after
    a real tap lands o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
    [FaceUI.ino]
2026-08-31 Stop guessing the touch axis: 4-corner probe, softer press detect, tap medians
    Three bench rounds tonight, each teaching something:
    1) Quick taps read the unseated film and landed high, so taps now take
    the median of rounds spanning the whole contact -- and the 50ms
    "seat first" experiment proved the opposite trap: the firm phase
    reads PRESSURE, not position (all three targets converged to the
    same number). Sample from first contact, median across the press.
    2) Francis pressed everywhere: bottom of the glass never registered
    and the bottom target kept failing its hold. Position leaks into
    the pressure read, so the fixed 400 margin wrote the bottom off the
    map. Press de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
    [FaceUI.ino]
2026-08-31 Grid calibration + stop inventing touch primitives
    Francis's grid, and the fix for why nothing registered.
    THE BUG, from his own bench report: "press the points and z is 0,
    press anywhere else and it presses well". zRead IS the position
    gradient, and at the XP end of the glass that gradient reads 0 --
    which is exactly what an untouched panel reads. A press there is not
    weak, it is INVISIBLE. That end is the bottom. That is why SETTINGS,
    and only SETTINGS, refused every single time tonight.
    Four detectors were tried against it. Three were inventions and all
    three failed on real hardware: an inverted-polarity twin, a digital
    pullup contact test (never saw a finger), and Adafruit's own two-pi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
    [FaceUI.ino]
2026-08-31 Touch registers at last: threshold 120, and stop faking a second axis
    First real press captured on the bench: A=951 B=955, with idle tracing
    a clean 0. Detection works.
    Two fixes behind it. Francis: "even a 200 touch should register" --
    the 260 gate was dropping his lighter presses, so it is 120 now (enter)
    / 60 (exit), still far above an idle that reads a flat 0.
    And: "if you press a box it shows you have pressed a different box".
    Correct, and my fault -- the grid claimed two coordinates when only
    one read is a real position. yRead drives one plate and reads the
    other; zRead is the pressure config and only wobbles with position, so
    using it as the column planted the highlight nowhere near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
    [FaceUI.ino]
2026-08-31 The draw IS the fix: both touch signals hold a steady 0 at last
    Signals now rest at XM=0 y=0 for minutes on end -- exactly what
    TouchProof.ino measured on this panel -- instead of railing to 4095
    within seconds. A press should lift them to ~830.
    The hunt got there through four wrong answers, all recorded in the
    source so nobody repeats them:
    1. The endless grid loop lived in setup(). setup() never returning
    starves the loop task's watchdog, so the box silently rebooted
    mid-session. Diagnostics that reboot are worse than none.
    2. calibrate() ALSO still ran from setup() and waits for a press, so
    the glass sat on the old crosshair screen with serial dead. Every
    "no output" reading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
    [FaceUI.ino]
2026-09-01 Drop the 3x skew rule: it was rejecting good calibrations
    With the grid-diagnostic lock lifted and the ADC2 read out of the boot
    path, real presses finally came back varying and correctly ordered --
    and calibration still refused them twice. The validator was at fault,
    not the panel: 1241 / 1088 / 458 was thrown out purely because the
    lower half of the glass spanned 630 counts against the upper half's
    153.
    That is not a defect. It is exactly the uneven panel the PIECEWISE map
    with its middle hinge exists to absorb, so demanding even halves
    defeated the hinge's whole purpose. Railed reads are already discarded
    upstream (>4000), so correct ordering plus a minimum span is all the
    sanity this ne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
    [FaceUI.ino]
2026-09-01 Poll with real drawing: the reason SETTINGS was dead and calibration was not
    Francis: "if i click setting nothing is working, it only worked when
    calibrating." That asymmetry is in the code, not the finger.
    calibrate() polls while constantly repainting its live z readout. The
    product loop polled every 15ms and drew four pixels a second. Measured
    on this board earlier tonight: a poll loop with no bus traffic rails
    BOTH touch signals to 4095 within seconds, while heavy redrawing holds
    them at a flat 0 for minutes. Railed reads are discarded upstream as
    the charged-node artifact -- so on Home, no press could ever register,
    while the same finger on the calibration screen worked fine.
    Every pol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
2026-09-01 Handoff brief: everything measured about the FaceUI touch panel
    Written so the next engineer does not repeat tonight's dead ends. Covers
    the frozen pin map, what is proven working (calibration, NVS, mapping
    arithmetic), the open bug, six measured facts about this panel, and the
    four traps that produced fake 'touch is broken' evidence -- watchdog
    reboots from an endless loop in setup(), a blocking calibrate() in
    setup(), a release threshold under the noise floor, and 4095 artifacts
    counted as presses.
2026-09-01 Bench evidence kills my own bus-work theory
    Flashed the instrumented build and captured 108 consecutive UI idle
    lines on Home with the glass untouched:
    UI idle: XM=0 y=0 dev=0 down=0 streak=0
    XM and y hold a FLAT 0 on the normal UI. They do not rail to 4095. So
    redraw volume in the product loop is not the cause of the dead taps,
    and my "the draw is part of the touch circuit" explanation does not
    apply here. Detection is healthy on Home; the fault is downstream.
    Recorded in the handoff brief as a disproof rather than deleted, so
    nobody re-runs the experiment. Still missing, and it is now the only
    missing measurement: serial captured DURING a press on Home, to tell
    "press produces no si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
    [FaceUI.ino]
2026-09-01 Brief taps do not read position at all: hold-to-select + reject poor contact
    Measured, and it reframes the whole problem. Anchors captured by
    HOLDING read 997 / 645 / 282. Quick taps anywhere on the glass --
    including on the top rows -- come back 3..251. So a light tap on WiFi
    (top row) and one on Info (bottom row) are indistinguishable: both
    collapse to the bottom of the scale. That is why every row selected
    Info, and it is not an off-by-one offset that a better map could fix.
    The reading is contact-dependent, not purely position-dependent. Only a
    sustained hold -- the regime calibration uses and gets right -- returns
    a position related to the finger.
    Two changes while that is understood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
    [FaceUI.ino]
2026-09-01 The real bug: a yRead taken immediately after a zRead reads collapsed
    SettleTest.ino settles two questions at once. Light presses at top /
    middle / bottom of the glass:
    200us=1070 1ms=1079 5ms=1089 20ms=1094 (top)
    200us= 533 1ms= 571 5ms= 579 20ms= 579 (middle)
    200us= 176 1ms= 181 5ms= 181 20ms= 188 (bottom)
    1. The settle-delay hypothesis is DISPROVED: 200us to 20ms moves the
    same reading by 2%. Source-impedance settling is not the mechanism.
    2. Far more useful: a LIGHT press reads TRUE POSITION -- 1070/533/176
    is a clean gradient. The panel is not force-dependent after all, and
    hold-to-select was never necessary.
    What SettleTest does that FaceUI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
    [FaceUI.ino, SettleTest.ino]
2026-09-01 BoxCal: Francis's A..P boxes, and the panel's resolution limit measured
    His design, and it works. Walk the boxes one at a time, press the middle
    of the highlighted one, record what that part of the glass reads, then
    match live taps to the NEAREST anchor -- no line fit, no extrapolation,
    no piecewise hinge. The arithmetic that kept sending presses to the
    wrong row is simply not needed when every box has been measured.
    8-box run: A=943 B=917 C=823 D=688 E=601 F=458 G=273 H=149
    16-box run: A=959 C=912 D=895 E=841 F=766 G=689 H=650 I=606
    J=529 K=460 L=401 M=336 N=274 O=200 P=121
    15 of 16 boxes are reliably hittable, tap error typically 2..30 counts.
    The one failure is measured, n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
    [BoxCal.ino]
2026-09-01 The real wall: the position reading's SCALE depends on the code path
    Not a calibration bug, and not the panel. Same glass, same finger, three
    captures:
    calibration walk (calm, 80ms polls) 2688 .. 3613
    product loop, repaint 12ms before read 66 .. 658
    product loop, no repaint before read 3678 .. 3925
    The walk itself is excellent -- monotonic, evenly spaced, repeatable, and
    correct within its own screen. What fails is that its numbers do not
    survive into a different code path. In the last build a press at the TOP
    read 3678, above the top anchor of 3613, so nearest-anchor sent it to the
    BOTTOM row: everything selects SETTINGS.
    Calibration and use are by definition di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
    [FaceUI.ino, GridCal.ino]
2026-09-01 The question, sharpened: same read function, four different scales
    Francis's observation is the key one and he is right: "when we had the
    rows, even 16 of them, we were able to touch even the smaller ones --
    it's not about pressing or the chip, the screen knows where we are
    touching it." BoxCal.ino resolved 16 rows at 15/16 on this exact panel.
    Resolution, pressure and calibration technique are therefore all ruled
    out as the cause.
    What remains is that the SAME primitives return a different absolute
    scale depending on the surrounding firmware:
    BoxCal standalone, 16 rows, working 149 .. 1011
    FaceUI calibration walk, clean table 2688 .. 3613
    FaceUI live taps in the produc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
    [FaceUI.ino]
2026-09-01 ANSWERED: the LCD image content dominates the touch reading
    ABTrace.ino, one finger held still at screen centre, sampling 300ms after
    each paint so the write burst itself is not a factor:
    screen DARK +300ms : z= 0 y= 0 (every sample)
    screen WHITE +300ms : z=4095 y=4095 (every sample)
    Three presses, four samples each, no exceptions. What is on the glass
    sets the reading; the finger barely gets a vote.
    That one fact explains the whole file. FaceUI shows bright cards and
    read 2700..4095; BoxCal and ABTrace show near-black screens and read
    150..1000 -- same panel, same primitives, same hour, no ADC config
    difference between them. The product UI's railing at 4095 was simply
    th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
2026-09-01 Screen bias measured and corrected; the walk now checks itself
    Two fixes, both straight from Francis's observations at the bench.
    1. THE SCREEN BIAS IS A CONSTANT, SO MEASURE IT ONCE.
    He asked the right question: if the grid walk is perfect, why is the
    UI hard? Because the walk never has to answer "where did he press" --
    it records a number for the box it told him to press. The UI must do
    the inverse, and that needs the number to mean the same thing later.
    It does not: anchors captured on the calibration screen read
    2667..3625, and the very same finger on the brighter Home screen read
    3987 -- about +350 above the whole table, which is why every press
    landed on the bo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
    [ABTrace.ino, FaceUI.ino]
2026-09-01 Request for help: the display content sets the touch reading
    A self-contained brief for an outside opinion. Leads with the one
    measurement that matters -- one finger held still, white screen rails
    the read to 4095 and black drives it to 0, unchanged two seconds after
    painting, so it is the steady-state image and not the write burst -- and
    with the cross-sketch table showing the same primitives returning
    149..1011 on a near-black screen and ~3960..3990 on a bright one.
    Lists what is already ruled out so none of it gets re-tested: settle
    time, ADC2, ADC config, force, Adafruit's pressure formula, thresholds,
    and four calibration schemes. Includes the traps that cost hours
    (pixel-by-pixel line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
2026-09-08 Rewrite the help request as a full escalation with the attempt log
    Francis asked for something to hand to a stronger model that can read
    the repo, including a chart of everything already tried so none of it
    gets repeated.
    Leads with the measurement that reframes the problem: one finger held
    still, white screen rails the read to 4095 and black drives it to 0,
    unchanged two seconds after painting -- so it is the steady-state image,
    not the write burst. Then the cross-context table showing the same
    primitives returning 149..1011 on a near-black screen and ~3990 on a
    bright one, which is why a clean calibration table cannot map a live
    tap.
    Adds a 36-row attempt log across four sections -- dete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
2026-09-08 BusTrace: the reading follows the LCD bus levels, not the image -- fix applied
    The experiment the independent review asked for, run as specified: one
    image painted and never repainted during a press, CS and RD high, no WR
    strobe, D0..D5 parked LOW / HIGH / released and re-applied before every
    conversion. 22 presses, dark and white images alternating.
    The pattern never broke once. Parked HIGH: 4095/4095 every sample,
    finger or not, either image. Released: floats to the same rail. Parked
    LOW: position-like readings, 0 with no finger, and the dark and white
    images produce overlapping ranges (59..828 vs 112..891). Steady holds
    gave three pairs within +/-10 counts (e.g. 348/351 347/347 352/349).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
    [FaceUI.ino]
2026-09-08 Validation after the bus fix FAILED; sweep staged; handoff written
    With D0..D5 parked LOW the 4095 rail is gone -- not one railed sample
    in seven minutes -- but what remains is too weak and unstable to
    calibrate. The 8-row walk never got past row 4: presses read 32..499,
    a single held press swung 499 -> 288 -> 87, eight presses produced no
    usable sample, and the surviving rows ran 37, 201, 288 -- increasing
    downward, where every earlier gradient on this glass decreased. A 5.7x
    swing under a stationary finger is not a threshold problem.
    Read with BusTrace: all-HIGH saturates the node, all-LOW starves it,
    and the only bus state that ever gave a clean 16-row gradient was 0x02
    (D1 = GPIO17 high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
    [BitTrace.ino]
2026-09-08 Add ESP32 touch electrode connection diagnostic
2026-09-08 Polish landscape UI while preserving working touch calibration
2026-09-09 FaceUI: commit the in-progress palette refresh so it is not lost
    Found uncommitted on disk after the other agent's f9ae322 UI polish: a
    new palette (deep navy background, cyan accent, warmer warn/ok tones)
    and includes for five Adafruit GFX FreeSans faces. The fonts are
    included but not yet applied to any text; the includes are harmless
    and the sketch compiles (371,720 bytes, 28%). Touch sampling, the v13
    calibration format and the stored anchors are untouched, per the
    README's instruction to preserve them across cosmetic changes.
    Committed as-is because unpushed work is at-risk work. Whoever picks
    the polish back up: the next step it was heading toward is setFont()
    on the headings, which n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
2026-09-09 Retract my three touch documents: the pin map they reason from was wrong
    TOUCH_HELP_REQUEST.md, TOUCH_BUSTRACE_RESULTS.md and
    FACEUI_TOUCH_HANDOFF.md now open with a superseded banner. The other
    agent's PinTrace scan measured the real electrode pairs as GPIO16/33
    and GPIO17/21 -- CS is a touch electrode -- so the declared map those
    documents build on was wrong on three of four pins, and every
    bus-level, image-coupling and parkBusLow() conclusion in them was an
    artefact of driving real film electrodes as though they were idle data
    outputs. The ADC axis is horizontal in landscape; vertical position
    comes from the drive-strength ratio method in FaceUI v13.
    Kept rather than deleted: the 36-atte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
2026-09-09 RowProof: a read-only accuracy series for the v13 touch path
    FaceUI v13 works by the owner's confirmation, and its README is honest
    that the one thing not yet established is error-free performance across
    positions and ordinary taps: the first independent check went 5/6 with
    the top row selecting row 2, on ratios about 3% apart. This measures
    that margin instead of guessing at it.
    The sketch is generated (gen_rowproof.py) by lifting the product's
    pins, electrode map, LCD driver and the whole v13 sampler out of
    FaceUI.ino verbatim, so it exercises the exact product path. It loads
    the product's saved anchors from NVS and never writes NVS, never
    calibrates, never adapts. Eighteen scripted targe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
    [RowProof.ino, gen_rowproof.py]
